huangzhu0423/esp32-waterer/docs/PCB.md

# 打板方案：主控载板与远端无源分线板

> **2026-11-12 更新：本文件现在讲两块板，别混。**
> - **先做 · 第十一节**：花盆区的**远端无源分线板**（RJ45 进 + 6× 3P 直插座出），已设计完、随时可下单。
> - **以后做 · 第十二节**：主控箱的**主控载板**，用户 2026-11-12 表示以后想打，规划中；5V 排针焊位与防倒灌在 **12.3**。
> - **零 ~ 十节**：配件到货前写的**分立 MOS 载板**设计，保留作资料（元件取值 / 66 条网表 / DRC 清单仍有参考价值），**不建议照着直接打**，差异见 **12.1**。
>
> 供电结论见 `docs/WIRING.md` 第三节：5V 默认走 **USB-C 取电线**，排针只在主控载板上留 NC 焊位。

## 零、结论与边界（分立 MOS 版资料）

**可以打，但别照这版打** —— 配件到货后已改用两块成品 YYNMOS-4 模块，见 **12.1**。第十节的「分配板」本质就是一块手工版本的 PCB，把 3 条汇流排、6 路 MOS、24 个阻容、全部端子固化到板上，飞线只剩探头线和泵线。

三条边界必须先划清楚，否则打回来的板装不上或不能用：

| 不进 PCB | 原因 | 正确做法 |
|---|---|---|
| ESP32 芯片 / WiFi 射频 | 射频布局、天线净空、阻抗不是 DIY 能一次做对的 | 用 **2×15 排母**把现成的 DevKit 模块插上去，坏了也能换 |
| 6 个水泵本体 | 大电流、要防水、要能单路更换 | 板上只留 **2P 可插拔螺丝端子** |
| 6 个探头本体 | 线要拉到花盆，长度不定 | 板上只留 **3P 可插拔端子** |

> **最容易被忽略的坑**：ESP32 DevKit 是板载 PCB 天线。载板在天线投影区域**绝不能铺铜、不能放元件、不能走线**，最好让模块天线那一端**伸出板边 5mm 以上**。不做净空，WiFi 会明显变差甚至连不上路由器，而远程页全靠 WiFi。

**排针中心距要实测**：30 针 DevKit 常见两排中心距 **25.4mm**，但也有 **22.86mm** 的窄版。下单前用游标卡尺量手上这块，再定两个排母的间距；排母用 2.54mm 间距、2×15。

## 一、板子规格

| 项目 | 取值 |
|---|---|
| 层数 | **2 层**（6 路低速直流，没必要 4 层） |
| 板材 / 板厚 | FR-4 / **1.6mm** |
| 铜厚 | 1oz 够用，**2oz 更稳**（泵 1.5A 峰值压降更小，加价不多） |
| 建议尺寸 | 约 **100 × 75mm**，压在 10×10cm 内打样最便宜 |
| 最小线宽 / 线距 | 0.25mm / 0.25mm（常规 6/6mil 工艺） |
| 过孔 | 0.6mm 孔 / 0.3mm 钻，盖油 |
| 表面处理 | 无铅喷锡或沉金；绿油白字 |
| 安装孔 | 4 × M3（孔径 3.2mm），四角各留 5mm 禁布区 |
| 打样 | 2 层 10×10cm 内通常是几十元 / 5 片、2~4 天出货，**以官网实时报价为准** |

## 二、板上集成什么

| 区域 | 内容 |
|---|---|
| ESP32 插座区 | 2×15 排母 ×2（或一条 2×15 双排座）、3V3 去耦、天线净空区 |
| 汇流排 | 3V3（VCC_S）、GND 地平面、5V_P 粗铜皮，横贯板中部 |
| 低边驱动区 | 6 × N-MOS + 每路 100Ω / 10k / 1N4007 / 100nF |
| 探头信号区 | 每路 100k 下拉，可选 1k + 100nF 的 RC 滤波 |
| 探头供电 | V1 留 6P 端子外接继电器模块；V2 焊 P-MOS 高边（见第六节） |
| 端子区 | 5V 输入 2P、泵 6×2P、探头 6×3P，全部可插拔 |
| 测试点 | 每路 Gate / AOUT 各 1 个，3V3 / 5V / GND 各 1 个 |

**丝印必须标**：`CH1`~`CH6`、每个 ESP32 引脚的丝印名（`VP/VN/D34/D35/D32/D33`、`D13/D18/D19/D23/D25/D26`、`D27`）、电解电容 `+`、1N4007 阴极方向、所有端子极性。装错一根线要拆半天，丝印是最便宜的保险。

## 三、网络表

完整逐行版见 [`pcb/netlist.csv`](pcb/netlist.csv)，画原理图时按它逐个核对，避免漏网。主干网络：

| 网络 | 从 | 到 | 线宽 / 做法 |
|---|---|---|---|
| `5V_P` | 5V 输入 + | 6 个泵端子 1 脚 | **≥2mm 铜皮或铺铜区**，1.5A 峰值 |
| `PGND` | 5V 输入 − | 6 个 MOS Source | 底层**整片地平面** |
| `PUMP1_N`~`PUMP6_N` | 泵端子 2 脚 | 对应 MOS Drain | ≥1.0mm，每路 0.8A |
| `GATE1`~`GATE6` | ESP32 泵脚 | 串 100Ω → MOS Gate | 0.3mm |
| `GATE_PD1`~`GATE_PD6` | MOS Gate | 10k → GND | 0.25mm，**上电不误开的关键** |
| `FLY1`~`FLY6` | 1N4007 阴极→泵 +、阳极→泵 − | 就近并在泵端子旁 | 0.8mm |
| `3V3` | ESP32 3V3 | 继电器 DC+ / COM（或 P-MOS S） | ≥0.5mm + 470µF |
| `VCC_S` | 继电器 NO（或 P-MOS D） | 6 个探头端子 VCC | ≥0.5mm |
| `AOUT1`~`AOUT6` | 探头端子 AOUT | ESP32 ADC 脚 | 0.25mm，**包地、远离泵线** |
| `AOUT_PD1`~`AOUT_PD6` | AOUT | 100k → GND | 0.25mm，必须有 |
| `SENSOR_PWR_CTRL` | ESP32 D27 | 继电器 IN（或 P-MOS G） | 0.3mm |
| `GND` | 全板 | — | 底层铺铜，多打地过孔 |

## 四、BOM

| 位号 | 元件 | 封装 | 数量 |
|---|---|---|---|
| U1 | ESP32 DevKit 30P 插座 | 2×15 排母 2.54mm | 2 |
| Q1~Q6 | N-MOS **AO3400** 或 IRLZ44N | SOT-23 / TO-220 | 6 |
| D1~D6 | 1N4007 | SOD-123 / DO-41 | 6 |
| RG1~RG6 | 100Ω | 0603 | 6 |
| RPD1~RPD6 | 10kΩ | 0603 | 6 |
| RAD1~RAD6 | 100kΩ | 0603 | 6 |
| RS1~RS6 | 1kΩ（可选 RC） | 0603 | 6 |
| CA1~CA6 | 100nF（可选 RC / 每路去耦） | 0603 | 12 |
| C1 | 470µF 电解（3V3 侧） | D6.3 / SMD | 1 |
| C2 | 470µF 电解（5V 侧） | D8 / SMD | 1 |
| C3 | 10µF（VCC_S 母线） | 0805 | 1 |
| K1 | 探头供电继电器模块（V1 外接） | 板上只留 6P 端子 | 1 |
| Q7 | P-MOS AO3401 / SI2301（V2） | SOT-23 | 1 |
| RPU | 10k 上拉（V2） | 0603 | 1 |
| J0 | 5V 输入 2P | 5.08mm 可插拔端子 | 1 |
| JP1~JP6 | 泵 2P | 5.08mm 可插拔端子 | 6 |
| JS1~JS6 | 探头 3P | 3.81mm 可插拔端子 | 6 |
| — | 测试点 / M3 铜柱 | — | 若干 |

> **MOS 选型别踩坑**：必须是**逻辑电平 N-MOS**，3.3V 栅极能完全导通。AO3400（SOT-23，约 5A）、IRLZ44N（TO-220）都行；**IRF520 不行**，它要 5V 以上才饱和，3.3V 驱动会半导通发热。

## 五、布局分区

```
┌──────────────────────────── 板框 100 × 75mm ────────────────────────────┐
│ 天线净空区（禁铺铜/禁元件，模块伸出板边）                                │
│  ┌──────────────┐        3V3 / GND / 5V_P 三条汇流排横贯                │
│  │  ESP32 插座  │   ┌──────────────────────────┐   ┌─────────────────┐  │
│  │  2×15 排母   │   │  Q1~Q6 + 100Ω/10k/1N4007 │   │ JP1~JP6 泵端子  │  │
│  │  （左侧）    │   │  低边驱动区（中部）        │   │ J0 5V 输入      │  │
│  └──────────────┘   └──────────────────────────┘   │ （右侧功率区）   │  │
│  ┌──────────────────────────────────────────────┐  └─────────────────┘  │
│  │ JS1~JS6 探头端子 · 100k 下拉 · K1/Q7 供电开关 │                       │
│  │ （下方信号区，远离右侧 5V 粗铜皮）             │                       │
│  └──────────────────────────────────────────────┘                       │
└─────────────────────────────────────────────────────────────────────────┘
```

**强弱电分区是硬要求**：右侧 5V 粗铜皮和泵回路，与下方 AOUT 信号线**不要平行长距离走线**，中间用地平面隔开。泵启停的电流突变会耦合进 ADC，表现为「一浇水其他路读数乱跳」。

## 六、两个版本，固件改动不同

| | V1 保守版（建议先做） | V2 全贴片版 |
|---|---|---|
| 探头供电 | 板上留 6P 端子，外接现有 JQC-3FF 继电器模块 | P-MOS 高边开关焊在板上 |
| 电路 | 端子：`DC+ / DC− / IN / COM / NO`（+ 3V3） | 3V3→P-MOS S，D→VCC_S，G→D27 + 10k 上拉到 3V3 |
| 固件 | **一个字都不用改**，不用重烧 | `config.h` 里 `SENSOR_PWR_ACTIVE_LOW` 由 `0` 改成 `1`，重编译烧录一次 |
| 优点 | 复用现有元件、零风险、已实测通 | 无继电器浪涌、无触点氧化、板子更小巧无声 |
| 缺点 | 板上多一块外接模块、有吸合声 | 要改一行固件并重烧 |

V2 的 10k 上拉很关键：复位期间 GPIO27 高阻，上拉把 P-MOS 栅极拉到 3V3（Vgs≈0）保持关断，探头不会意外上电。这和现有的 `config.h` 方案 B 描述一致。

**`PUMP_ACTIVE_LOW = 0` 两版都保持不变** —— 低边 N-MOS 高电平导通，板上和现在飞线完全一致。

## 七、下单前检查清单

1. **量排针中心距**（25.4 还是 22.86mm），核对排母封装
2. **天线净空区**确认无铜、无元件、无丝印覆盖，模块天线端伸出板边
3. DRC 通过；`5V_P` 与 `GND` 间距 ≥0.5mm，泵回路铜皮够宽
4. 所有电解电容、1N4007、MOS 的 **G/D/S 极性丝印**核对一遍
5. 底层 GND 铺铜，功率区多打地过孔；AOUT 线两侧包地
6. 每个网络在 `pcb/netlist.csv` 里都能对上，**尤其是 6 个 10k 栅极下拉和 6 个 100k AOUT 下拉**（最容易漏）
7. 导出 Gerber 后用 Gerber 查看器看一遍板框、孔径、阻焊开窗

## 八、板子回来怎么验

1. **空板**：万用表量 5V ↔ GND 不短路，所有 GND 全通
2. **只焊最小系统**：电源部分 + 两个排母 + 去耦，插 ESP32，USB 供电看能否启动、WiFi 能否连上
3. **焊 1 路**：Q1 / 100Ω / 10k / 1N4007 / 100k + JP1 + JS1，接 CH1 探头，验 `raw≈2600~2900 / flt=0`
4. **点浇水**：量 TP_GATE1 变 3.3V、泵转 15 秒；不接泵也能先量电压
5. **再焊其余 5 路**，每焊一路读一次 `/api/state`；逐路点浇水看其他路读数不跳
6. 最后补 470µF 电解（若第 2 步没装），确认继电器/P-MOS 吸合瞬间不复位

## 九、和第十节的关系

第十节是**不用打板也能落地**的手工版（万能板 + 端子台），本节是同一套网络的 PCB 版。两者引脚定义、元件取值、固件完全相同，可以先按第十节用万能板验证 1~3 路，确认方案没问题再下单打板 —— 板子一旦投出去，改一根线就要等一周。

## 十、成本估算

> 2026-11 查询嘉立创官网与公开报价，**实际以下单页实时报价为准**，免费券规则每月可能调整。

### PCB 本身

| 项目 | 价格 | 说明 |
|---|---|---|
| 2 层 FR-4，10×10cm 内，5 片 | **¥0**（免费券）或 **¥20 起**（付费） | 官网标注 FR-4 免费打样 ¥20.00 / 5 片起 |
| 每月免费券 | **2 次 × 5 片，包邮** | 1~2 层、10×10cm 内、板厚 1.6mm、铜厚 1oz、绿油白字、有铅喷锡 |
| **本板 100×75mm** | **完全落在免费条件内** | 2 层 / 1.6mm / 1oz / 绿油 |
| 2oz 铜 / 沉金 / 其他阻焊色 | 补差价约 **¥20~60** | 免费券只覆盖默认工艺，沉金实测有补 ¥28 的案例 |
| 付费单运费 | 约 ¥8~15 | 免费券通常包邮 |

免费券**有有效期**，正确顺序是：画完板 → DRC 通过 → Gerber 查看器检查无误 → 再领券下单。别先领券再慢慢画板。

### 元件（自购散买估算，以下单时 BOM 配单报价为准）

| 类别 | 数量 | 小计 |
|---|---|---|
| AO3400 SOT-23 ×6、1N4007 ×6、P-MOS ×1（V2） | 13 | ¥4~8 |
| 0603 阻容（100Ω/10k/100k/1k/100nF，约 36 只） | 36 | ¥4~8 |
| 470µF 电解 ×2、10µF ×1 | 3 | ¥3~5 |
| 2×15 排母 ×2 | 2 | ¥3~5 |
| 可插拔端子：J0 2P ×1、JP 2P ×6、JS 3P ×6 | 13 | ¥10~18 |
| M3 铜柱、测试点、杂项 | — | ¥3~5 |
| **合计** | — | **约 ¥27~49** |

ESP32 DevKit 和探头供电继电器模块手上已有，不计入。

### 三档总成本

| 方案 | PCB | 元件 | SMT | 合计 |
|---|---|---|---|---|
| **A. 空板 + 全手焊（推荐）** | ¥0（券）/ ¥20 | ¥27~49 | — | **¥27~49**（付费板约 ¥50~70） |
| B. 空板 + SMT 只贴 SMD | ¥0 / ¥20 | ¥27~49 | 工程费 ¥50 起 + 焊点约 ¥1 | **¥80~120** |
| C. 2oz 铜 / 沉金 + 手焊 | ¥20~60 | ¥27~49 | — | **¥50~110** |

**本板用 SMT 不划算**：贴片件约 110 个焊点，焊点费低至 ¥0.005~0.01/点（合计才 ¥1 左右），但**工程费 ¥50 起**；而且排母、13 个端子、3 只电解都是插件件，SMT 打样不含，仍然要自己焊。元件全是 0603 以上、SOT-23 封装，手焊半小时能搞定，没必要花这 50 元。

### 和手工搭的对比

万能板 + 两组端子台 + 杜邦线约 **¥30~60**，还要花几小时接线，且螺丝压接点长期容易接触不良。**用免费券打板反而更便宜、更可靠**，只是多了画板和等 2~4 天的时间。

### 真实预算按两版准备

第一版大概率要改一处丝印、一排封装或一根漏掉的线，按 **V1 验证 + V2 修正** 两版准备：每月 2 次免费券正好覆盖，现金支出主要是元件和运费，**总共约 ¥60~100** 就能拿到 5 片可用板。

---

## 十一、另一块板：远端无源分线板

> 用户 2026-11-12 表示**以后想打主控载板**，那是主控箱里的**第二块板**，规划见**第十二节**；两块板分阶段做，先做本节这块。本文件前十节是配件到货前的分立 MOS 设计，保留作资料、**不建议照着直接打**（12.1 有对照）。下面这块是**完全不同、更小更简单**的板：装在花盆区中心的分线盒位置，替代端子 + 汇流排 + 盒内跳线。**最终形态是「进线 RJ45 水晶头 + 出线 6 个 3P 直插座」，整盒零接线、探头直插**。业务背景见 `docs/WIRING.md` **5.7 / 5.8 / 5.9** 与第十四节。**这块板不改 ESP32 供电**：打板后 5V 仍经 USB-C 取电线送达，排针方案只在第十二节的主控载板上谈（NC 焊位见 **12.3**），详见 WIRING 第三节「打板之后要不要改走排针」。

### 和主控载板的区别

| 对比 | 第十二节主控载板（规划） | 本板 |
|---|---|---|
| 位置 | 主控箱，ESP32 DevKit 插在板上 | 花盆区分线盒 |
| 元件 | 装**成品模块**（两块 YYNMOS-4 + 继电器 + ESP32），底板本身无芯片；前十节分立 MOS 版仅作资料 | **无有源元件**，只有连接器（RJ45 + 6×3P 座）+ 可选 0805 / 0603 焊位 |
| 电流 | 泵 5V / 单路 100~200mA（固件互斥），**1oz 够** | VCC_S 仅 30~120mA / 3.3V，**1oz 足够** |
| ESP32 供电 | 底板留 `J_USBC` / `J_5V` + `JP_5V` 二选一焊位（12.3） | **完全不参与**：板上没有 5V、没有泵电源、没有 ESP32 排针；ESP32 仍走 USB-C 取电线，见 WIRING 第三节「打板之后要不要改走排针」 |
| 难点 | 天线净空、排母中心距、强弱电分区 | 只有线序丝印与 AOUT 走线间距 |
| 层数 / 尺寸 | 2 层 100×75mm | **2 层 70×50mm**（出线改 3P 直插座并排 6 个时建议 80×50mm） |
| 网表 | 前十节 `docs/pcb/netlist.csv`（66 条，分立 MOS 版资料） | 本节 20 条 |

### 规格与布局

2 层 FR-4 / 1.6mm / 1oz / 绿油白字 / 有铅喷锡 / **70×50mm**（出线改 6 个 3P 直插座并排时建议 **80×50mm**），都落在 10×10cm 免费打样条件内（第十节）；4 个 M3 安装孔 + 铜柱垫高 5mm。

```
左侧 1× RJ45 8P8C 母座（或 KF301-8P 二选一焊位）──→ 中部 VCC_S / GND 各一条 2mm 铜皮汇流 ──→ 右侧 6× 3P 出线位
   丝印印 T568B pin 号 + 线色    6 条 AOUT 短直走线（间距 ≥2W）     3P 直插座 或 KF301-3P 二选一焊位
                                                                  印 CH1~CH6 / VCC / GND / AOUT / 缺口方向
```

`VCC_S` 铺铜**不要覆盖 AOUT 走线下方**（分布电容耦合）；每路留 `100kΩ` 0805 与 `100nF` 0603 焊位：

- **端子版**：默认 NC 不装 —— 按 WIRING 5.6，电阻并在探头插头根部；只有选「盒内侧」备选方案才在板上贴，且此时探头端不再并。
- **3P 直插版**：**推荐把 6 只 100kΩ 0805 直接贴到板上**，探头端彻底干净、插头才插得进（理由见下一节）；此时探头端 / 插头上都不要再并，否则同路两只并联成 50k、干湿点标定值要重做。

`100nF` 仅 10~30m 时装。

### 进线改 RJ45 水晶头（推荐版）

**能加，而且比 `KF301-8P` 更合适。** 网线单芯 24AWG ≈ 0.2mm²，`KF301` / `TB-1508` 这类螺钉端子压不紧，虚接几个月后读数就飘（WIRING 5.2）；水晶头压接是网线的标准工艺，8 根芯一次压完、接触电阻小、不会松，还顺带省掉盒端 8P 端子和一盒 `E0508` 管形端子。

**买哪种座（这里最容易买错）**

| | 搜词 / 特征 |
|---|---|
| **要买** | `8P8C RJ45 母座 直插 180度 无灯 无变压器` / `网线插座 PCB 立式 8P8C`；普通 8 个触点直通、可过直流，最好选镀金触点 |
| **绝对别买** | `HR911105A`、`带网络变压器`、`带 LED 指示灯`、`以太网网口模块`、`RJ45 网络滤波器` —— 这类是给以太网 PHY 用的，内部串了 1:1 隔离变压器和中心抽头，**直流完全隔断**，3.3V 探头供电和 0~3V 的 AOUT 一路都过不去，板子直接不通 |
| 不用买 | `RJ45 母对母直通头 / 网络对接头`（转接件，不是 PCB 焊接座） |

RJ45 座占位约 16×21mm，比 `KF301-8P`（8×5.08 ≈ 41mm 长）**还短**，70×50mm 完全够，不必改板框；开口朝板边、弹片朝盒内侧，插拔方向留出 ≥20mm 空间。**建议把 RJ45 座与 `KF301-8P` 画成同一组 8 个网络的二选一并联焊位**，5 片板回来想用哪种焊哪种（只焊一个、只插一个），几 mm 的 stub 对 ADC 无影响。

**T568B 引脚映射（关键：RJ45 pin 号 ≠ 原端子编号）**

水晶头两端**都按 T568B 压，直通线，不要做交叉线**。弹片朝下、金属触点朝自己，从左到右 pin1~8：

| RJ45 pin | T568B 线色 | 本板网络 | 主控端 | 原 `KF301-8P` 位号 |
|---|---|---|---|---|
| 1 | 橙白 | `AOUT1` | `VP / GPIO36` | `JIN.1` |
| 2 | 橙 | `AOUT2` | `VN / GPIO39` | `JIN.2` |
| 3 | 绿白 | `AOUT3` | `D34` | `JIN.3` |
| 4 | **蓝** | `AOUT6` | `D33` | `JIN.6` |
| 5 | **蓝白** | `AOUT5` | `D32` | `JIN.5` |
| 6 | **绿** | `AOUT4` | `D35` | `JIN.4` |
| 7 | 棕白 | `VCC_S` | 继电器 `NO` | `JIN.7` |
| 8 | 棕 | `GND` | ESP32 `GND` | `JIN.8` |

> **最要命的一个坑**：第十四节原来那张色序表是给 `KF301-8P` 自编的位号（4=绿 / 5=蓝白 / 6=蓝），而 **T568B 的 pin4/5/6 是 蓝 / 蓝白 / 绿，正好反着**。换 RJ45 时**不能把 `JIN.4/5/6` 直接当成 `RJ.4/5/6`**，否则 CH4/CH5/CH6 三路全错位，现象是「三路读数一模一样或全 `flt=1`」。上面的表按**线色**对应，颜色不变、业务通道不变，只是 pin 号重排。
>
> **第二个坑**：RJ45 母座在 PCB 上的焊盘编号**不一定等于水晶头触点编号**（带定位脚、带弹片、不同厂家会反序）。画板前先插一根按 T568B 压好的短网线，用万用表通断档**逐脚实测触点 ↔ 焊盘**，以实测结果定网表，别照抄任何型号图纸。

**主控端怎么收口**：主控箱那头要散到 ESP32 的 8 个针脚，最省事是买一块成品 `RJ45 母座转 8P 螺丝端子板` / `网线转接板 RJ45 to terminal`（约 ¥3~8），8 个端子位印 1~8，按 T568B 色表把橙白→`VP`、橙→`VN`…棕白→继电器 `NO`、棕→`GND` 接上；网线细芯进螺钉端子仍要套 `E0508` 管形端子或对折双股。也可拿 5 片板中的一片只焊 `RJ45 + 8P 端子` 当主控端转接板。

**这几条不能破**

1. **这个口只过探头供电和 6 路高阻 AOUT**：`VCC_S` 最大约 120mA / 3.3V，6 只探头 20mA 一只，RJ45 触点余量很大。**泵 5V / 数 A 绝不能走 RJ45**，电源和两块 YYNMOS-4 全部留在主控箱。
2. **RJ45 不防水**：照样按 WIRING 5.1 装倒扣盒、插口朝下、孔在底面；插好后接头外套一段带胶热缩管或自粘胶带缠住（别把热缩管烘到塑料座变形），潮湿处选镀金触点。户外段用**室外型 PE 护套超五类**（抗 UV），室内线露天一两年外皮就粉化。
3. **距离上限不变**：改成水晶头只是接头形式变了，线径和 4 对双绞没变，仍按 ≤10m 默认；10~30m 照 WIRING 第十四节第 7 步换两根屏蔽网线并装板上 `100nF`，>30m 搬主控。RJ45 化**不会**把 10m 变成 100m。
4. 屏蔽网线（STP）+ 金属壳座时，**屏蔽层只在主控端接 ESP32 GND**，分线盒端剪断包绝缘；两头都接成地环路反而更吵。UTP 非屏蔽最省事。
5. 水晶头插拔寿命有限，装好后别反复拔；要改线在主控端端子板上改。

**成本变化**：RJ45 座 ¥0.5~2、水晶头 ¥0.1~0.3/个（一包 20 个 ¥2~5）、最便宜压线钳 ¥15~25（可借，或直接买成品网线剪一头只压另一端）、主控端转接板 ¥3~8；同时省掉盒端 8P 端子和管形端子。**有免费券打板的总额基本不变（仍约 ¥10~15）**，白拿一个更可靠的接头。

**第一批只有 CH1 也能先压**：干线两端照样 8 芯全压满，主控端只接 橙白 / 棕白 / 棕 3 根，其余 5 根贴好标签留空；板上只装 CH1 的 3P 端子，CH2~CH6 空着显示 `flt=1` 属正常。后面扩路直接把剩下的芯接上，不用重压线。

### 出线改 3P 直插座：探头免接线直插

**对，打板的最终形态就该是这样** —— 板上 6 个 3P 座 + 进线 1 个 RJ45 座，整个分线盒里 **0 根跳线、0 根短线、0 个螺丝孔**，探头线插上就完事，连"压 18 根三芯线"都省了。这是 70×50mm 无源板最干净的用法。

**但先确认插头方向别买反**：手上 HW-390 是**板上一个 PH2.0-3P 白色座 + 一根转接线**，转接线末端是**三个独立的 2.54mm 杜邦母头**（WIRING 第十二节「端子形状不匹配」已记）。母头要插的是**公针**，所以板上焊的严格说是 **3P 公座 / 直排针**；口语说的「3P 母座」如果指"座子"没问题，如果真买成 **3P 母座（孔）就会母对母插不上**。

| 探头线末端实物 | 板上该焊 | 搜词 | 防呆 |
|---|---|---|---|
| 三个散的 2.54 杜邦母头（**当前这套**） | `3×1 2.54 直排针` 或 `XH2.54-3P 直针座` | `XH2.54-3P 直针座 带扣` / `3P 2.54 直排针` | 散杜邦头**没有防呆** |
| 一体 PH2.0 白色 3P 公插头 | `PH2.0-3P 直针座` | `PH2.0-3P 直针座 卧贴/立贴` | 带凸台，最好 |

> **下单前拿卡尺量一下**：插头相邻两针中心距 **2.0mm → PH2.0**，**2.54mm → 杜邦 / XH2.54**，买错完全插不进。XH2.54 与杜邦胶壳的卡扣**互不通用**，要买就买配套的座 + 胶壳；想彻底防呆，把三个散杜邦母头压进一只 `3P 2.54 杜邦母胶壳`（¥0.1），板上焊带扣的 3P 直针座，插反插不进去。

**三个直插特有的坑**

1. **线长最要命**。原设计「分线盒放 6 只探头几何中心、每根 ≤2m 短线」的前提是能自己剪线；探头自带转接线通常只有 **20~30cm**，直插就等于要求 6 只探头都挤在板子 30cm 内。两条出路：把花盆往板子边靠；或买 **3P 2.54 公对母延长线 1~2m**（成品 ¥1~2/根，6 根 ¥6~12，仍是直插、不用压线），PH2.0 版本同理买 `PH2.0-3P 延长线`。**别为了直插把板子挪离几何中心去迁就一根短线**，那样 6 根模拟线又变长了。
2. **100kΩ 别再并在插头上**。5.6 默认的「探头插头根部并电阻 + 双壁含胶热缩管」会让插头鼓包，插不进 3P 座、相邻座还会打架。直插版改走 5.6 的**盒内侧备选**：把 6 只 `100k 0805` 贴到板上现成的 NC 焊位（等价于电阻固定在远端的座位上），或焊到探头 PCB 的 `AOUT/GND` 焊盘（5.6 做法 B）。**两处只选一处**。代价按 5.6「一个诚实的例外」：拔掉探头后主控侧 AOUT 悬空，但 `36/39/34/35` 无内部上拉、实测 `raw=0/65/60 < ADC_OPEN_RAW(400)`，仍稳定判 `FLT_OPEN`，不会误开泵。
3. **插反代价很大**。3P 座必须 6 个方向完全一致，座旁丝印印 `CH1…CH6` + `VCC / GND / AOUT` + **缺口方向三角标记**；插反把 3.3V 顶到 AOUT 会读成满湿度、可能乱开泵。散杜邦头没有防呆，第一次插之前用万用表按座上丝印逐根对一遍。

**布局与机械**

- `XH2.54-3P` 带扣座宽约 9~10mm，6 个并排按 ≥11mm 中心距要 66mm，加板边和 M3 孔 **70mm 宽很紧 → 建议板框放宽到 80×50mm**（仍在免费打样内）；`PH2.0-3P` 窄约 6.5mm，70mm 够。也可排成 **2 排各 3 个**保持 70×50mm。
- 座子选**直针（垂直板面插）**还是**卧式（贴板边水平插）**取决于盒子：板平放、座朝上最好插但最容易积水；建议板**竖装或斜装**、插口朝侧面或略朝下，与 5.1 的"孔朝下 + 倒扣盒"一致。
- 探头线被拉扯时力**直接传到 PCB 焊盘**，比螺丝端子脆弱得多：板边每个座旁留一个 **Ø3 扎带孔 / 线卡位**，插好后用扎带把探头线束固定在板上，或点一点热熔胶在胶壳上（别糊住触点、别用酸性硅胶）。座子选带扣款，别用裸排针长期露天。

**防水**：PH2.0 / 杜邦 / XH 座都**不防水**，而且不能像螺丝端子那样整束灌胶。按 WIRING 5.1 装倒扣盒、插口朝下、板面刷一层三防漆（**避开座内触点与插合面**）；插头外套一小段带胶热缩管只能护线、护不了插合面，真正管用的还是"换位置不淋雨"。凝露会让 `VCC_S` 与相邻 AOUT 漏电，盒内放干燥剂。

**成本**：省掉 `KF301-3P`×6（约 ¥6）、18 根三芯短线、压线工时与管形端子；改买 6 个 3P 座（¥1~3）+ 6 根延长线（按需 ¥6~12）+ 板上 6 只 100k 0805（几分钱）。**有免费券打板总额仍约 ¥10~20**，换来的是"整盒零接线"。

**验收**：断电通断档量 `RJ45 pin7` ↔ 6 个座的 `1(VCC)` 全通、`pin8` ↔ 6 个座的 `2(GND)` 全通、各座 `1/2/3` 两两不短、任意两路 `3(AOUT)` 不导通；板上贴了 100k 的话，每路 `3 ↔ 2` 应量到约 100kΩ。再只插 CH1 一只探头，上电应 `flt=0 / raw 1000~3000`、其余 5 路 `flt=1`；若 CH1 `raw` 顶满或 `flt=1`，**立刻断电查插头有没有插反**。

### 网表（20 条，画原理图时作 checklist）

```csv
net,from,to,width_mm,note
VCC_S,RJ.7 / JIN.7 / 棕白,J1..J6.1 / TP_VCC,2.0 铜皮,探头供电母线 继电器 NO 来 绝不经过板上开关
GND,RJ.8 / JIN.8 / 棕,J1..J6.2 / TP_GND,2.0 铜皮,探头地全程直连 绝不断地
AOUT1,RJ.1 / JIN.1 / 橙白,J1.3,0.25 短直包地,CH1 -> VP/GPIO36
AOUT2,RJ.2 / JIN.2 / 橙,J2.3,0.25 短直包地,CH2 -> VN/GPIO39
AOUT3,RJ.3 / JIN.3 / 绿白,J3.3,0.25 短直包地,CH3 -> D34
AOUT4,RJ.6 / JIN.4 / 绿,J4.3,0.25 短直包地,CH4 -> D35 T568B pin6 别按端子位号搬
AOUT5,RJ.5 / JIN.5 / 蓝白,J5.3,0.25 短直包地,CH5 -> D32 T568B pin5
AOUT6,RJ.4 / JIN.6 / 蓝,J6.3,0.25 短直包地,CH6 -> D33 T568B pin4 别按端子位号搬
AOUT1_PD,J1.3,R1(100k 0805).1 -> GND,0.25,默认 NC 不装 板上装则探头端不装
AOUT2_PD,J2.3,R2(100k 0805).1 -> GND,0.25,默认 NC 不装
AOUT3_PD,J3.3,R3(100k 0805).1 -> GND,0.25,默认 NC 不装
AOUT4_PD,J4.3,R4(100k 0805).1 -> GND,0.25,默认 NC 不装
AOUT5_PD,J5.3,R5(100k 0805).1 -> GND,0.25,默认 NC 不装
AOUT6_PD,J6.3,R6(100k 0805).1 -> GND,0.25,默认 NC 不装
AOUT1_RC,J1.3,C1(100nF 0603).1 -> GND,0.25,仅 10~30m 装 与 R1 并联
AOUT2_RC,J2.3,C2(100nF 0603).1 -> GND,0.25,仅 10~30m 装
AOUT3_RC,J3.3,C3(100nF 0603).1 -> GND,0.25,仅 10~30m 装
AOUT4_RC,J4.3,C4(100nF 0603).1 -> GND,0.25,仅 10~30m 装
AOUT5_RC,J5.3,C5(100nF 0603).1 -> GND,0.25,仅 10~30m 装
AOUT6_RC,J6.3,C6(100nF 0603).1 -> GND,0.25,仅 10~30m 装
```

`RJ.n` = RJ45 母座对应的**水晶头 T568B 触点号**（默认进线方式，pin4=蓝 / pin5=蓝白 / pin6=绿）；`JIN.n` = `KF301-8P` 备用焊位（1~8 按自定义色序：橙白 / 橙 / 绿白 / 绿 / 蓝白 / 蓝 / 棕白 / 棕）。**两者是同一组 8 个网络的二选一并联焊位，只焊一个、只插一个**，业务通道一律按**线色**对应，别按位号搬。`J1…J6` = 6 个 3P 出线位，**直插版焊 3P 直插座、端子版焊 `KF301-3P`，两者二选一并联焊位**（`1=VCC / 2=GND / 3=AOUT`）；封装换了但网络定义、20 条网表、`100k / 100nF` 焊位全都不变。

### 成本（沿用第十节 2026-11 报价）

| 情况 | 板 | 端子 / 座 | 运费 | 合计 |
|---|---|---|---|---|
| 端子版 · 有免费券 | ¥0 / 5 片 | `KF301-3P`×6 + `KF301-8P`×1 ≈ ¥8~15 | 包邮 | **约 ¥10~15** |
| **RJ45 版 · 有免费券** | ¥0 / 5 片 | `KF301-3P`×6 + RJ45 座 ≈ ¥8~16 | 包邮 | **约 ¥10~15** |
| **RJ45 + 3P 直插版 · 有免费券** | ¥0 / 5 片 | 3P 座×6 + RJ45 座 ≈ ¥2~5（+ 延长线按需 ¥6~12） | 包邮 | **约 ¥10~20** |
| 无券 | ¥20 起 | ¥8~16 | ¥8~15 | **约 ¥35~50** |

RJ45 版另有：主控端 `RJ45→8P 端子板` ¥3~8、水晶头一包 ¥2~5、压线钳 ¥15~25（可借 / 买成品网线只压一头）。端子版另有：`E0508` 管形端子一盒 ¥5~10（细线压螺钉必须）。两边总额基本持平，RJ45 版多买的是工具、省掉的是虚接风险。

对比：WIRING 5.3 省钱版 ¥9~25（但焊死不能改线）、5.2 舒适版 ¥60~110。**有券时打板反而最划算**；买的是「可插拔 + 线序丝印 + 盒子做小」，不是省钱。SMT 完全不用考虑 —— 全板只有可选贴片，且默认不装。

### 回板验证

1. 空板目检：铜皮无桥连、6 条 AOUT 之间无短路、丝印的 **T568B pin 号 + 线色** 与第十四节第 3 步线序表逐项对照。
2. 万用表通断档：`pin7 / JIN.7`（棕白）↔ `J1…J6.1` 全通；`pin8 / JIN.8`（棕）↔ `J1…J6.2` 全通；**任意两路 AOUT 之间不导通**；AOUT ↔ VCC_S 不导通。
   - **RJ45 版必做**：插一根两端按 T568B 压好的短网线，从另一端水晶头触点逐脚量到 6 个 3P 端子 —— `pin1→J1.3`、`pin2→J2.3`、`pin3→J3.3`、`pin6(绿)→J4.3`、`pin5(蓝白)→J5.3`、`pin4(蓝)→J6.3`。这一步同时验了「母座焊盘编号是否等于触点编号」，是防 CH4/5/6 错位的唯一保险。
3. 通电前按上面「出线改 3P 直插座」的验收段量一遍：`pin7` ↔ 6 个座 `1(VCC)` 全通、`pin8` ↔ `2(GND)` 全通、各座 `1/2/3` 两两不短、任意两路 `3(AOUT)` 不导通；板上贴了 100k 时每路 `3 ↔ 2` ≈ 100kΩ。
4. 焊上座 / 端子后逐路按 `docs/WIRING.md` 第十四节第 6 步验收（CH1 `flt=0` / raw 1000~3000，其余 `flt=1`）；直插版若 CH1 `raw` 顶满或 `flt=1`，**先断电查插头有没有插反**，再查线序。
5. 板子不防水：仍按 WIRING 5.1 装倒扣盒 / 孔朝下，或刷三防漆（**避开座内触点与插合面**，也别刷到端子接触面）。

**固件全程不用改、不用重烧**：这块板只做无源转接，`CHANNEL_COUNT = 6`、六路 ADC 引脚、采样时序、故障判定都是现成的。

---

## 十二、后续规划：主控载板（2026-11-12 用户表示以后想打）

用户 2026-11-12 明确「以后想打主控载板」。这和第十一节的远端无源分线板**不冲突，是两块板、两个阶段**：

| 阶段 | 板 | 位置 | 状态 |
|---|---|---|---|
| **先做** | 第十一节 远端无源分线板 | 花盆区分线盒 | 已设计完（RJ45 进 + 6×3P 直插座出），随时可下单 |
| **以后做** | 本节 主控载板 | 主控箱 | 规划中，等六路位置定死、CH1 验通再画 |

> **顺序别反**：先用杜邦线把 CH1 验通（`flt=0` / raw 1000~3000、点「浇 15s」肉眼出水）→ 定死六路点位画远端板 → 最后画主控载板。免费券每月 2 次 × 5 片，正好一块一版，别提前领券慢慢画。

### 12.1 先纠偏：前十节是「配件到货前」的设计，别照着直接打

| 前十节写的 | 现在手上实物 | 影响 |
|---|---|---|
| 板载 6× AO3400 N-MOS + 6× 1N4007 + 100Ω/10k | **两块 YYNMOS-4 成品 4 路模块**，MOS / 100Ω / 10k / 续流全在模块上 | 照前十节打 = 重复买料 + 重画 30 多个焊点，成品模块反而闲置 |
| 6× 3P 探头端子直接上主控板 | 探头在花盆区，走 8 芯干线 + **RJ45** 到远端分线板 | 主控板不再需要 6 个 3P 探头端子 |
| 100kΩ 下拉焊在主控板 | 直插版 **100kΩ 贴在远端板 0805 焊位** | 两处都装会并联成 50k，干湿点标定要重做 |
| 5V 输入 → 2oz 粗铜皮（按数 A 泵估算） | 到货 **USB 循环泵 100~200mA**，5V/5A 大幅富余 | **1oz 足够**，免费券默认工艺就行，2oz 补差价没必要 |
| 「5V 接 `VIN` 排针」 | 实物板**找不到清晰 `VIN` 丝印**，`VN`/`VP` 是 ADC 脚 | 见 **12.3**，必须改成二选一焊位 |

前十节留作**分立 MOS 方案资料**（元件取值、66 条网表、DRC 清单仍有参考价值），真正要打的是下面这版。

### 12.2 推荐形态：模块安装底板（仍然无源）

不重画驱动电路，把已到货的成品模块装到一块底板上，板子只负责**布线 + 端子 + 固定 + 丝印**：

| 区域 | 内容 |
|---|---|
| ESP32 区 | 2×15 排母 ×2（中心距**实测** 25.4 / 22.86mm），天线净空区禁铺铜禁放件，天线端伸出板边 ≥5mm |
| 供电区 | DC099 尾线 2P 端子 → 星形分线：粗铜皮去两块模块 `DC±`，细线去 `J_USBC`（USB-C 取电线 2P 端子） |
| 模块区 | 两块 YYNMOS-4 的安装孔 / 排母位；`PWM1~4 / GND1~4`、`PWM5~6` 从泵脚 `D13/D18/D19/D23/D25/D26` 引到模块上排焊盘 |
| 泵端子区 | 6× 2P 可插拔端子，接模块 `OUT±`；丝印 `CH1~6 / + / −` |
| 探头供电 | 继电器模块 6P 端子（`DC+/DC−/IN` + `COM/NO/NC`），跳线保持 **H** |
| 干线出线 | **1× RJ45 8P8C 直插母座（无变压器 / 无 LED）**，与远端分线板配对 |
| 去耦 / 测试点 | `J_USBC` 入口 100µF、`DC±` 入口 47µF、每泵端子 100nF；`3V3 / 5V / GND / AOUT1` 各留测试点 |

**全板仍然无芯片、无 LDO、无 MOS 管**（LDO 在 ESP32 板上、MOS 在成品模块上），难度和成本都接近第十一节那块，避开除天线净空外的所有射频 / 驱动坑。

### 12.3 5V 输入网络：排针焊位 + 防倒灌

**默认 5V 不走上板子的排针**：实物照片里找不到清晰 `VIN` 丝印，右上那个像 `VN` 的孔按标准排列虽是 5V 输入网络，但 `VN`/`VP` 真身是 GPIO39 / GPIO36（CH2 / CH1 的 AOUT 输入），**5V 灌进去打穿 ADC 且正好毁掉前两路探头**。所以底板这样留：

| 焊位 | 默认 | 说明 |
|---|---|---|
| `J_USBC` 2P 端子 | **装** | USB-C 取电线红 → VBUS / 黑 → GND，送 ESP32 的 USB-C 口；允许作为**板外飞线**，不必走 PCB |
| `J_5V` 2P 端子 + `JP_5V` 0Ω 跳线位 | **NC 不装** | 预留给「排针 5V」方案；只有按 **12.6** 实测确认 5V 输入网络真引出、且量到是哪个孔后，才贴 0Ω 接通排母对应脚 |
| `D_OR` 1N5819 焊位 | **NC** | 只有同时保留两个 5V 入口时才装：阳极朝外部 5V、阴极朝板内 5V 网络，做肖特基 ORing；压降约 0.3V（≈4.7V 仍在 AMS1117 允许范围） |

三条规矩：

1. **两个 5V 入口不同时供电**。用取电线时 `JP_5V` 断开；改走排针时拔掉取电线。烧录 / 看串口直接**拔 `J_USBC` 换电脑 USB 数据线**（同一个口，天然不会顶住）；若已启用排针方案，则必须先断 `J_5V` 或串 1N5819，防倒灌电脑 USB 口。
2. **丝印硬警示**：`J_5V` 旁印 `5V ONLY`，排母 `VN / VP / 3V3` 脚旁印 `3.3V MAX / ADC`，装配说明写「未实测前 `JP_5V` 保持 NC」。回板空板先量 `J_5V ↔ GND` 不短路、`J_5V ↔ 3V3` 不导通。
3. **电气等价，不是升级**：USB-C 口与 5V 排针进的是同一个 5V 输入网络、同样过板载肖特基与 AMS1117；排针只省一根取电线、方便 ESP32 插底板，代价是多一个接错 `3V3` / `VN` / `VP` 的致命风险点。

### 12.4 与远端分线板配对：RJ45 出线

主控板那只 RJ45 座必须和第十一节同规格：**8P8C 直插、无变压器、无 LED**（`HR911105A` 之类带网络变压器的，内部 1:1 隔离变压器把直流全断，3.3V 和 AOUT 一路都过不去）。两端都按 **T568B 直通**压，别做交叉线；丝印印 **pin 号 + 线色**，不要只印位号 —— **T568B 的 pin4/5/6 是 蓝 / 蓝白 / 绿，与旧端子位号 4/5/6 正好反序**：

| pin | 线色 | 主控板去向 |
|---|---|---|
| 1 | 橙白 | `VP / GPIO36` CH1 |
| 2 | 橙 | `VN / GPIO39` CH2 |
| 3 | 绿白 | `D34` CH3 |
| 4 | 蓝 | `D33` CH6 |
| 5 | 蓝白 | `D32` CH5 |
| 6 | 绿 | `D35` CH4 |
| 7 | 棕白 | 继电器 `NO` → `VCC_S` |
| 8 | 棕 | ESP32 `GND` |

母座**焊盘编号不一定等于触点编号**：画板前插一根压好的短网线，通断档逐脚量触点 ↔ 焊盘再定封装。原 6 个 3P 探头端子可留作**二选一焊位（NC）**，方便不接远端板时本地直插探头。

### 12.5 电源、共地与抗干扰（按到货实泵校准）

- 星形分线在底板上一次完成：**别从模块 `DC+` 端子再并一根给 ESP32**，泵电流压降与开关噪声会灌进去。
- 单电源下 `DC− ↔ ESP32 GND` **必然导通、属正常**（WIRING 十二节第 3 步的「不导通」只在双电源调试时成立），别当短路拆线。
- 实泵 100~200mA / 5V，固件互斥实际只开 1 路 → **1oz 铜够**；但 `DC±` 到模块那段仍按 ≥2mm 铜皮画，泵区与 RJ45 信号区**分开、不平行长距离走线**。
- 碳刷换向火花是 6 路 100kΩ 高阻 AOUT 的最大干扰源：泵线 / 模块与信号区分区、线距 ≥20cm，每泵端子就近并 100nF、`J_USBC` 100µF、`DC±` 47µF；浇水瞬间 `raw` 乱跳先查这里。
- **1N4007 不用装**（YYNMOS-4 自带续流），桌上那只别焊上板。
- 6 只 100kΩ **只贴远端板 0805 焊位**，主控板对应位置留 NC，两处只装一处。

### 12.6 下单前必须先做的三件实测

1. **排母中心距**：游标卡尺量两排排针，25.4 还是 22.86mm（第七节清单第 1 条）。
2. **5V 输入排针是否存在**：只插 USB 上电，黑笔 `GND`、红笔逐个量右侧顶部孔 —— ≈4.6~5V 才是 5V 输入，≈3.3V 是 `3V3`，`VN` / `VP` 悬空约 0V；断电也可量该孔 ↔ USB-C 母座 VBUS 焊盘是否直通（隔 LDO 的 `3V3` 不直通）。**没量出来就把 `JP_5V` 永久 NC，走 USB-C。**
3. **RJ45 母座焊盘编号**：插短网线逐脚通断档验证，防 CH4/5/6 错位。

### 12.7 成本与固件

底板 100×75mm 内、2 层 1oz 默认工艺，**免费券覆盖**。元件只有 2×15 排母 ×2、若干 2P 端子、1 只 RJ45 座、几只 0603 / 电解、M3 铜柱，约 **¥20~40**；成品模块 / ESP32 / 继电器手上已有，不重复买。比分立 MOS 版（前十节 ¥27~49 + 6× MOS / 二极管）更省，还少焊 30 多个点。

**固件 1.1.3 一个字都不用改、不用重烧**：`CHANNEL_COUNT = 6`、六个 ADC 脚、泵脚、`D27` 探头供电、跳线 **H**（高电平触发）全部沿用。只有把外接继电器换成**板载 P-MOS 高边开关**（前十节 V2）才要把 `SENSOR_PWR_ACTIVE_LOW` 改成 `1` 并重烧一次 —— 这版**不建议**，省一块继电器却多一次烧录。

> 一句话：**远端板打的是探头侧的线，主控载板打的是主控箱的线束整理；两块板都不改固件，5V 默认仍走 USB-C 口。**
