huangzhu0423/esp32-waterer/docs/API.md

# REST 接口

一切都在 `http://<设备IP>/` 下，同一份网页即客户端，不依赖外网。
所有响应都是 `application/json`，`ok:1` 表示成功，`ok:0` 时 `err` 给出原因。

## GET /

返回内嵌的 gzip 压缩单页（约 10KB）。带 `Content-Encoding: gzip`，浏览器自动解压，固件端零解压开销。

## GET /api/state

全量状态快照，前端每 2 秒轮询一次。约 700 字节。

```json
{
  "ok": 1,
  "fw": "1.1.3",
  "up": 84213,           // 运行秒数
  "heap": 236544,        // 可用内存
  "mode": "sta",         // sta | ap
  "ip": "192.168.1.42",
  "rssi": -58,
  "mqtten": 1,           // 配置里是否启用 MQTT
  "mqtt": 1,             // 当前是否真的连着 broker（1.1.3 起回读底层 socket）
  "timeOk": 1,           // 时间是否已同步（每日型定时任务依赖它）
  "q": 0,                // 排队数量
  "lock": 0,             // 掉电锁定剩余秒数
  "active": { "ch": 2, "src": "timer", "remain": 18 },
  "ch": [
    { "i":0, "raw":2410, "pct":41, "flt":0, "auto":1, "thr":30,
      "run":0, "q":0, "bud":0, "dry":3100, "wet":1400 }
  ]
}
```

`active` 为 `null` 表示空闲。`flt` 故障码：0 正常 / 1 断线 / 2 短路 / 3 卡死 / 4 噪声。
`run` 正在浇水，`q` 排队中，`bud` 本小时已用秒数。

> **1.1.3 起 `mqtt` 说真话**：旧版只看设备自己维护的 `s_conn`，TCP 早被 broker/NAT
> 掐断时也一直报 `1`，实际既不发状态帧也收不到指令。现在它是
> `s_conn && PubSubClient::connected()`，掉线会显示 `0` 并在 1.5 秒后自动重连。

## POST /api/pump

手动浇水或停止。

```json
{ "ch": 0, "action": "start", "sec": 20 }
{ "ch": 0, "action": "stop" }
```

失败时返回 `ok:0` 与原因：

| err | 含义 |
|---|---|
| `sensor_fault` | 该通道传感器故障，请先检查接线（手动也会被拒） |
| `budget` | 超出每小时累计上限 |
| `busy` | 队列满，或当前泵刚开始运行不到 3 秒不允许抢占 |
| `cooldown` | 自动浇水的最小间隔未到 |
| `lockout` | 检测到带泵复位，系统处于冷却期 |

`sec` 会被夹到 `1~300`。手动请求优先级最高，会抢占正在跑的自动/定时任务。

## POST /api/channel

```json
{ "ch": 0, "auto": 1, "thr": 35, "maxSec": 20, "minGapSec": 300 }
```

字段都可省略，只改传了的。`thr` 夹到 5~90，`maxSec` 夹到 1~300，`minGapSec` 夹到 0~7200。

## POST /api/calibrate

把当前读数直接记为干点或湿点。返回实测原始值。

```json
{ "ch": 0, "point": "dry" }
{ "ch": 0, "point": "wet" }
```

`dry` = 探头插在干土里时按；`wet` = 泡在水里时按。固件会强制保证干点 > 湿点 + 100，否则忽略。

## POST /api/calib_all

一键把 **6 路**当前读数同时记为干点或湿点。每路连采 3 组 9 次中位数再取中位数（共 27 次 ADC），比单次采样稳。单路标定请用 `/api/calibrate`。

```json
{ "point": "dry" }
{ "point": "wet" }
```

响应：

```json
{
  "ok": 1, "point": "dry", "applied": 5,
  "items": [
    { "i": 0, "raw": 2864, "st": 0 },
    { "i": 5, "raw": 12,   "st": 1 }
  ]
}
```

- `applied`：实际写入的通道数
- `items[].st`：`0` 正常，`1` 探头未接入/断线（raw < 400），`2` 读数饱和（raw > 4000）——这两种通道会被跳过，不影响其它通道
- 写入前还会校验方向：干点必须比现有湿点高 150 以上，湿点必须比现有干点低 150 以上，否则该路跳过
- 有泵在运行时返回 `{"ok":0,"err":"busy"}`；泵刚停的 300ms 地弹窗口内会自动等待
- 成功写入后**立即落盘**（不等 2 秒去抖），并重新计算所有百分比

## GET /api/schedule

```json
{ "ok":1, "tasks":[ { "i":0, "on":1, "ch":2, "type":0,
                      "periodMin":360, "durSec":45, "hour":0, "min":0 } ] }
```

`type`：0 = 周期型（不依赖网络时间），1 = 每日时刻型（需时间已同步）。

## POST /api/schedule

新增或修改。带 `i` 表示改第 i 个槽位，不带则新建。返回分配的槽位号。

```json
{ "ch": 2, "type": "interval", "periodMin": 360, "durSec": 45, "on": 1 }
{ "i": 0, "on": 0 }
{ "ch": 1, "type": "daily", "hour": 8, "min": 0, "durSec": 30 }
```

## POST /api/schedule/del

```json
{ "i": 0 }
```

## GET /api/logs?since=N

增量拉取，`since` 传上次拿到的最大 `s`。固件日志只放 RAM（128 条环形），不写 flash。

```json
{ "ok":1, "wall":1762512345, "boot":1762503924, "seq":42,
  "items":[ { "s":41, "t":8421, "w":1762512345, "d":15,
              "c":"浇水完成", "k":"ok", "ch":2 } ] }
```

- `wall` 当前 UTC epoch 秒，`boot` 开机时刻 UTC epoch 秒；NTP 未同步时为 `0`。
- `t` 是设备 uptime 秒，`w = boot + t` 就是该条日志的绝对时间，前端统一 `+8` 小时显示北京时间。
- `d` 是浇水秒数：开始浇水记设定时长，停止/完成记实际运行秒数，其余日志为 `0`。用来核对「设置 15 秒是否真按 15 秒浇」。
- `k`：`ok` / `warn` / `err` / 空。

## GET /api/scan

扫描附近 WiFi，**阻塞 2~3 秒**，前端要显示 loading。返回最多 12 个。

```json
{ "ok":1, "nets":[ { "ssid":"Home-2.4G", "rssi":-52 } ] }
```

## POST /api/wifi

保存路由器账号，2 秒后自动重启。空密码留空字符串。

```json
{ "ssid": "Home-2.4G", "pass": "12345678" }
```

## GET /api/version

```json
{ "ok":1, "fw":"1.1.3", "build":"Nov  8 2026 00:30:00", "ap":"AutoWater-3F2A" }
```

## POST /api/reboot

800ms 后重启。

## MQTT 上报帧（`state` 主题）

固件 1.1.1 起分三类帧，用 `k` 区分，都发到同一个 `state` 主题（巴法云下为 `<前缀>state`）：

| k | 内容 | 触发 |
|---|---|---|
| `s` | 状态：六路读数 + 通道配置 + `up/wall/boot/tz` + `active` | 每 30 秒、或任何配置/浇水命令后 |
| `t` | `tasks[]` 定时任务 | `get` / `task` 命令 |
| `l` | `items[]` 最近 12 条日志 | `get` / 浇水开始与停止 / 标定 |
| `e` | `{err, ch, act}` 指令被拒绝的原因 | 令牌错误 / 通道号非法 / 调度拒绝 |

- `wall` 当前 UTC epoch 秒、`boot` 开机时刻 UTC epoch 秒、`tz=28800`，含义与 `/api/logs` 相同。
- 日志项额外带 `w`（绝对 UTC epoch）与 `d`（浇水秒数）。
- NTP 未同步时 `wall=boot=w=0`，远程页回落到「收到状态帧的时刻 − up」反推，不会显示错时间。
- 设备端 `start` 命令读 `s` 字段作为本次时长，缺省才回落该通道 `maxSec`，上限 `HARD_MAX_SEC=300`。
- **`k=e` 是 1.1.2 新增的失败应答**：此前令牌不对或探头断线时设备直接丢弃指令、不回任何帧，页面表现为「点了没反应」。现在 `err` 取 `token` / `bad_ch` / `sensor_fault` / `budget` / `busy` / `cooldown` / `lockout` / `invalid`，远程页会弹中文提示。故障通道的浇水按钮同时置灰。

### 连接保活与自动重连（1.1.3）

远程页显示「等待设备上报中」的唯一条件是 **60 秒内没收到真实 `k=s` 帧**。1.1.3 之前最典型的故障是：

1. 设备开机连上 broker，`s_conn=true`；
2. 几小时后 WiFi 抖动 / broker 主动断链 / NAT 老化，`PubSubClient` 内部已判定连接丢失；
3. 固件从不回读 `s_mqtt.connected()`，于是永远不重连 → `publish` 静默失败、命令收不到；
4. `/api/state` 仍报 `mqtt=1`，手机端只能一直等首帧。

修复点：

- `mqttTick()` 每拍 `loop()` 后检查 `loop()` 返回值和 `s_mqtt.connected()`，一旦掉线立即清状态、停掉半开 socket、写一条 `LOG_MQTT`，1.5 秒后重连。
- `publishJson()` 检查 `publish()` 返回值，连续 2 次失败也判定掉线（可覆盖缓冲不足以外的底层断链）。
- `setKeepAlive(15)`：半开连接最多约 30 秒由 PINGREQ 超时判死。
- 重连成功会立刻 `publishState()`，不用等下一个 30 秒周期。
- 远程页连上 broker 后不再干等周期帧，按 `0 / 2 / 5 / 10 / 20 秒` 主动重发 `get`，收到首帧 `k=s` 即停；等待提示会显示已重试次数，第 4 次仍未响应改提示「设备未响应 · 检查设备网络」。

排查顺序：`GET /api/state` 看 `mqtt` → `GET /api/logs?since=N` 看有没有连续的 `MQTT 连接状态变化` → 用 WSS 订阅 `<前缀>state` 发一次 `get w:state`，在线设备会在 1 秒内回 `k=s`。

## 设计取舍

- **用轮询不用 SSE**：ESP32 的 lwIP 只允许 10 个 socket，常驻连接会耗尽；且 Arduino `WebServer` 是单客户端同步处理，SSE 会长期占住处理器导致其他请求全部超时。2 秒轮询每次约 700 字节，压力可以忽略。
- **JSON 全部 `snprintf` 到栈缓冲**，不用 `String` 拼接：堆碎片是 ESP32 长时间运行崩溃的头号原因。
- **不引任何 CDN**：热点模式下没有外网，页面里一旦有外部资源引用就会白屏。
