huangzhu0423/esp32-waterer/docs/WIRING.md

# 接线表

确认的板型：**ESP32-WROOM-32 DevKit，30 针，USB-C，丝印为 `D` 前缀写法**（`D13`/`D2`/`VN`/`VP` 这种）。

> **2026-11-12 实物照片核对**：板上找不到清晰的 `VIN` 丝印属正常，30 针板有的印 `VIN` / `5V`、有的不引出排针。**`VN` / `VP` 不是电源脚**，是 GPIO39 / GPIO36，即 CH2 / CH1 的探头 AOUT 输入（见第一节），5V 灌进去会打穿 ADC。5V 输入优先走 **USB-C 口**，别照丝印猜排针，详见第三节。
确认的传感器：**Capacitive Soil Moisture V2.0.0（丝印另有 HW-390）**，自带 3 针 JST 白插头 + 杜邦线。
6 路传感器 + 6 个 5V USB 小泵 + 6 个逻辑电平 MOSFET，每路接线完全一样，只是引脚号不同。

## 零、先说传感器

- **供电必须是 3V3，不能接 5V。** 这个模块的输出电压跟着供电走，接 5V 时输出会超过 ESP32 ADC 的 3.3V 上限，轻则读数永远顶到 4095，重则损伤引脚。
- 它标称 3.3~5.5V 可用，但配 ESP32 就只能用 3.3V 那一档。单路 5~20mA（不同批次差别很大，建议上电实测），6 路合计 30~120mA，板载 AMS1117 仍带得动。
- **不要相信线的颜色。** 白插头出来的三根线红/黑/黄是常见排法，但不同批次会变。看板上丝印：靠近插座那三个焊盘分别标着 `VCC` / `GND` / `AOUT`，按丝印接，别按颜色接。
- 出厂默认干湿点是 2800 / 1150（这个型号的典型区间），实际每片探头差别不小，装好一定要做一次校准。

## 一、引脚对照

| 通道 | 传感器 AOUT | 板上丝印 | 泵 MOS 栅极 | 板上丝印 | 说明 |
|---|---|---|---|---|---|
| CH1 | GPIO36 | **VP** | GPIO13 | **D13** | 传感器脚 input-only |
| CH2 | GPIO39 | **VN** | GPIO18 | **D18** | 同上 |
| CH3 | GPIO34 | **D34** | GPIO19 | **D19** | 同上 |
| CH4 | GPIO35 | **D35** | GPIO23 | **D23** | 同上 |
| CH5 | GPIO32 | **D32** | GPIO25 | **D25** | |
| CH6 | GPIO33 | **D33** | GPIO26 | **D26** | |

传感器全在**右侧排针下段**（D33 往上到 VP），泵全在**两侧中上段**，走线正好分开不打架。

避开的引脚及原因：

| 引脚 | 为什么不能用 |
|---|---|
| D2 / D12 / D15 / EN | strapping 引脚，上电电平决定启动模式 |
| D4 / D5 / D14 | 上电瞬间有 PWM 输出，泵会抖一下 |
| RX0 / TX0（GPIO1/3） | 串口，占了就看不了调试输出 |
| 3V3 / GND /（VIN 若有） | 电源脚；**`VN` / `VP` 不是电源脚**，是 CH2 / CH1 的 ADC 输入，5V 灌入即损坏 |
| GPIO6~11 | SPI Flash，根本不引出 |

## 二、每路接线（6 路重复 6 次）

| 从 | 到 | 元件 | 备注 |
|---|---|---|---|
| 传感器 VCC（红） | **3V3** | 导线 | **绝对不要接 5V**，电容式探头 3.3V 供电即可 |
| 传感器 GND（黑） | **GND** | 导线 | |
| 传感器 AOUT（黄） | 对应的 ADC 脚 | 导线 | 见上表 |
| AOUT | GND | **100kΩ 电阻** | 泄放电阻，**必须有**。input-only 脚没有内部下拉，探头一拔读数会乱飘；加了它才能让"断线"稳定表现为读数≈0 |
| 泵 +（红） | 5V 电源正 | 导线 | **不要从板子的 VIN 取电**，见第三节 |
| 泵 −（黑） | MOSFET Drain（漏极） | 导线 | |
| MOSFET Source（源极） | GND | 导线 | **必须与 ESP32 共地** |
| MOSFET Gate（栅极） | 对应的泵脚 | **串 100Ω** | 限流，防止栅极振荡 |
| Gate | GND | **10kΩ 电阻** | 下拉，**这是"上电不浇水"的真正保障**（见下） |
| 泵 + ↔ 泵 − | 反向并联 | **1N4007**（阴极接 +5V） | 续流二极管，吸收泵关断时的反向尖峰，否则迟早打穿 MOS |

## 三、供电总图

> **当前实机分工**：水泵走低边 N-MOS（第二节），**唯一的继电器是探头间歇供电**（第八节）。「6 路泵也改用继电器」是第七节的备选方案，本节电流账按 MOS 方案算。

这台机器有四类负载、两档电压，必须分开供。

| 负载 | 电压 | 单个电流 | 同时最多 | 由谁供 |
|---|---|---|---|---|
| 6 个水泵 | 5V | 0.5~0.8A（启动峰值 1.5A） | 1 路（固件互斥） | 5V 适配器直供，经 MOS 低边开关 |
| 6 个 MOS 栅极 | 3.3V | <1mA（静态） | 6 路 | ESP32 GPIO |
| 探头供电继电器线圈 | 3.3V | 73mA | 间歇 | ESP32 3V3 |
| 6 路探头 | 3.3V | 合计 30~120mA | 间歇 | 经探头继电器 NO |
| ESP32 | 5V→3V3 | 150~250mA | 常开 | 5V 适配器经 **USB-C 口**（部署；或实测确认的 VIN 排针）/ 电脑 USB（调试） |

### 直接接 ESP32 的 3V3 行不行

**可以。** 把账算清楚就明白余量在哪：

| 项目 | 3.3V 侧电流 |
|---|---|
| ESP32 自身（WiFi 发射峰值） | 150~250mA |
| 探头供电继电器线圈（采样窗口才吸合） | 73mA |
| 6 路探头（采样窗口才耗电） | 30~120mA |
| 6 个 MOS 栅极 | 可忽略 |
| **稳态合计** | **约 353~443mA** |

USB 口限的是 **5V 侧 500mA**，经 AMS1117 转成 3.3V 后约 **640mA**（效率 85%）。稳态 353~443mA 还剩 200~290mA 余量，MOS 方案比继电器方案宽松得多。

**唯一的危险点是探头继电器吸合瞬间**：线圈浪涌会在几百毫秒内把 3V3 拉出一个坑，电压一跌就是「复位→再复位」。靠两件事排除：

1. **3V3 与 GND 之间加 470~1000µF 电解电容**：吸收吸合浪涌，把瞬态坑填平
2. **确认模块 IN 端有下拉**：断电状态量 **IN 对 DC−**，约 10k 说明有；无穷大就补一个 10k 到 DC−，避免上电高阻窗口乱吸合

做好这两条，直连完全能用。真出症状了（上电时继电器连续「咔哒」、串口刷 `rst:0x1`）再补一个降压模块——那时它是解决方案，不是必需品。

> 如果你更想一步到位、彻底不操心，也可以上 5V→3.3V 降压模块（MP1584 / LM2596，3A 版）把继电器和探头都挪过去。十块左右，代价是多一个模块和几根线。

### 接线

```
5V / 5A 适配器
  ├─ USB-C 口（或 VIN）──── ESP32（部署时；调试可改用电脑 USB 供电）
  ├─ 5V 主干 AWG18 ─────── 汇流排 → 6 个泵 +（各并 1N4007）
  └─ GND ─┬─ ESP32 GND
          ├─ 6 个 MOS Source
          ├─ 探头继电器 DC−
          └─ 6 路探头 GND

ESP32 3V3
  ├─ 探头继电器 DC+（线圈）
  ├─ 探头继电器 COM ── NO ── 6 路探头 VCC（并联）
  └─ 470~1000µF 电解 → GND（关键，见下）

ESP32 GPIO（16 根，见第十节的分配板做法）
  ├─ D27 ─────────────── 探头继电器 IN
  ├─ VP / VN / D34 / D35 / D32 / D33 ── 6 路探头 AOUT（各并 100k 到 GND）
  └─ D13 / D18 / D19 / D23 / D25 / D26 ── 100Ω ── 6 个 MOS Gate（各并 10k 到 GND）

6 个泵 − ── 各自 MOS Drain
```

> **所有 GND 必须连在一起。** 少接一处，继电器 IN 就没有参考电平，表现为乱吸合、时好时坏——这类故障最难查。

**适配器用 5V/5A**：水泵启动电流是额定的 2~3 倍，单泵峰值可达 1.5A；ESP32 约 0.25A。正常工况合计不到 2A，5A 余量充足，即使某路泵卡转也不会把电压拖下来。

> **2026-11-12 到货实泵校准**：商品页标 **DC3~5V / 100~200mA**，比本节按常规 5V 泵估的 0.5~0.8A 小得多。**5V/5A 适配器与 AWG18 主干都大幅富余，不用换**；本节电流账是保守上限，照它选型只会更安全。详见第十二节第 6 步「到货实泵」。

### 5A 怎么分配，比买多大更要紧

| 事项 | 要求 | 原因 |
|---|---|---|
| 输出线径 | **AWG18（0.82mm²）以上** | 杜邦线每根只能过 0.5~1A，5A 会发烫甚至熔皮 |
| 分配方式 | **端子台 / 直接焊接** | 面包板单孔约 1A，绝对不能用来分配 5V 主电 |
| 走线 | 泵的正极线单独从适配器拉，不要和探头线捆一起 | 泵启停的电流突变会耦合成干扰，影响 ADC |

> 电源给到 5A，**不代表可以放开多路同时浇水**。固件保持互斥是有意的：6 个泵同时启动峰值接近 9A，这个余量是留给"某一路卡转"的，不是留给并发浇水的。

### 一个 5V/5A 怎么同时带 ESP32 和泵（部署接法）

> **2026-11-12 实物照片核对：板上找不到清晰的 `VIN` 丝印，别硬找，也别照丝印猜。**
> 30 针板靠近 USB-C 的那一端第一个孔按标准排列是 5V 输入网络，竖排 `VIN` 常被印成 / 拍成看起来像 **`VN`** 的样子；而真正的 `VN` / `VP` 是 **GPIO39 / GPIO36 = CH2 / CH1 的探头 AOUT 输入脚**（见第一节引脚表），在这块板上位于排针下段、被金属屏蔽罩挡住。**这两个脚只能吃 0~3.3V，灌 5V 直接打穿 ADC，还会正好毁掉前两路探头。** 国产 30 针板有的把 5V 输入印 `VIN` / `5V`，有的干脆不引出排针、只能走 USB-C 口。
>
> **首选：不碰排针，直接给 USB-C 口供电。** 从分线点引一路细线（红 → VBUS/5V、黑 → GND）接一根 **「USB-C 公头 → 2P 螺丝端子 / 裸线」取电线**（搜 "USB-C 公头 电源线 2P 端子"，几块钱；或剪一根废弃 USB-C 数据线只留红黑，白绿数据线包好不接）。板载肖特基防倒灌 + AMS1117 走正确路径，不会接错 `3V3` / `VN` / `VP`。
>
> **坚持用排针就先量，别按丝印猜**：只插 USB 供电上电，万用表直流档黑笔接 `GND`、红笔逐个量右侧顶部几个孔 —— **≈4.6~5V 的才是 5V 输入**；≈3.3V 的是 `3V3`；`VN` / `VP` 悬空时约 0V。或断电用通断档量该孔 ↔ USB-C 母座 VBUS 焊盘是否直通（隔了 LDO 的 `3V3` 不会直通）。**只有量到 5V 的孔才能接 5V 正极。**
>
> 下文所有 `VIN` 一律指 **ESP32 的 5V 输入网络**：经 USB-C 口与经 `VIN` 排针电气等价；「别同时插 USB 和 VIN」只在使用排针方案时需要遵守。

调试期是「ESP32 插电脑 USB + 适配器只带泵」两个独立电源；**部署时合并成一个适配器**，在**电源输出端星形分两路**，不要串着供：

```
5V/5A 适配器 → DC099 母座尾线 / 2P 端子（分线点）
  ├─ 路 1：AWG18 粗线 ──→ 两块 YYNMOS-4 `DC+ / DC-`（泵电源）
  └─ 路 2：AWG22~26 细线 ─→ USB-C 取电线 → ESP32 USB-C 口
                              （或实测确认的 VIN 排针 + GND）
```

**怎么分（按手头料选一档）**：

| 做法 | 物料 | 说明 |
|---|---|---|
| 推荐 | 「2P 进 / 2 组 2P 出」螺丝分线板，或 SPL/PCT 杠杆分线器（一进二出） | 免焊、可插拔；红黑各分两路 |
| 零成本 | DC099 尾线中段剥开一小截，**T 型焊出第二对细线**，热缩管包严 | 最省，但不可插拔，焊点别碰金属螺纹外壳 |
| 最省事（推荐） | **USB-C 公头 → 2P 端子 / 裸线取电线** | 细线红接 VBUS、黑接 GND，插 ESP32 的 USB-C 口；**不用找 `VIN`、不会碰到 `VN`/`VP`**，见上方实物核对 |

- **分线点必须在适配器这一端**。从 MOS 板的 `DC+` 端子再并一根给 ESP32 是错的：泵电流会在那段共用线上产生压降和开关噪声，直接灌进 ESP32。
- **两路 GND 各自独立回到分线点**（星形），别让泵回流走 ESP32 的细地线。
- 细线压进端子时**对折或套 E0508 管形端子**，别让 AWG18 粗线把它挤松。
- 第二节逐针表里「泵 + 不要从板子的 VIN 取电」说的就是这件事：板子的 5V 输入（VIN 排针 / USB-C 口 VBUS）走的是板载细走线 / 防倒灌二极管，**扛不住泵电流**，泵必须直接从分线点取电。

**ESP32 这头只认三件事**：

1. **首选把 5V 送到 USB-C 口**（用上面的取电线），不碰任何排针。若已用万用表量到 `VIN` / `5V` 排针，也可 5V → `VIN`、GND → 任意 `GND`。**绝对不要把 5V 接到 `3V3`、`VN`、`VP`**：`3V3` 一接烧 ESP32 和 6 只 HW-390，`VN`/`VP` 是 CH2/CH1 的 ADC 脚、灌 5V 直接打穿。压线前用万用表确认脚位，别照丝印猜。
2. 板载 AMS1117 从 5V 降到 3.3V：ESP32 自身 150~250mA + 间歇的探头/继电器，稳态约 0.3~0.5W，**摸着温热正常**；烫手就贴小散热片或换 5V→3.3V DC-DC（本节「直接接 ESP32 的 3V3 行不行」末尾那个备选）。探头每 30 分钟只通电约 1 秒，平均负担很小，这是能单电源的前提。
3. **烧录 / 看串口时别同时接两个 5V 源**：用 USB-C 取电线供电时，烧录就把取电线拔掉、换电脑 USB 数据线（同一个口，天然不会顶在一起）；若用 `VIN` 排针方案，则要防两个 5V 顶在一起倒灌电脑 USB 口 —— 要么先拔 VIN 只用 USB，要么在 VIN 输入串一只 1N5819（压降约 0.3V，仍在 VIN 允许范围）。

**共地的判据要跟着改（最容易误判）**：第三节总图里 ESP32 GND 与适配器负极本就是同一个点，所以

> 第十二节第 3 步第 3 量「`电源− ↔ ESP32 GND` 应不导通」**只在双电源调试（电脑 USB + 独立适配器）时成立**。改成单电源后这两点**必然导通、属正常**，别当成短路或接错去拆线。

代价是失去模块光耦的地隔离：泵碳刷火花和电流突变更容易沿共用的 5V/GND 串进 6 路高阻 ADC。所以单电源时，除下表 3V3 侧那两个电容外，**5V 侧还要**落实：5V 入口（USB-C 取电线或 VIN 排针）并 100µF、`DC±` 入口并 47µF + 每只泵端子就近并 100nF（第十二节第 6 步），泵线与探头干线分开 ≥20cm。好处是 PWM 信号回流路径一定存在，**非光耦隔离的便宜 MOS 板也不会出现「点了浇水泵不转」**。

**上电验收**：断电量 5V 输入 `↔ GND` 不短路、5V 输入 `↔ 3V3` 不导通；上电量 USB-C 口 VBUS ≈ 5V（或 `VIN` 孔 ≈5V）、`3V3 ≈ 3.3V`；再按第十二节第 4 步读 `/api/state`（`fw=1.1.3` / `mqtt=1`）、第 6 步点「浇 15s」看出水，并留意浇水瞬间 CH1 `raw` 有没有被碳刷火花带跳。

### 打板之后要不要改走排针（2026-11-12 决策）

**结论：先走 USB-C 口，而且这不是临时方案，可以一直用下去。「等打板再走排针」这个前提不成立。**

要打的那块板是 `docs/PCB.md` 第十一节的 **远端无源分线板**，装在花盆区中心：进线 RJ45 水晶头、出线 6 个 3P 直插座，纯无源、无有源元件。它上面只有 `VCC_S`（3.3V / 30~120mA）、`GND` 和 6 路高阻 `AOUT` 三类网络，**没有 5V、没有泵电源、没有 ESP32 排针**，位置也离主控箱几米远。它替代的只是「盒内 8P 端子 + 2 条汇流排 + 18 根跳线」，跟 ESP32 怎么取电毫无关系。

| 打板会不会变 | 项目 |
|---|---|
| **变**（都在探头侧） | 干线改 RJ45 水晶头对接（5.8）；探头 3P 插头直插免接线（5.9）；**100kΩ 从探头插头根部挪到板上 6 个 0805 焊位**，两处只装一处 |
| **不变**（供电侧） | 5V/5A 星形分两路、`DC±` 去两块 MOS 板、USB-C 取电线去 ESP32、共地判据、5V 侧去耦、泵线离探头干线 ≥20cm |

所以现在按上面的接法一次做完即可，**手工接线阶段别为「以后改排针」预留线、改分线点或加 5V 端子**；第十一节远端板 BOM 里也不加任何供电件。真要做预留，也只体现在**以后画主控底板时留 NC 焊位**（`docs/PCB.md` 12.3），不影响现在这根线。

**唯一会改走排针的情形：另做一块主控载板** —— 用户 2026-11-12 已表示**以后想打**，规划见 `docs/PCB.md` **第十二节**（前十节是配件到货前的分立 MOS 设计，别照着直接打）。真到那天仍要按三条办：

1. **先实测**：只插 USB 上电，万用表量出 5V 输入网络究竟有没有引出排针、是哪个孔（第三节实物核对）；丝印 `VN` 是 ADC 脚，**灌 5V 会打穿 CH1/CH2**。本板若根本没引出，底板也变不出这个孔，只能继续走 USB-C。
2. **底板上留二选一焊位**：`J_USBC` 默认装、`J_5V` + `JP_5V` 0Ω 默认 NC，只有实测后才贴跳线；两入口不同时供电，必要时排针支路串 1N5819 防倒灌；烧录时先拔底板 5V 或换 USB 数据线。逐脚定义见 `docs/PCB.md` **12.3**。
3. **电气等价，不是升级**：USB-C 口与 5V 排针进的是同一个网络、同样过板载肖特基与 AMS1117；排针唯一好处是省一根线、方便插底板，代价是失去「同一口天然不会双电源顶住」的便利，还多一个接错 `3V3`/`VN`/`VP` 的风险点。

> 一句话：**先打的远端板改的是探头侧的线；以后打主控载板也只是整理主控箱线束，5V 默认仍走 USB-C 口。** 固件 1.1.3 与供电接法都不因此改动、不用重烧。

### 必装的两个电容

| 位置 | 元件 | 作用 |
|---|---|---|
| **ESP32 3V3 ↔ GND** | **470~1000µF 电解 + 0.1µF 瓷片** | 直连方案里这是最关键的一个元件：吸收探头继电器线圈吸合的浪涌，同时兼顾 WiFi 发射的 200mA 级突变。没有它，上电窗口和吸合瞬间都容易把 3V3 拉出坑 |
| 探头继电器模块 DC+ ↔ DC− | 100µF（可选） | 就近缓冲。模块离 ESP32 超过 20cm 时建议补上，短线本身电感就会放大瞬态压降 |

## 四、关于"上电时泵会不会误开"

从 ESP32 复位到 `setup()` 跑起来之间有 **200~300ms** 的 bootloader 窗口，这段时间软件完全管不到。唯一能兜住它的是 **栅极上的 10kΩ 下拉电阻**——它保证 MOS 在没有任何驱动时保持关断。

所以：
- 10k 下拉不是"可选优化"，漏了就会出现"一插电泵就抽一下"。
- 固件里 `pumpBegin()` 在 `setup()` 第一行执行，但那已经是 300ms 之后的事了。

## 五、第一次上电前自检

1. 万用表量每路 Gate 对 GND，应为 0V（不接 ESP32 时）。
2. 量 5V 与 GND 之间不能短路。
3. 先只接 ESP32 + 传感器，不接泵，上电看网页能不能读到 6 路湿度。
4. 确认读数正常后，再接一路泵测试开合。**不要一上来就接满 6 路。**

## 六、常见故障对照

| 现象 | 大概原因 |
|---|---|
| 上电后反复重启、串口刷 `rst:0x1 (POWERON_RESET)` | 继电器线圈浪涌把 3V3 拉塌了。先按第三节补足 470~1000µF 电容；仍复发说明模块 IN 没有下拉，给每个 IN 补 10k 到 DC−，或者改用降压模块 |
| 六路同时显示「探头无供电」 | 探头供电继电器没吸合 / 线圈断 / 3V3 没供上。**不是六个探头一起坏了**，先量继电器 NO 端有没有 3.3V |
| 网页显示某路 raw < 400 且标记故障 | 探头没插好 / AOUT 线断 / 忘了接 VCC / 悬空引脚漂到百位级 |
| 某路湿度一直 0%，但探头插在湿土里 | 干湿点没校准，去网页点"以当前值为湿点" |
| 浇水时其他通道读数乱跳 | 没共地，或 3V3 缺 100µF 电容 |
| 一插电泵就转一下 | 栅极缺 10kΩ 下拉 |
| 网页连不上 | 先连热点 `AutoWater-XXXX`（密码为空），再看设置页 |
| 反复重启 | 5V 带不动，或 3.3V 被继电器线圈浪涌拉塌。电源见第三节，别用电脑 USB 口 |

## 七、改用继电器模块（TONGLING JQC-3FF-S-Z）

如果没有 MOS 管、手上是这种红色继电器模块，也能用，接线如下。**每路一个模块。**

### 线圈电压先确认

继电器本体侧面印着线圈电压（`03VDC` / `05VDC` / `12VDC`），**模块的 VCC 必须等于这个值**：

- 5V 线圈接 3.3V → 吸不动，触点半接触，会打火发热
- 3V 线圈接 5V → 线圈过流发热，几小时就烫手

### 输入端（3 针排针，丝印 VCC / GND / IN）

| 端子 | 接到 | 说明 |
|---|---|---|
| **DC+** | **ESP32 3V3**（本机这 6 个都是 3.3VDC 线圈） | 接 5V 会烧线圈。6 路并联前先看第三节的电流账与电容要求 |
| **DC−** | GND | **必须与 ESP32 共地**，否则 IN 没有参考电平 |
| **IN** | 对应泵脚（D13/D18/D19/D23/D25/D26） | 3.3V 逻辑直接驱动光耦 |

### 输出端（3 位蓝色端子 NO / COM / NC）

| 端子 | 接到 | 说明 |
|---|---|---|
| COM | 5V 电源正 | 触点公共端 |
| **NO** | 水泵 +（红线） | 常开，**只能用这个**：不吸合时断电，泵不转 |
| NC | 空着 | 常闭，断电时反而导通，用它会一直浇水 |

水泵 −（黑线）直接回 5V 电源负极，不经过继电器。

> 继电器只切**一根线**（水泵正极），不要同时切正负极。

### 黄色跳线：必须选高电平触发

板上标 `High/Low Level Trigger` 的黄色跳线决定 IN 的极性。**固件默认高电平开泵**，所以：

- 跳线设成 **H（高电平触发）**
- 如果你的模块只有低电平触发、或跳线帽掉了：把 `config.h` 里 `PUMP_ACTIVE_LOW` 改成 `1` 重新烧录。**不改一定会出事**——固件把引脚拉低当作"关"，模块却认为"开"，上电后泵一直转。

### 3.3V 能不能驱动 5V 模块

绝大多数带光耦的 JQC-3FF 模块，3.3V 高电平就能可靠触发（光耦只吃 3~5mA）。但个别批次的限流电阻偏大，3.3V 电流不够。**通电前先空载测**：

1. 只接 VCC/GND，IN 悬空 → 继电器应不吸合
2. IN 接 3V3 → 应听到"咔哒"一声吸合
3. IN 接 GND → 应释放

只要第 2 步不吸合或吸合发抖，就是电平/电流不够，换 MOS 管方案。

### 和 MOS 管方案的差别

| | 继电器 | 低边 MOS |
|---|---|---|
| 静音 | 有"咔哒"声 | 完全无声 |
| 寿命 | 机械触点，约 10 万次 | 无限次 |
| 上电误动作 | 靠模块自身上拉 + 跳线 | 靠 10k 栅极下拉 |
| 触点打火 | 泵停机瞬间有轻微火花 | 无 |
| 体积 | 大 | 小 |

每天开合几次的话，10 万次够用好几年，继电器完全能胜任。水泵两端仍建议并一只 1N4007（阴极接 +5V），能明显减少触点火花。

## 八、探头供电继电器（间歇采样）

固件默认**每 30 分钟给探头供电一次，采完立刻断电**，其余时间传感器完全断电。

这一路是可选的：不接的话固件照样工作（探头一直带电，只是不省电、不延寿），所以可以先烧固件验证逻辑，硬件后补。

### 为什么值得加

电容式探头长期通电会让极板电化学极化，一两年就漂。六路合计 30~120mA，断电后平均不到 0.1mA。省电是次要的，**主要是延寿**。

### 接线（占用模块的一个空闲通道）

输出端：

| 端子 | 接到 | 说明 |
|---|---|---|
| COM | **3V3** | 触点公共端。线圈仍是 5V，但触点和线圈完全隔离，互不影响 |
| **NO** | 传感器 VCC 母线 | 六路探头的 VCC（红线）并在一起接这里 |
| NC | 空着 | 常闭，不吸合时反而供电，接错等于白做 |

输入端：**VCC 接 3V3**、GND 共地，**IN 接 GPIO27（D27）**。

> 这块 JQC-3FF-S-Z 外壳印着 `3.3VDC`，是 **3.3V 线圈版**，VCC 必须接 3V3，接 5V 会把线圈烧了。买模块前先看这个数字：`05VDC` 的才接 5V。
>
> 3.3V 线圈单只吸合约 73mA。吸合瞬间的浪涌容易把 3V3 拉低、导致 ESP32 复位，建议在模块 VCC 与 GND 之间并一只 **100~470μF** 电解电容缓冲。

黄色跳线同样设 **H（高电平触发）**，对应 `config.h` 里 `SENSOR_PWR_ACTIVE_LOW = 0`。

> 若模块只有低电平触发，把 `SENSOR_PWR_ACTIVE_LOW` 改成 `1` 重新烧录。**不改会正好反过来**——固件以为拉高是通电，实际拉高是断电，于是"采样时断电、待机时通电"，六路读数全是 0，全部判断线，水泵全锁。

### 只断 VCC，不动 GND

探头的 GND 和 AOUT 始终接着，只切 VCC。**绝对不要改成断 GND**——那样探头 AOUT 会经内部电路继续带电压，电流从 ESP32 的 ADC 保护二极管倒灌进芯片。

### 触点会氧化

几十毫安属于"干电流"，银触点不产生电弧自清洁，长期可能氧化、接触电阻变大，表现是六路读数同时偏高。怀疑时量触点两端压降，超过 0.5V 就该换模块。想彻底免除这项维护就换 P-MOS 高边开关（见 `config.h` 里方案 B）。

### 扩到 20 路以上要分组

一个继电器带 8~10 路没问题，带满 32 路就有隐患：每路探头内部有 10~47μF 滤波电容，32 路并起来是 300~1500μF。继电器吸合瞬间从 0 充到 3.3V，冲击电流可达几十安（微秒级），反复几次触点就会粘连——而粘连是渐进的，起初只是读数间歇性乱跳，极难归因。

**按 8 路一组分开供**：

| 组 | 探头通道 | 继电器 IN | VCC 母线 |
|---|---|---|---|
| 1 | 1~8 | GPIO27 | 母线 A |
| 2 | 9~16 | GPIO16 | 母线 B |
| 3 | 17~24 | GPIO17 | 母线 C |
| 4 | 25~32 | GPIO21 | 母线 D |

每组一个继电器 + 一条独立的 VCC 母线。三个好处：冲击电流降到 1/4；某组继电器坏了只影响 8 路；供电线跟着探头分布走，走线短、压降小。

> 当前固件只有一路供电控制（`PIN_SENSOR_PWR` = GPIO27），对应第 1 组。扩到多组时要把这个宏改成数组，并在 `sensors.cpp` 的 `sensorPowerOn()` / `sensorPowerOff()` 里按组分别操作。这一步最好和 MUX、`CHANNEL_COUNT` 一起改，只折腾一次。

如果实在想用一组带满 32 路，至少在 NO 与 VCC 母线之间串一只 **NTC 热敏电阻**（MF72-5D11，冷态 5Ω / 热态 0.2Ω）限制充电电流。代价是正常工作时约有 0.03V 压降，对探头可以接受。

### 怎么验证

1. 万用表接传感器 VCC 母线，平时应为 **0V**
2. 网页「设备」里看「下次采集」倒计时，到点时 VCC 跳到 **3.3V**，约 1 秒后回到 0V
3. 断电期间量任意一路 AOUT：应接近 0V（100k 下拉保证）。若还有 1V 以上虚电压，说明断的是 GND 不是 VCC，或者继电器接错端子

## 九、最小验证：1 个探头 + 1 个探头供电继电器 + 1 路 MOS 泵

**当前实机的分工**：唯一的继电器是**探头间歇供电**（GPIO27），**不是**泵继电器；水泵走低边 N-MOS（D13）。第一次上电不要一次接满 6 路，只验证通道 1（CH1），其余 5 路空着显示「故障 / 断线」是正常的。

### 探头侧：继电器只切 VCC

| 元件 | 端子 | 接到 | 备注 |
|---|---|---|---|
| 供电继电器（3.3V 线圈） | DC+ | ESP32 **3V3** | 先看外壳印字：`03VDC` 接 3V3，`05VDC` 接 5V |
| | DC− | ESP32 **GND** | 必须共地 |
| | IN | **D27 / GPIO27** | `PIN_SENSOR_PWR` |
| | 跳线 | **H（高电平触发）** | `SENSOR_PWR_ACTIVE_LOW = 0`，拉高才通电 |
| | **COM** | ESP32 **3V3** | 触点公共端 |
| | **NO** | 探头 **VCC** | NC 空着 |
| 探头 HW-390 | VCC | 继电器 **NO** | 不直接接 3V3 |
| | GND | ESP32 **GND** | **始终直连，不经过继电器** |
| | AOUT | **VP / GPIO36** | 通道 1 的 ADC 脚 |
| | AOUT ↔ GND | **100kΩ 电阻** | 必须有；断电时把 AOUT 拉到 0，断线才能稳定判成 raw≈0 |

> **只断 VCC，绝对不要改成断 GND**：探头断电后 AOUT 会经内部电路继续带电，电流从 ADC 引脚的 ESD 保护二极管倒灌进芯片。
>
> 跳线拨错成低电平触发会正好反过来：采样时断电、待机时通电，六路读数全 0 判断线，水泵全锁。

### 水泵侧：低边 N-MOS

| 从 | 到 | 元件 | 备注 |
|---|---|---|---|
| 泵 +（红） | 5V 电源正 | 导线 | **不要从板子 VIN 取电** |
| 泵 −（黑） | MOS **Drain** | 导线 | |
| MOS **Source** | GND | 导线 | 与 ESP32 共地 |
| MOS **Gate** | **D13 / GPIO13** | **串 100Ω** | 通道 1 泵脚 |
| Gate | GND | **10kΩ 下拉** | 上电不误开的关键 |
| 泵 + ↔ 泵 − | 反向并联 | **1N4007** | 阴极接 +5V，吸收关断尖峰 |

`PUMP_ACTIVE_LOW = 0`（高电平开泵）与 N-MOS 栅极高电平导通一致，**不用改固件**。

### 上电自检

1. 万用表量探头 VCC：待机 0V，采样窗口（约 1 秒）跳到 3.3V 再回落；一直 0V 说明跳线极性或 IN 脚接错。
2. 网页预期：只有 CH1 显示湿度（干土约 2600~2900，湿土约 1000~1300），CH2~CH6 全为故障。
3. 点「浇 15s」：D13 变高、MOS 导通、泵转 15 秒。可先空载，用万用表量 Gate 是否为 3.3V。
4. CH1 若仍是故障：量采样窗口内 VCC 有没有 3.3V、AOUT 接牢没、100k 并上没。
5. 所有 GND 共地；3V3 ↔ GND 并 470µF 电容吸收继电器吸合浪涌。

### 端子形状不匹配：需要过渡线

探头三根线末端是**杜邦头**，ESP32 是**公排针**，继电器两侧却是**螺丝压接端子**（`DC+ / DC- / IN` 与 `NO / COM / NC`）。螺丝孔只能压裸铜线，杜邦头插不进去，所以凡是要接继电器的一端都得做一根「一头是插头、一头是裸线」的过渡线：

| 继电器端子 | 对面 | 过渡线做法 |
|---|---|---|
| `NO` | 探头红线（杜邦母头） | **公对公杜邦线**：公针插母头，另一头剪掉剥皮 5mm |
| `COM` / `DC+` / `DC−` / `IN` | ESP32 `3V3` / `GND` / `D27` 公排针 | **母对母杜邦线**：一头母头插排针，另一头剪掉剥皮 5mm |

多股软线先拧紧再镀锡，露铜别超过 6mm（隔壁端子很近，容易搭短路），拧紧后轻拉确认不脱；**断电接线**。想长期可靠就剥皮后压一只管形冷压端子（E0508）再进螺丝孔。探头的 GND 与 AOUT 是杜邦母头，直接插 ESP32 的 `GND` / `VP` 排针即可，不用转接。100kΩ 电阻两端是硬引脚，用面包板或焊两根杜邦线跨接在 AOUT 与 GND 之间。

> **两个常见误区**
> 1. 杜邦公针（0.64mm 方针）**不能**直接塞进螺丝孔拧紧当裸线用：压片夹不紧、接触只有一条线，继电器每 30 分钟间歇吸合的振动会让它松动；针体偏长还容易搭到隔壁端子短路。临时应急有时能导通，但探头供电这路一旦接触不良，采样窗口会读到六路全 0、被判成「探头无供电」，故障极难归因。
> 2. 模块左侧黄色跳线帽旁那组排针是 `High/Low Level Trigger` 的 **H/L 选择跳线**，不是输入端，别把 IN 线插到那里。这块板的输入只有蓝色螺丝端子 `DC+ / DC- / IN`。

### 一个 3V3 针要带两根线

`COM`（触点 → 探头 VCC）和 `DC+`（线圈电源）是**两条互不相连的回路**，继电器触点与线圈本来就隔离，所以两处都得取 3.3V，不能只接一处。三种做法：

1. **最省事**：在 `COM` 螺丝孔里同时压两根线 —— 一根来自 ESP32 `3V3`，另一根短接到 `DC+`。两根多股线先互相拧紧/镀锡再一起插进去拧紧，轻拉两根都不脱。这样 ESP32 的 `3V3` 只出一根线。
2. **最清爽（推荐）**：用面包板或端子台做电源分配，`3V3` 引到同一行，`COM` 与 `DC+` 各接这一行。
3. 焊一根一分二短线：两根裸端拧在一起焊到带母头的第三根线上，母头插 `3V3`。

线圈约 73mA + 单路探头 5~20mA，加 ESP32 自身约 250mA，板载 3V3 稳压器带得动；吸合瞬间有浪涌，`3V3` ↔ `GND` 并 470µF 电解更稳。

`GND` 一侧同样要接多路（`DC−`、探头 GND、100k 一端，接泵后还有 MOS Source）。**优先用板上两个 GND 针分开走**：右侧 `GND`（`VIN` 下面那个）接继电器 `DC−`，左侧 `GND`（`3V3` 下面那个）接探头 GND 与 100k。两个 GND 内部是连通的，但分开走线能避免线圈吸合浪涌耦合进 ADC 读数。还不够分再用面包板做公共地，或把 `DC−` 螺丝孔当汇流点（就是 `COM` 孔压两根线的对称做法：孔内同时压去 ESP32 GND、去探头 GND、100k 一端的线，多股线先互拧镀锡）。

`DC−` 到 GND 的连接本身：取一根杜邦线，**留母头插 ESP32 `GND` 排针，另一头剪掉剥 5mm 皮**，裸铜线压进 `DC−` 螺丝孔拧紧；接完轻拉不脱，万用表通断档量 ESP32 GND ↔ 探头 GND ↔ `DC−` 应全通。**断电接线**。

## 十、6 路全量落地：别把线都拉回板子

照第二节逐路接，6 路 × 9 根 ≈ 54 根，加共享线快 60 根，看着吓人。**实际真正回到 ESP32 的只有 16 根**，其余都能在元件附近并掉。关键是先把「共享母线」和「每路独有信号」分开，而不是 6 套线各拉各的。

### 1. 共享的只有 4 条母线

| 母线 | 电压 | 从哪来 | 分给谁 | 线径 |
|---|---|---|---|---|
| `VCC_S` | 3.3V（经探头继电器 NO） | ESP32 3V3 → 继电器 COM→NO | 6 路探头 VCC | 细线，合计 30~120mA |
| `GND` | 0 | 5V 适配器 GND | 探头 GND / 100k / 继电器 DC− / 6 个 MOS Source | 细线 + 1 根粗回流 |
| `5V_P` | 5V | 5V 适配器正极 | 6 个泵 + | **AWG18 主干**，泵电流走这里 |
| `GND_P` | 0 | 汇流排 | 6 个 MOS Source → 泵 − 回路 | 每路 AWG22 以上 |

6 个探头 VCC 并成一条、6 个泵 + 并成一条、所有 GND 并成一条，这三条做出来，线立刻少一半。

### 2. ESP32 上一共只插 16 根针

| 用途 | 针数 | 板上丝印 |
|---|---|---|
| 6 路 AOUT | 6 | VP / VN / D34 / D35 / D32 / D33 |
| 6 路 Gate | 6 | D13 / D18 / D19 / D23 / D25 / D26 |
| 探头继电器 IN | 1 | D27 |
| 3V3 / GND | 3 | 3V3 ×1、GND ×2（分开走，见第九节） |

### 3. 四种散件就地焊，一根都不回板子

| 元件 | 焊在哪两点之间 | 位置 |
|---|---|---|
| 100kΩ | 探头 AOUT ↔ GND | 探头插头根部，套热缩管 |
| 100Ω | ESP32 Gate 线 ↔ MOS Gate | MOS 这头串进去 |
| 10kΩ | MOS Gate ↔ GND | MOS 这头 |
| 1N4007 | 泵 + ↔ 泵 −（阴极朝 +5V） | 泵接线端子处 |

这些东西如果在面包板上全拉回 ESP32 旁边，才是「线爆炸」的真正原因。焊在元件那头，每路只剩一根 AOUT 和一根 Gate 是长线。

### 4. 推荐结构：一块分配板

用一块万能板或两组 6 位螺丝端子台，做 3 条汇流排，ESP32 用一束 16 芯排线接过来：

```
ESP32 ── 16 芯排线 ──> [ 分配板 ]
                          │ 汇流排：VCC_S(3V3) / GND / 5V_P(AWG18)
                          ├─ 探头侧 6 位端子 ── 8 芯干线 ──> 6 个探头
                          │    每路只出 AOUT；VCC/GND 在端子上并
                          └─ 泵侧   6 位端子 ── 6 根 Gate + 5V 粗线
                               每路只出 Gate；5V 与 Drain 回路在板上闭环
```

这样 ESP32 上是一束整齐的排线，不是几十根散杜邦线；机箱里探头线束走左下、泵 5V 粗线走右上，**强弱电不平行长距离并行**，泵启停的电流突变才不会耦合进 ADC。

**探头侧 8 芯干线**：`VCC_S + GND + 6×AOUT = 8 芯`，用一截超五类网线就够（合计 30~120mA，线径完全够），拉到花盆区再分叉，末端每路并 100k。**泵侧 5V 千万别走网线**，单独拉 AWG18 到汇流排。

### 5. 颜色和编号

| 线色 | 用途 |
|---|---|
| 红 | 5V 泵正极（粗） |
| 橙 / 白 | 3V3 探头 VCC（经继电器 NO） |
| 黑 | GND |
| 黄 | 探头 AOUT |
| 蓝 | MOS Gate |

**每根线两端都贴 `CH1`~`CH6` 标签**。6 路一模一样的线，不贴标签的话，查一次接错的 AOUT 要花半小时。线长留 10cm 余量，方便以后换探头。

### 6. 分三批上，别一次接满

| 批次 | 做什么 | 验收 |
|---|---|---|
| 1（现在） | 补齐 100kΩ，接 1 路 MOS 泵（D13） | CH1 `raw≈2600~2900 / flt=0`，点浇水 Gate 变 3.3V |
| 2 | 扩到 CH1~CH3 | 每扩一路读一次 `/api/state`：新路 `flt=0`，其余仍 `flt=1`；逐路点浇水，其他路读数不跳 |
| 3 | 补齐 6 路 | 六路 `flt=0`，做一次干湿点标定，再启用自动 |

每批之间**断电接线**，接完先验共地（万用表通断档量 ESP32 GND ↔ 探头 GND ↔ `DC−` ↔ MOS Source 全通）。

### 7. 省事替代：成品多路 MOS 板

买一块 8 路逻辑电平 MOS 驱动板，可以一次省掉 6×(100Ω + 10k + 1N4007) 的散件和焊接。下单前必须确认四条：

1. **低边 N-MOS**（切泵负极），不是高边、也不是 P 沟道
2. **3.3V 栅极能完全导通**（AO3400 / IRLB8721 一类），IRF520 那种 5V 才够的会半导通发热
3. **每路自带 10k 栅极下拉**，否则上电窗口泵会误转
4. **共地**，板子 GND 与 ESP32 GND 必须连

> 不建议改用常见的「8 路继电器板」：那些板大多是 **5V 供电 + 低电平触发**，而固件是 `PUMP_ACTIVE_LOW = 0`（高电平开泵），接上去会**一上电 6 个泵全开**。真要用就得把 `PUMP_ACTIVE_LOW` 改成 `1` 重新烧录，并按第七节重算 3V3 电流账。

### 8. 六路版上电总自检

1. 万用表通断：所有 GND 全通；5V ↔ GND 不短路
2. 未接 ESP32 时，量 6 个 Gate 对 GND 全为 0V（10k 下拉生效）
3. 先只接探头不接泵：六路 `raw` 都在 1000~3000 且 `flt=0`，否则查 VCC 窗口、AOUT、100k
4. 逐路点「浇 15s」，一次只开一路：对应泵转、**其他路读数不乱跳**（跳了就是共地或 3V3 电容没做好）
5. `3V3 ↔ GND` 的 470µF 电解别漏；探头继电器吸合瞬间最容易把 3V3 拉塌

> 想把这套分配板直接固化成 PCB（含板型规格、BOM、完整网表、布局分区与下单检查清单），见 [docs/PCB.md](PCB.md)。**只装一套的话不用打板**，按下一节接即可。

## 十一、一套 = 1 主控 + 6 探头 + 6 泵

「一套」指**一台 ESP32 主控带满 6 路**，不是只装 CH1 一路。固件 `CHANNEL_COUNT = 6`、6 个 ADC 脚 + 6 个泵脚本来就是按这个写的，**不用改、不用重烧**。

当前进度（2026-11-09）：**配件已全部到齐** —— 6 只 HW-390、6 只 100kΩ、两块 YYNMOS-4、470µF、5V/5A 电源、3P/2P 端子与超五类网线。探头供电继电器 + 第 1 只探头此前已接好并验证（`raw≈2900 / flt=0`），现进入全量接线。下面「逐针接线总表」可直接照着施工。

### 先说一个坑：YYNMOS-4 只有 4 路，带不动 6 路

这块是 **4 路**光耦隔离 MOS 驱动板，而主控有 **6 路泵**。三个选择：

| 方案 | 做法 | 建议 |
|---|---|---|
| **再买一块同款** | 2 块共 8 路用 6 路，两块 `电源±` 并到同一个 5V 电源、所有 `GND` 并到 ESP32 GND | **最省事**，别的都不用改 |
| 退换 8 路板 | 一块搞定，省地方 | 还没发货就换 |
| 4 路模块 + 2 路分立 MOS | 混搭 | 不推荐，两套接法容易接错 |

> 泵实际少于 4 个的话一块就够，不用买第二块；空着的通道仍会被故障闸门挡住，**不会误开泵**。

### 探头侧：6 只共用 1 个供电继电器

| 从 | 到 | 数量 |
|---|---|---|
| 继电器 DC+ / COM | ESP32 **3V3** | 已接（两处一分二） |
| 继电器 DC− | ESP32 **GND** | 已接 |
| 继电器 IN / 跳线 | **D27** / **H** | 已接，已验证有效 |
| 继电器 **NO** | **VCC_S 母线** → 6 只探头 VCC 并联 | 1 条母线 |
| 6 只探头 GND | ESP32 **GND** 母线（不过继电器） | 1 条母线 |
| 6 根 AOUT | **VP / VN / D34 / D35 / D32 / D33** = CH1~CH6 | 各走各的 |
| **每路 AOUT ↔ GND 并 100kΩ** | **并在各自探头端** | **6 只，不是 1 只** |

**6 只探头分散时**：用一截超五类网线做干线 —— `VCC_S + GND + 6×AOUT = 8 芯`，拉到花盆区的分线盒再分叉，每只探头根部并自己的 100kΩ。AOUT 与 GND 尽量走同一对双绞，探头线离泵线 ≥20cm，距离分档见下一节。

6 只探头合计 **30~120mA**，一块继电器触点完全带得动（第八节：8~10 路以内没问题）；6 路滤波电容并联有吸合冲击，`3V3 ↔ GND` 并 470µF。3V3 稳态约 **353~443mA**，仍在 640mA 限额内。

### 泵侧：2 块 YYNMOS-4 的引脚分配

模块参数：输入 3~20V 电平/PWM、输出 DC 3.7~27V 每路 10A、带输入/输出指示灯、输入输出隔离。**10kΩ / 100Ω / N-MOS 管全在板上，不用自己焊**。

#### 实物丝印对照（2026-11-12 到货实物，照板上印的接）

到货这块板印的字和本文称呼**不完全一样**，找丝印时别找错：

| 实物丝印 | 本文里的叫法 | 位置 / 形状 |
|---|---|---|
| `PWM1 GND1 PWM2 GND2 PWM3 GND3 PWM4 GND4` | `PWM1~4` / `GND1~4` | 上排 **8 个交错圆孔**，每路一对「信号 + 信号地」 |
| `DC+ DC-` | **`电源+ / 电源−`** | 下排最左 2 个孔，就是 5V 输入，**实物上没有「电源+」三个字** |
| `OUT1+ OUT1- … OUT4+ OUT4-` | `OUT1±~OUT4±` | 下排右侧 8 个孔，接泵 |

四条实物注意：

1. **上排 / 下排是通孔焊盘，不是蓝色螺丝端子**：要么焊一排 2.54 排针插杜邦头，要么直接把线焊进孔里，别把裸线拧在孔上凑合（浇水时振动会松，PWM 一丢泵就不转）。
2. **右侧若另有一个蓝色 2P 螺丝端子已焊在板上**（常见版本），一般就是 5V 电源输入、与 `DC+ / DC-` 同一网络：**先断电用通断档量蓝端子两孔 ↔ `DC+` / `DC-` 是否分别全通**，确认同网络后**只接一处**即可，`DC+ DC-` 空着正常；不通就别猜，按丝印只接 `DC+ DC-`。
3. **隔离接法别破坏**：信号侧 `GND1~4` 只接 ESP32 GND，电源侧 `DC-` 只接 5V 电源负极，别再从蓝端子拉一根 GND 去接 ESP32 制造额外回路。双电源调试时第十二节第 3 步第 3 量会验 `电源− ↔ ESP32 GND` **不导通**；**改成单电源部署后这两点必然导通、属正常**（见第三节与 `docs/PCB.md` 12.5），别按旧判据当短路拆线。若蓝端子与 `DC±` 同网络，只接一处即可。
4. `OUT+` 直通 5V 正极、`OUT−` 才是被 MOS 拉低的负端，泵**红线 → `OUT1+`、黑线 → `OUT1−`**，见第十二节第 6 步先量后接。

| 通道 | ESP32 泵脚 | 模块 |
|---|---|---|
| CH1~CH4 | **D13 / D18 / D19 / D23** | A 块 `PWM1~4` |
| CH5~CH6 | **D25 / D26** | B 块 `PWM1~2`（另 2 路空着） |

两块板的公共接法：

| 从 | 到 | 备注 |
|---|---|---|
| 两块 `GND1~4` | ESP32 **GND** | 所有信号地并一起 |
| 两块 `电源+ / 电源−` | 同一个 **5V/5A 电源** | **AWG18 主干**并联 |
| 6 个泵 ± | 对应路 `OUT±` | 每路 2 根 |
| 每路 `OUT+ ↔ OUT−` | 并 1N4007，阴极朝 OUT+ | 模块自带续流就省 |

> **隔离接法**：`GND` 只接 ESP32 GND，`电源−` 只接 5V 电源负极，两者不必再连。模块**不用另外接 3V3**（输入光耦靠 PWM 信号驱动、输出侧靠 `电源±`）。泵的大电流不流经 ESP32 的地，6 路读数更稳。

**到货先空载验两件事，别急着接泵**（只接 D13 + GND1 + 5V 电源，OUT1 空着）：

1. **3.3V 能不能可靠触发**：点「浇 15s」看**输入指示灯**稳定亮。规格 3~20V，3.3V 踩在下限；不亮或闪就得加电平转换。
2. **极性**（商品页没写，必须量）：万用表测 `OUT1+` 对 `OUT1−`
   - 浇水时 ≈5V、平时 0V → 高电平触发，`PUMP_ACTIVE_LOW = 0`，**固件不用改**
   - 反过来 → 低电平触发，`config.h` 里 `PUMP_ACTIVE_LOW` 改 `1` 重烧一次

   > 极性搞反会「上电后泵一直转」，这一步不能跳。

不用成品模块、改回分立低边 N-MOS 的接法见第二节，每路重复 6 次。

### 一套要补的料（6 路）

| 元件 | 数量 | 备注 |
|---|---|---|
| **100kΩ** | **6** | 每路 AOUT 泄放，并在探头端 |
| HW-390 探头 | 5 | 已有 1 只 |
| **YYNMOS-4 模块** | **再 1 块** | 或退换成 8 路板 |
| 1N4007 | 6 | 模块自带续流就省 |
| 470µF 电解 | 1 | 3V3 缓冲，6 路吸合浪涌用 |
| 5V/5A 电源 | 1 | 固件互斥，同时只开 1 路泵，够用；实测泵仅 100~200mA，余量很大 |
| 一进二出分线端子 / SPL 杠杆分线器 | 1 | 部署时把 5V 分成「泵粗线 + ESP32 5V 细线」两路，见第三节；不买可 T 型焊接 |
| **USB-C 公头 → 2P 端子 / 裸线取电线** | 1 | 单电源部署时给 ESP32 的 USB-C 口送 5V，**不用找 `VIN` 排针**，见第三节实物核对；可剪废弃 USB-C 数据线只留红黑 |
| 超五类网线 | 1 截 | 8 芯干线，探头分散时 |
| 3P / 2P 可插拔端子 | 6 / 6 | 探头 / 泵各 6 个 |
| ~~10kΩ / 100Ω / N-MOS~~ | — | 模块自带 |

### 逐针接线总表（照着接，6 路全量）

> 断电施工。上面各节讲原理，这张表是施工顺序；每接完一组用万用表量一遍再进下一组。
> 若到货的是 **1 块 8 路板**：把下表 A/B 块的 `PWM1~4 + PWM1~2` 换成同一块板的 `PWM1~6`，其余完全不变。

**A 组 · ESP32 上最终只有 16 根针**

| # | ESP32 丝印 | 接到 | 线色 |
|---|---|---|---|
| 1~6 | VP / VN / D34 / D35 / D32 / D33 | 探头 CH1~CH6 的 AOUT | 黄 |
| 7~10 | D13 / D18 / D19 / D23 | A 块 `PWM1~4` | 蓝 |
| 11~12 | D25 / D26 | B 块 `PWM1~2` | 蓝 |
| 13 | D27 | 探头继电器 `IN`（跳线保持 **H**） | — |
| 14 | 3V3 | **一分二** → 继电器 `DC+` 与 `COM` | 橙 |
| 15 | GND① | 继电器 `DC−` + 6 只探头 GND + 两块板 `GND1~4` | 黑 |
| 16 | GND② | 470µF 负极 + 汇流排 | 黑 |

**B 组 · 探头侧 8 芯干线**（超五类网线：`VCC_S + GND + 6×AOUT`）

| 芯 | 用途 | 起点 → 终点 |
|---|---|---|
| 1 | `VCC_S` | 继电器 `NO` → 6 只探头 VCC 并联 |
| 2 | `GND` | ESP32 GND → 6 只探头 GND 并联 |
| 3~8 | `AOUT1~6` | VP / VN / D34 / D35 / D32 / D33 → 各自探头 AOUT |

每只探头根部 `AOUT ↔ GND` 并 **1 只 100kΩ**（共 6 只），套热缩管；`3V3 ↔ GND` 并 1 只 **470µF**（注意极性）。AOUT 与 GND 走同一对双绞，探头线离泵线 ≥20cm。

**C 组 · 泵侧 2 块 YYNMOS-4**

| 通道 | ESP32 | 模块输入 | 模块输出 |
|---|---|---|---|
| CH1~CH4 | D13 / D18 / D19 / D23 | A 块 `PWM1~4` | `OUT1±~OUT4±` → 泵 1~4 |
| CH5~CH6 | D25 / D26 | B 块 `PWM1~2` | `OUT1±~OUT2±` → 泵 5~6 |

两块板的公共线：

| 从 | 到 | 备注 |
|---|---|---|
| 两块 `GND1~4` | ESP32 GND | 信号地全并一起 |
| 两块 `电源+` | 5V/5A 正极 | **AWG18 主干** |
| 两块 `电源−` | 5V/5A 负极 | 与 GND 隔离，不必再连 |
| 每个 `OUT+ ↔ OUT−` | 1N4007（阴极朝 `OUT+`） | 模块自带续流就省 |

模块**不用另接 3V3**；ESP32 继续用 USB 供电，泵电流不经过板子。

**D 组 · 通电前最后三量**

1. 所有 GND 互相导通（ESP32 GND ↔ 探头 GND ↔ `DC−` ↔ 两块 `GND1~4`）。
2. `电源+ ↔ 电源−` 不短路、`5V ↔ GND` 不短路。
3. OUT± 全部空载时先验极性（见上文「到货先空载验两件事」），确认是高电平触发再接泵。

### 上电自检（6 路版）

1. **断电接线**，量 `电源+ ↔ 电源−` 不短路、所有 `GND` ↔ ESP32 GND 导通。
2. 先只插 USB、不接泵，读 `/api/state`：已接的通道 `flt=0` 且 raw 在 1000~3000，没接的仍 `flt=1` 正常；**每接一只探头复查一次**。
3. 6 只接齐后应六路 `flt=0`；逐路做一次干/湿点标定（6 只探头个体差异不小）。
4. 逐路点「浇 15s」，一次只开一路，看对应泵转、**其他 5 路读数不跳**。
5. `3V3 ↔ GND` 的 470µF 别漏；确认模块极性和 3.3V 触发 OK 后再接泵。

**固件不用改、不用重烧**（前提是模块高电平触发）。6 路全接齐后，远程页 6 张卡片都会有真实读数。

### 常见想法：单探头用 CR2032 纽扣电池？

**不行**，三个硬限制（CR2032  datasheet 典型值）：

| 限制 | 数字 |
|---|---|
| 电流 | CR2032 **最大连续放电 3mA**、脉冲 15~20mA；HW-390 单路要 **5~20mA**，连续供电差 2~7 倍 |
| 电压 | CR2032 标称 **3.0V**，带载还会掉到 2.7~2.9V；探头规格 **3.3~5.5V** 且内置 LDO。欠压时 AOUT 满量程随电量持续下移，**干湿点标定全废**，读数会一天天漂 |
| 容量 | 210~235mAh，按 20mA 常供约 10 小时就见底；内阻 10~40Ω，大电流下压降更严重 |

**「间歇供电 + 大电容缓冲」也不划算**：本系统每 30 分钟只通电约 1 秒，平均电流确实只有几 µA，但每次要给探头板上 10~47µF 电容充电，脉冲会撞上纽扣电池的压降墙；而并联的 470µF 电解自身漏电流就有几 µA，和平均功耗同一量级，等于白省。

**给「探头 + WiFi 节点」供电更不可能**：ESP32 WiFi 发射峰值 150~300mA，是 CR2032 连续能力的 50~100 倍。

真正能用纽扣电池的只有**现成 BLE 土壤计**（小米花花草草一类）：深度休眠几 µA、只发几毫秒 BLE 广播、专门做了升压与缓冲，一年换一颗电池 —— 但那是另一套硬件，不能沿用现有探头和校准。自己搭电池节点请改用 **2 节 AA/AAA 或 1 节 18650 + 升压到 3.3V**。

> 现在这套直接用 ESP32 的 3V3 经探头供电继电器间歇取电，**零成本、不用换电池**，比纽扣电池方案更省。

### 探头线能拉多远

**6 只探头都在主控附近（几米内）的话随便接**，不用考虑限制。真要拉远参考下表 —— 注意 AOUT 是**模拟电压信号**，不能按网线传数字信号的 100m 来想：

| 距离 | 做法 | 结论 |
|---|---|---|
| ≤2m | 普通 3 芯杜邦线 | 直接接，现在这样 |
| 2~10m | 超五类网线：AOUT/GND 走同一对双绞，VCC/GND 走另一对 | **推荐，零问题** |
| 10~30m | 屏蔽双绞线，屏蔽层单端接地；末端 AOUT 对 GND 并 100nF | 可行，装好要重标定 |
| 30~50m | 再加粗 VCC（两芯并联）或末端就近取 3V3 | 勉强，误差明显 |
| >50m | **别拉模拟线**，见下 | 不可靠 |

**瓶颈不是线阻，是干扰**：24AWG 网线单程约 0.084Ω/m，探头按 20mA 算，10m 来回只掉约 0.03V，压降可忽略；100m 才掉约 0.34V，那时探头会欠压。真正麻烦的是 AOUT 是 0~3V 的**高阻抗模拟信号**，线一长就像天线，拾取 50Hz 工频和泵开关尖峰；**100kΩ 下拉把源阻抗拉低到 100k 量级，反而更不容易被干扰**（这也是它必须并在探头端、不能并回主控端的原因）。

三条规矩：

1. **AOUT 与 GND 走同一对双绞线**，别用两根散线；VCC 另走一对
2. 屏蔽层**只在 ESP32 这一端**接 GND，两端都接会形成地环路，反而更糟
3. **100kΩ 并在探头那端**（不是 ESP32 端）；探头线与泵线分开走，至少隔 20cm

装好后**在实际位置重做一次干点 / 湿点标定** —— 线一长，VCC 压降和分布参数会让 raw 整体偏移，出厂的 2800 / 1150 不一定准。`ADC_SETTLE_MS = 300ms` 对几十米线的 RC 稳定时间仍然够用。

**超过 30m 的正确做法**：别把模拟线拉那么远，**把 ESP32 主控放到 6 只探头的中心位置**，就近取 5V，让最远那只的线也控制在 10m 内，数据照旧走 WiFi 回巴法云 —— 比做无线探头节点还省事，也不用电池。再远就上 RS485 或 4~20mA 变送模块。

## 十二、第一批：只接 CH1（施工卡）

> 2026-11-09 起按本节施工，**断电接线**，一次只接一路。CH2~CH6 空着显示「故障 / 断线 `flt=1`」是正常状态。**固件不用改、不用重烧**，除非第 5 步量出模块是低电平触发。

**起点**：探头供电继电器 + 第 1 只 HW-390 已接好并验证（`raw≈2900 / flt=0`），但当时 100kΩ 尚未到货。本批要补 2 个元件、接 1 路泵。第九节是分立 MOS 版，本节按到货的 **YYNMOS-4 成品模块**接线。

### 1. 补两个元件（断电）

| 元件 | 并在哪两点 | 位置 | 注意 |
|---|---|---|---|
| 100kΩ ×1 | 探头 `AOUT ↔ GND` | **探头插头根部**，套热缩管 | 不在 ESP32 端；少了会读数飘、断线判不稳 |
| 470µF ×1 | ESP32 `3V3 ↔ GND` | 板子附近 | 电解有极性：**正极接 3V3、负极接 GND** |

### 2. 只接 4 根线，OUT1 先空载

| 从 | 到 | 备注 |
|---|---|---|
| **D13** | A 块 `PWM1` | CH1 泵脚 |
| **GND** | A 块 `GND1` | 信号地 |
| 5V/5A **+** | A 块 `电源+` | AWG18 主干 |
| 5V/5A **−** | A 块 `电源−` | **不要**再连 ESP32 GND，模块是光耦隔离 |

- `OUT1±` **空着，先别接泵**；`PWM2~4` 空着；**B 块整块先不上电**。
- ESP32 继续用 USB 供电，模块不另接 3V3。**部署要合并成一个 5V/5A 时见第三节「一个 5V/5A 怎么同时带 ESP32 和泵」** —— 那时 5V 优先经 USB-C 口送达（或实测确认的 `VIN` 排针），第 3 步第 3 量的判据也要跟着改。

**5V 适配器不是裸线、是 DC 圆头插头时**（最常见）：别剪原插头，加一根 **DC 5.5×2.1 母头转裸线**，或直接买一块「DC 母座转 2P 螺丝端子」小转接板 —— 母头插适配器，另一端两根线压进 A 块 `电源+ / 电源−`。

- **极性必须量**：标签上的极性图标只作参考，万用表直流档黑笔碰圆头外壳、红笔碰内芯 —— 读 `+5V` 说明**内芯正极 → `电源+`、外壳负极 → `电源−`**；读 `-5V` 就反过来。中心负极的适配器确实存在，接反会烧模块。
- 转接线和 DC 座要扛得住 **5A**：普通细尾线只有 1~2A，泵启动会发热压降，选 AWG18~20 或带螺丝端子的 DC 母座板。
- 若适配器输出是 **USB-C / USB-A 口**，改用对应 USB 取电线（`VBUS → 电源+`、`GND → 电源−`），并确认它能输出 5V/5A。
- 第 6 步说的「剥 5mm 裸铜压螺丝端子」指的是**泵线接 `OUT1±`**，跟适配器这头无关。

**圆头转接件买哪个**（方向别买反）：

| 选择 | 规格 | 说明 |
|---|---|---|
| **首选：DC 5.5×2.1 母座 → 2P 螺丝端子转接板** | 额定 **≥5A**、端子吃 18AWG、板上印 `+ / −` | 母头插适配器，端子出两根线进模块 `电源±`；免焊、可插拔 |
| 备选：DC 5.5×2.1 母头带线 | 18AWG、10~30cm、尾端裸线 | 直接压进模块端子 |

- **别买成「DC 公头 → 螺丝端子」**：那是插进设备母座用的，方向反了，插不上适配器的公头。搜索词用「DC 母座转接线端子」「DC 母头转 2P 端子」。
- **先量插头内径**：`5.5×2.1` 最常见，但大功率适配器也有 `5.5×2.5`。2.1 公头插 2.5 母座会松、接触不良；2.5 公头插不进 2.1 母座。拿不准就买「2.1 / 2.5 通用母座」或两种各一。
- 这类转接件常见标称只有 **3A**，5A 正好卡上限，下单看清额定值；端子一般吃 20~16AWG，配 AWG18 短线正合适。
- 以后两块 YYNMOS-4 共用电源时，在转接板端子处**并出第二对 AWG18** 即可，不用再买一个母座。
- **便宜的 2P 转接头常只标耐压不标电流**（商品页写「耐压 500V / 纯铜导体 / 插拔力 3~20N」，没有额定电流），实际多为 3A 级别，5A 卡在上限。首次接泵点「浇 15s」后**摸一下母座和端子**：温热没事，烫手就换更大规格或改成直接压线。固件互斥、同时只开 1 路泵，单路通常 1~2A，正常够用。
- 买的是 **5.5×2.5 母头**时只认一条：**插上去紧、不晃**。适配器公头若是 2.1 会明显松旷，必须换 2.1 母头，别凑合 —— 5A 下接触不良会发热甚至打火。

**实物更推荐「DC099 带线母座」**（面板式，`5.5×2.1` / `5.5×2.5` 规格可选，自带 20cm `1.0mm²×2` 芯纯铜线，标称 ≤16A@12V / 200W）：

- 规格可选，不怕买错 2.1 / 2.5；`1mm² ≈ AWG17`，5A 完全不发热，比不标电流的绿色 2P 转接头稳。
- 尾端剥 5mm 直接压进模块 `电源±`，不用另买 AWG18 短线；母座与线是**焊接成品，不用自己焊**。若尾端上锡，剪掉锡头重新剥裸铜再压（锡头压螺丝会冷流松动）。
- 面板件带金属螺纹外壳（开孔 11.5~12.5mm），不装箱体时**必须套热缩管/绝缘胶带包好**，别让它碰到端子短路。
- 尺寸拿不准就 5521 / 5525 **各买一个**，适配器公头分别试插，**紧、不晃的留下、另一个退**。商品页「用机顶盒充电器试插」判的是设备母座，判不了适配器公头。
- 极性按万用表量尾线两根：读 `+5V` 时红表笔那根 → `电源+`；商品页没写哪根对应中心针，别按线色猜。
  - **默认惯例（照着接，但仍要量一次）**：**红线 → `DC+`、黑线 → `DC-`**。红正黑负是这类带线母座的通用做法（中心针 = 正极、外筒/螺纹外壳 = 负极），"黑线接 DC+ 还是 DC-" 的答案就是 **`DC-`**。
  - **30 秒量法（不能跳）**：适配器插电、母座插到适配器公头上，万用表直流 20V 档，**黑表笔接黑线、红表笔接红线** —— 显示 `+5V` → 上面默认成立；显示 `−5V` → 极性反了，改成 **黑线 → `DC+`、红线 → `DC-`**。量之前把破皮露铜那段包好，表笔别同时搭到金属螺纹外壳。
  - 接反 `DC+ / DC-` 会直接烧 MOS 板输出侧与泵；压线前**断电**，剥 5mm 裸铜压紧、别上锡。压完上电前再量 `DC+ ↔ DC-` 不短路、`DC- ↔ ESP32 GND` 不导通（隔离接法）。
- **尾线外皮有破口 / 剥口露铜时先处理再接**（2026-11-12 实物：黑线靠母座根部有一小段外皮缺口）：把破皮那截**剪掉重新剥 5mm 裸铜**，或套一段热缩管包严。露铜一旦碰到金属螺纹外壳或红线，就是 5V/5A 直接短路，轻则烧适配器、重则烧 MOS 板。量极性时也先把破口包好，表笔别同时搭到外壳。
- 金属外壳是**带电侧之外的导体**，面板件不装箱体时必须整圈绝缘包好（685 行）；剥线、压端子前把适配器拔掉。

### 3. 通电前三量

1. 通断档：ESP32 GND ↔ 探头 GND ↔ 继电器 `DC−` ↔ A 块 `GND1` **全通**。
2. `电源+ ↔ 电源−` 不短路（先单独量适配器，再量接上模块后）。
3. `电源− ↔ ESP32 GND`：**调试期双电源（电脑 USB + 独立 5V 适配器）应不导通** —— 这是隔离接法的正常结果，不是断线；若此时导通说明两侧被误连了。
   > **改成单电源部署后这一条反过来**：ESP32 由同一个 5V/5A（USB-C 口或 `VIN` 排针）供电时，两点**必然导通、属正常**，别误判成短路。原理与分线做法见第三节「一个 5V/5A 怎么同时带 ESP32 和泵」。

### 4. 上电，先验探头侧

插 USB + 5V 适配器（**单电源部署时只插 5V/5A 即可，5V 已供电就别再插电脑 USB**，见第三节），等 1~2 分钟让 WiFi/NTP 起来，读 `http://192.168.31.177/api/state`：

| 项 | 期望 |
|---|---|
| `fw` | `1.1.3` |
| CH1 | `flt=0`、`raw` 1000~3000（干土约 2600~2900）、`pct` 有值 |
| CH2~CH6 | `flt=1`、`pct=0` —— 正常，别去修 |
| `mqtt` | `1`（1.1.3 起这个字段说真话） |

> IP 被 DHCP 换了就从路由器后台，或远程页 WSS 状态帧的 `ip` 字段取新地址。

### 5. 验模块极性（关键，别跳）

先在**通道 1 的设置**里确认「最长浇水」是 **15s** —— 浇水按钮用的是通道 `maxSec`，设成 300s 会让泵一次白转 5 分钟（空转说明见第 6 步末）。然后本地页点「浇 15s」：

1. A 块 **PWM1 输入指示灯**稳定亮 → 3.3V 能触发（规格 3~20V，踩在下限）；不亮或闪烁 → 要加电平转换，先别接泵。
2. 万用表直流档量 `OUT1+` 对 `OUT1−`：
   - 浇水 ≈5V、平时 ≈0V → **高电平触发**，`PUMP_ACTIVE_LOW = 0`，固件不用改
   - 反过来 → 低电平触发，把 `config.h` 的 `PUMP_ACTIVE_LOW` 改 `1` 重烧一次
   - 空载读数飘 → 跨 `OUT1±` 接 1kΩ 假负载再量（MOS 漏极开路，没负载时电压不确定）

> 极性搞反会「一上电泵一直转」，必须在接泵前确认。

### 6. 断电接泵，再验一次

#### 先单独试泵：泵沉水里、5V 直接点 1~2 秒（可以，推荐）

**可以，而且建议第一步就这么做** —— 但要分清你试的是哪一种：

| 想做的事 | 能不能现在做 | 前提 |
|---|---|---|
| **只试泵**：泵沉进水桶，5V 适配器 / DC099 尾线直接点两根线 1~2 秒，看哪次出水 | **可以，推荐** | 不用 ESP32、不用 MOS 板、不用点「浇水」、不用固件；点完记住**出水那次**接正极的是哪根线 |
| **整机通电**：泵已压在 `OUT1±` 上，给整套上电 | **先别**，除非第 5 步空载验极性已通过 | 极性没验就整机通电，最典型后果是「一上电泵一直转」；碳刷泵寿命只有 5~200h，几小时就能磨完 |

单独试泵怎么做：

1. 泵**完全浸没**在水桶 / 水盆里（非自吸，浸没即免灌水、免干转），出水口接内 6 外 8 软管或至少朝盆内，别对着板子和插座喷水。
2. **只有泵和线在水里**：YYNMOS-4、DC099 母座、ESP32、所有螺丝端子和适配器插头放高处 / 干燥桌面，离水面 ≥30cm；泵线留一段松弛下垂的**滴水弯**，别让水顺着线爬到端子（毛细 / 虹吸）。
3. 通电前确认：**黑线根部破皮露铜已包严**（本节第 2 步）、`DC+ / DC−` 极性已用万用表量过、右侧蓝 2P 端子与 `DC±` 是否同网络已量清（同网络只接一处）。
4. 5V 只**点 1~2 秒**就断，肉眼看出水即可；不出水就断电对调两根线再点一次，记住出水那次的正极线色。别长按试几分钟。
5. 试完断电、把线捞出来擦干，再按本节接 `OUT1+ / OUT1−`。

> 这一步的价值：先把「泵是好的、极性对、能出水」三件事定死，后面整机点「浇 15s」不出水时就只剩模块 / 接线 / 固件三个方向可查，不用再怀疑泵。

**整机首次通电仍按第 5 步 → 第 6 步顺序**：空载验 `OUT1±` 极性（浇水 ≈5V、平时 ≈0V）→ 断电接泵 → 点「浇 15s」→ 肉眼看出水。首次整机通电**手放在电源开关上**，`maxSec` 保持 15s，泵不停立刻断电（见「常见不对劲」表）。

#### 到货实泵：USB 循环泵（2026-11-12 商品页）

商品页参数照抄：**DC 3~5V / 100~200mA / 扬程 0.3~0.8m / 流量 1.2~1.6L/min / 28g / 工程塑料**，配 **内 6 外 8** 软管，有卧式 / 立式 / 水陆两用几种。商品页自己写的三句最关键：

> 「这是循环泵，**不是自吸泵**，在陆地要先灌满水才能抽」「电机是**碳刷电机**，寿命正常使用 5 小时至 200 小时左右」「吸到杂物卡到齿轮会转不动」

据此，前面几节的通用结论收敛成**本套的确定答案**：

| 之前的问题 | 本套实泵的确定答案 |
|---|---|
| 空转会不会坏 | **不能干转，而且不灌水根本抽不上水**。它不是隔膜自吸泵，归入本节「泵空转」表格第二行（离心/叶轮、靠水润滑）。**唯一推荐装法：把泵沉进水箱 / 水桶里，用水陆两用的潜水用法** —— 叶轮常浸没，免灌水、永不空转，出水口接内 6 外 8 软管引到花盆。若必须放陆地，泵要**低于水面**，通电前把泵腔和进水管**灌满水排净空气** |
| 扬程 / 管路 | **只有 0.3~0.8m**，按 ≤0.5m 留余量：花盆出水口别高过水面太多，管子别拉太长、别打死弯，否则流量掉到几乎不出水。水箱尽量与花盆齐平或略高，**别把泵架在高处从桶里吸水**（非自吸，吸不上来） |
| 一次浇多少 | 1.2~1.6L/min ≈ **20~27mL/s**，`maxSec=15s` 约 **300~400mL**，够一盆花；要更多加时长，别指望加扬程 |
| 接反了会怎样 | 两线有刷、内部无驱动板 → 按本节「泵线接反」，**不会烧、只反转**；但循环泵反转基本抽不上水，仍以肉眼看出水为准 |
| 桌上那只 1N4007 | **别装**。0.1~0.2A 小泵，YYNMOS-4 自带续流足够；1kΩ 也只在第 5 步空载量极性时用、量完拆 |
| 碳刷干扰 | 碳刷换向火花是这套里最强的干扰源，6 路 AOUT 是 100kΩ 高阻：**泵线单独走、与 8 芯探头干线分开不捆扎、交叉时垂直、间距 ≥20cm**；每只泵端子就近并一只 **100nF 瓷片**抑火花（没有就先靠拉开线距，不够再补，几分钱一只）。浇水时若 `/api/state` 的 CH1 `raw` 明显跳，先查这里，不是探头坏了 |
| 卡杂物 | 进水口套一小块海绵 / 旧丝袜当滤网。商品页明说「扭力有限，吸到杂物卡到齿轮会转不动」→ 卡住就是堵转，泵不转但日志照样记 `d=15`（假浇水），电流升高；不出水先断电清叶轮（商品页说用牙签拨进水口转盘） |
| 寿命 5~200h | 是**累计通电运行时间**，不是日历寿命。按 15s/次、每天 6 路各 2 次 ≈ 3 分钟/天，200h 是十年量级，**间歇浇水完全够**；怕的是连续空转、或模块极性反了「一上电泵一直转」—— 那几小时就能把碳刷磨完，第 5 步「极性反了立即断电」对这只泵尤其保命。以后补货顺手多带 2~3 只备用，坏了直接换 |

> 第二节电流账按常规 5V 泵保守取 **0.5~0.8A / 启动 1.5A**，实物只有 **0.1~0.2A**：**5V/5A 适配器与 AWG18 主干都大幅富余，不用换、不用改**，6 路全开理论也才 1.2A。别因为电流小就以为接错了。

**泵就两根线**：**红线 → `OUT1+`**、**黑线 → `OUT1−`**（模块自带续流就不装 1N4007）。YYNMOS-4 是低边开关，`OUT1+` 直通 5V 正极，`OUT1−` 才是被 MOS 拉低的负端，别当普通正负随便接。

拿不准先量：万用表黑笔接 `电源−`，红笔分别量两个端子 —— 恒为 **+5V** 的是红线端；点「浇 15s」时从 ≈5V 掉到 ≈0V 的是黑线端。**接上泵再量最准**（空载时 `OUT1−` 悬空会飘）。接反了有刷泵只是反转不出水、断电对调即可，但**无刷泵带驱动板反接可能直接烧板**，所以先量后接。泵线不是红黑时以泵体 `+ / −` 标注为准。

> 外加续流二极管时 1N4007 **阴极朝 `OUT1+`（红线侧）**、阳极朝 `OUT1−`（黑线侧）；螺丝端子剥 5mm 裸铜压紧、轻拉不脱，红线露铜别搭到相邻端子。

**桌上散件别接错**（2026-11-12 实物旁边摆着 1 只黑色二极管 + 1 只色环电阻）：

| 散件 | 去处 |
|---|---|
| 黑色 1N4007，**银色环那端 = 阴极** | 阴极朝 `OUT1+`（红线侧）、阳极朝 `OUT1−`；**模块自带续流就别装** |
| 色环电阻若是 **1kΩ** | 只是第 5 步「空载量极性」时跨 `OUT1±` 的**假负载**，量完拆掉，不留在最终线路 |
| 色环电阻若是 **100kΩ**（棕黑黄金） | 是探头 `AOUT ↔ GND` 用的（5.6 默认并在探头插头根部），**跟 MOS 板 / 泵线无关，别接过去** |

两者都**不能串进泵线**；泵就红黑两根，`OUT1+` / `OUT1−` 各一根。

#### 泵线接反会怎样（2026-11-12 追问）

**结论先给：这套两线有刷泵反接不会烧，只是反转 → 不出水或倒吸；断电把两根线对调即可，不用改程序、不用重烧、不用动 `PUMP_ACTIVE_LOW`。**

YYNMOS-4 是低边开关：`OUT1+` 恒挂 +5V，`OUT1−` 才被 MOS 拉到 GND。泵是纯阻感负载、本身无极性，反接只是把电机两端对调，电流路径仍是 `+5V → 泵 → MOS → GND`，不会短路、也不会倒灌 ESP32（`GND1~4` 与 `DC−` 本就隔离）。

**真正要防的是这三种「会烧」的例外**：

| 情况 | 后果 | 处理 |
|---|---|---|
| 泵里带无刷驱动板 / 小 PCB（不是两根裸线） | 等于电源反接，**直接烧泵内驱动** | 认泵体 `+ / −` 丝印，别靠线色 |
| 1N4007 是**并在泵两根线上**（跟着泵走）而不是并在 `OUT1±` 端子上 | 对调泵线时二极管方向也跟着反 → 相对端口变成正偏，MOS 一导通就把 +5V 经二极管直短到 GND，**烧二极管 / MOS / 适配器** | 二极管**永远按端子丝印定方向**：阴极朝 `OUT1+`、阳极朝 `OUT1−`，并在螺丝端子侧；对调泵线时它留在原位不动。模块自带续流就干脆不装 |
| 反接后反复长时间空转 / 堵转试探 | 泵体发热、寿命缩短 | 单轮 15s 内看结果，别连着试几分钟 |

**不会烧，但更坑的是「假浇水」**：隔膜泵内部单向阀方向固定，反转后吸/排口互换 → 泵在转、指示灯亮、`/api/logs` 照样记 `d=15`，**实际一滴水没出**；湿度不涨，自动逻辑可能按阈值反复触发浇水。离心 / 叶轮泵反转仍能出水，但流量扬程常掉一半以上、电流偏大；**本套实泵是离心循环泵、本就不自吸，反转基本一滴水都抽不上来**。所以本步验收**必须肉眼看出水**，不能只听泵响、只看日志。

**判断与改法**：

1. 断电，把 `OUT1+` / `OUT1−` 上两根泵线对调 → 上电再点「浇 15s」，看出水口出水即正确。
2. 万用表直流档量 `OUT1+` 对 `OUT1−`：浇水时红笔在 `OUT1+` 应读 **+5V 正值**（第 5 步）。这量的是端口，跟泵线怎么接无关。
3. 最省事：泵先不上板，拿 5V 适配器直接点一下两根线，记住**出水那次**接正极的是哪根，再按这个极性压到 `OUT1+`。
4. 泵线不是红黑、泵体有 `+ / −` 标注时，以泵体标注为准。

> **别和 `DC+ / DC−` 接反混了**：泵线反接只是反转，电源侧 `DC+ / DC−` 反接会**直接烧 MOS 板输出侧与泵**（本节第 2 步）。两个「接反」后果完全不同。

#### 泵空转会不会坏（2026-11-12 追问）

**短答：调试时空转几轮 15s 完全没问题；长期干转要看泵型 —— 隔膜泵能忍、潜水泵不行。空转不会烧 MOS 板，最怕的是「没水但系统以为浇过了」。**

> **本套实泵已确认（见本节开头「到货实泵」商品页参数）：离心式循环泵、不是自吸泵 → 归入下表第二行「不能干转」，而且不灌水连水都抽不上来。装法按「把泵沉进水箱」处理，别按隔膜泵的自吸能力规划管路。**

先分清两个容易混的「空载」：第 5 步是**模块没接泵**（`OUT1±` 悬空，量电压时跨 1kΩ 假负载），跟泵干转无关、绝对安全；本节说的是**泵已接上、但进水口没水 / 水管脱落 / 水箱抽干**，泵在干抽。

| 泵型 | 空转耐受 | 原因 |
|---|---|---|
| **隔膜自吸泵**（扁圆泵体、一进一出两个管口、能自吸；5V 浇水套件最常见） | **短时可以，长期连续不宜** | 隔膜靠偏心轮往复、不靠水润滑，规格书常写「可干转」；干抽负载更轻、电流反而更小。但单向阀片 / 隔膜 / 齿轮持续干磨，几小时级连续干转会明显折寿 |
| **离心 / 叶轮潜水泵**（圆筒全密封、进水口是格栅、必须泡水里） | **不能干转** | 陶瓷轴套靠水润滑兼散热，离水几十秒到几分钟就发热、磨轴、烧线圈，必须完全浸没 |
| 蠕动泵（挤压软管） | 可以 | 液体只碰软管，泵头无依赖水润滑的密封件 |

商品页写了「可空转 / 可干转 / dry running」的以规格书为准；拿不准按「短时调试可以、长期免谈」处理。

**电气上不会连累板子**：空转电流比带水更小，YYNMOS-4 和 5V 适配器不会过载，关断尖峰照旧由续流二极管吸收。要区分**空转 ≠ 堵转**：叶轮卡异物、泵轴卡死时电流会冲到堵转电流，那才可能烧 MOS 或触发适配器保护。

**系统层面才是真风险**：当前固件没有水位 / 流量检测，只要泵通了电就记「浇水完成 `d=15`」。水箱空了、水管脱落、上一小节接反不出水，都会变成**泵在转、日志有记录、湿度却没涨**，自动逻辑按阈值可能反复触发，把一次次短空转累积成连续干转。

**落地做法**：

1. 调试期随便点「浇 15s」，但**把 `maxSec` 留在 15s**；第 5 步强调别设 300s，就是怕一次白转 5 分钟。别为看日志连点十几轮。
2. 首次通水：隔膜泵先把进水管浸到水面下、水面别比泵低太多（自吸高度标称多在 0.5~2m，越近越可靠，超了会一直吸不上）；潜水泵必须先灌水排气、完全浸没再通电。
3. 长期运行：定期补水别让桶抽干；要自动防干转，最省事是加一个浮球 / 水位开关接空闲 GPIO 做「缺水禁浇」——**这要改固件，当前 1.1.3 没有该功能**。
4. 声音突然变尖、泵体发烫（尤其潜水泵）、电流异常升高 → 立刻断电查水位和进水口。

重新上电点「浇 15s」：

- 泵正好转约 15 秒后停，`OUT1` 输出指示灯同步亮灭
- 浇水期间 `/api/state` 的 `active` = `{"ch":0,"src":"manual","remain":...}`，结束回 `null`
- `/api/logs` 出现「开始浇水」与「浇水完成」，`d=15`（1.1.1 起日志带实际秒数）
- 远程页 CH1 卡片有读数、CH2~CH6 置灰；点故障通道会回 `sensor_fault`

### 常见不对劲

| 现象 | 查 |
|---|---|
| CH1 变 `flt=1` / raw≈0 | 100kΩ 没并上或并错端；采样窗口 VCC 有没有 3.3V（跳线 **H**）；AOUT 是否脱焊 |
| PWM1 输入灯不亮 | 3.3V 踩规格下限；`D13` 是否接在 `PWM1`、`GND1` 是否共地 |
| 上电泵立刻转 | 极性反了，**立即断电**，按第 5 步重判 |
| raw 乱跳 | 470µF 漏装；探头线与泵 5V 线并行走太近；**只在浇水瞬间跳 = 碳刷火花**，泵线离干线 ≥20cm、泵端并 100nF（第 6 步） |
| 泵转但不出水 | **非自吸泵**：先灌满水或把泵沉进水箱；扬程 >0.8m；泵线接反；进水口卡杂物（第 6 步商品页参数） |
| 点浇水无反应 | 只在 CH1 点；远程页令牌 `62517729`、设备 `mqtt=1` |

**验收完再进第二批**：扩到 CH1~CH3，每接一路读一次 `/api/state`，新路 `flt=0`、其余仍 `flt=1`，逐路点浇水看其他路读数不跳。

## 十三、探头想远离主控

**能，优先有线，别先想无线。** 先分清「远」的是谁：

| 情况 | 做法 |
|---|---|
| **只有探头远**，泵和电源留在主控旁 | 一截**超五类网线做 8 芯干线**（`VCC_S + GND + 6×AOUT`）拉到花盆区中心的分线盒再分叉，见第十节第 4 / 5 小节与**第十四节施工卡** |
| 探头和泵都在远处 | **把 ESP32 一起搬到花盆区中心**，就近取 5V（DC099 母座那套跟着走），只剩 WiFi 回巴法云，线反而最少 |

按距离分档（细节见第十一节「探头线能拉多远」）：

| 距离 | 结论 |
|---|---|
| ≤10m | **1 根**超五类 8 芯网线，`6×AOUT + VCC_S + GND`，零改动、零重烧；4 对双绞里 3 对走 6 路 AOUT、1 对走电源与地，**AOUT 没有专用回流线**，靠短距离和探头端 100kΩ 压住串扰 |
| 10~30m | **2 根屏蔽网线**（16 芯 / 8 对），每路 AOUT 配一根专属 GND 回线走同一对双绞；屏蔽层**只在主控端**接 GND，末端每路 `AOUT↔GND` 并 100nF，装好必须重标定 |
| >30m | 别拉模拟线，把主控搬到 6 只探头中心，让最远一只也 ≤10m |

四条硬规矩：

1. `100kΩ` 并在**探头端**，不是主控端（拉远后尤其关键）
2. 只有 4 对双绞，**一根 8 芯线做不到 6 路 AOUT 各配专用 GND**；≤10m 按第十四节线序表折中接，10~30m 必须改成两根网线
3. 探头线离泵 5V 粗线 **≥20cm**，不平行长距离并行
4. 装好**在实际位置重做干 / 湿点标定** —— 线一长 raw 整体偏移，出厂的 2800 / 1150 不一定准

6 只探头共用 1 个供电继电器、`VCC_S` 合计 30~120mA，网线线径完全够；末端并 100nF 时 `100kΩ × 100nF = 10ms`，上电稳定窗口 `SENSOR_SETTLE_MS = 500ms` 有 50 倍余量，不影响采样。**固件 `CHANNEL_COUNT = 6` 与采样逻辑都不用改、不用重烧，纯粹是布线问题。**

> **不推荐无线化**：泵本来就要拉电源线，探头无线只省信号线，难点全在供电 —— CR2032 带不动 HW-390（5~20mA、标称 3.0V 低于 3.3V 下限），ESP32 WiFi 节点峰值 150~300mA；ESP-NOW 自建节点还得重做继电器、100kΩ 与干湿点标定。现成 BLE 土壤计是另一套硬件，不能沿用现有探头和校准。

## 十四、只有探头远：8 芯干线施工卡

> 适用：**ESP32 + 探头供电继电器 + 两块 YYNMOS-4 + 5V 电源全部留在主控箱**，只有 6 只 HW-390 在花盆区。泵线短、不走干线。默认按 **≤10m** 给；10~30m 的升级见第 7 步，**干线改 RJ45 水晶头对接见 5.8**、**出线改 3P 直插座见 5.9**（两者一起做就是「整盒 0 接线、探头直插」，打板时的推荐形态）。

### 1. 拓扑

```
主控箱 ── 1 根超五类 8 芯 ── 花盆区中心分线盒 ── 6 根 ≤2m 三芯短线 ── 6 只探头
```

分线盒放在 **6 只探头的几何中心**，让每根短线都 ≤2m。别把分线盒放主控箱、再从那里各拉 6 根长线 —— 那样等于 6 条独立长模拟线，干扰和成本都翻倍。

### 2. 物料（6 路）

| 件 | 数量 | 说明 |
|---|---|---|
| 超五类非屏蔽网线 | 实际距离 + 2m 余量，1 截 | **端子版**整根用、不压头；**RJ45 版**两端压 `8P8C` 水晶头（见 **5.8**）；户外段选 PE 护套室外型；别拿 4 芯电话线凑 |
| 带盖塑料盒 | 1 | **不用 IP65 / 不打格兰头**，普通密封收纳盒即可，见 5.1 |
| 8P 进线端子 | 端子版 2 / RJ45 版 1 | 主控端 1；分线盒端改用板上 RJ45 座（5.8） |
| RJ45 母座 + 水晶头 + 压线钳 | 各 1 / 一包 / 1 把 | **可选，仅 RJ45 版**；座必须「无变压器、无灯」，选品与致命坑见 **5.8** |
| 主控端 `RJ45→8P 端子板` | 1 | 仅 RJ45 版，约 ¥3~8，把 8 芯散到 ESP32 针脚 |
| 6 位汇流排 | 2 | `VCC_S` 与 `GND` 各一条，1 进 6 出 |
| 3P 探头端子 | 端子版 6 / **直插版 0** | 每只探头 `VCC / GND / AOUT`；**打板直插版改在板上焊 6 个 3P 直插座，探头线直接插、不用压线**，见 **5.9** |
| 3P 延长线 | 直插版 6（按需） | 探头自带转接线通常只有 20~30cm，够不着就买成品 `3P 2.54 公对母延长线 1~2m`；仍是直插、免压线 |
| 100kΩ | 6 | **端子版**默认并在探头 3P 插头根部（`AOUT ↔ GND`），套双壁含胶热缩管，见 **5.6**；**直插版改贴到板上现成的 NC 焊位或焊到探头 PCB**，别在插头上并（会插不进座子），见 **5.9** |
| 100nF | 6 | 仅 10~30m 时用，与 100kΩ 并联 |
| 号码管 / 标签 | 1 套 | 两头都标 CH1~CH6，线序接错最难查 |
| 双壁含胶热缩管 | 1 卷 | 3:1 带胶，包接线点与 6 只 100kΩ 的电阻腿 |
| 自粘防水胶带 | 1 卷 | 整束接头外再缠一层 |
| 中性硅酮胶 / 热熔胶 | 1 支 | 盒底出线孔外圈封一圈，替代格兰头 |
| 带硅脂网线接线子 | 12 只 | 可选：完全不做盒子时用，见 5.1 方案 C |

> 上面 8P 端子 / 汇流排 / 3P 端子都是**可反复改线的舒适版**；一次性装好不用买，省钱替代见 **5.3**。**打板时若按 5.8 + 5.9 做「RJ45 进线 + 6 个 3P 直插座」，这套端子 / 汇流排 / 18 根短线全都不用买，盒内 0 接线**。

### 3. 8 芯线序（两端完全一致，按线色对应）

下表 `RJ45 pin` 列是**水晶头按 T568B 压好后的触点号**（弹片朝下、金属触点朝自己，从左到右 1~8）；用 `KF301-8P` 端子时**忽略这一列**，只按线色压，端子位号 1~8 = 表中从上到下顺序。

| 双绞对 | 线色 | RJ45 pin (T568B) | 干线用途 | 主控端接 | 分线盒端接 |
|---|---|---|---|---|---|
| 1 | 橙白 | **1** | CH1 `AOUT` | `VP / GPIO36` | 3P-1 `AOUT` |
| 1 | 橙 | **2** | CH2 `AOUT` | `VN / GPIO39` | 3P-2 `AOUT` |
| 2 | 绿白 | **3** | CH3 `AOUT` | `D34` | 3P-3 `AOUT` |
| 2 | 绿 | **6** | CH4 `AOUT` | `D35` | 3P-4 `AOUT` |
| 3 | 蓝白 | **5** | CH5 `AOUT` | `D32` | 3P-5 `AOUT` |
| 3 | 蓝 | **4** | CH6 `AOUT` | `D33` | 3P-6 `AOUT` |
| 4 | 棕白 | **7** | `VCC_S` | 继电器 **NO**（探头 VCC 母线） | `VCC_S` 汇流排 |
| 4 | 棕 | **8** | `GND` | ESP32 **GND** | `GND` 汇流排 |

> **换 RJ45 时最容易错的一件事**：标准 T568B 的 `pin4/5/6 = 蓝 / 蓝白 / 绿`，而早先端子版的自定义位号是 `4/5/6 = 绿 / 蓝白 / 蓝`，**正好反着**。业务通道按**线色**走、颜色不变；画板和接线时**不能把端子位号直接当 RJ45 pin 号**，否则 CH4/CH5/CH6 全错位。完整对照与 PCB 网表见 `docs/PCB.md` 第十一节。两端水晶头**都按 T568B，做直通线，不要交叉线**。

- **AOUT 只走干线、不过继电器**；继电器仍然只切 `VCC_S`，`GND` 全程直连，**绝不断地**。
- 6 路 AOUT 挤在 3 对双绞里、共用 1 根 GND，这是 ≤10m 的折中、不是严格差分。双绞本身能压住大部分串扰，**探头端 100kΩ 把源阻抗拉低才是关键**。
- 用屏蔽线时，**屏蔽层只在主控端接 ESP32 GND**，分线盒端剪断包绝缘；两头都接会形成地环路，反而更吵。

### 4. 分线盒内怎么接

**RJ45 版（5.8）/ 打板版**：水晶头直接插进板上的 RJ45 座，铜皮完成汇流，**盒内没有 8P 端子、没有汇流排、0 根跳线**，只在 6 个 3P 端子上压探头短线。**若再按 5.9 把 6 个 3P 端子换成 3P 直插座，连这 18 根短线都不用压 —— 探头线直接插，整盒 0 接线**。下面这段是「手工端子版」的做法。

`8P 进线端子` → 棕白 / 棕 分别上 `VCC_S` / `GND` 汇流排 → 6 个 `3P 端子` 的 VCC、GND 位各自从汇流排取电；橙白~蓝 6 根分别进 3P-1~6 的 AOUT 位。**100kΩ 默认不在这里并**（已在探头插头根部并好，见 5.6），盒内每个孔只压一根线；若选了「盒内侧」备选方案，才在每个 3P 端子的 `AOUT` 与 `GND` 之间并 1 只，电阻腿别碰到 VCC 位。

再从 3P 端子出 6 根 ≤2m 三芯短线到探头：VCC → 红线、GND → 黑线、AOUT → 黄/白线，**以 HW-390 板上丝印为准**。**100kΩ 默认并在探头插头根部**（5.6 给了免焊 / 焊接三种做法）；只有要求短线可插拔、拔线检测万无一失时，才把电阻留在盒内侧 3P 端子位。

> 第十二节、5.3、5.5 说的「并在探头插头根部」是**默认做法**，具体免焊 / 焊接步骤见 **5.6**；这里保留「盒内侧」只作可插拔场景的备选。两者都在**远端侧**，真正不能做的是把 100kΩ 并回主控箱 —— 长线分布电容会让 AOUT 上升沿变慢，电阻放主控端等于没装。

### 5. 走线规矩

1. 干线与泵 5V 粗线 **≥20cm**；必须靠近时 **90° 交叉**，不平行长距离并行，更不与 AC 220V 同管。
2. 户外段走 PVC 管或线槽，进盒处留**滴水弯**（线先下垂再上翘），网线外皮别长期泡水；**防水怎么做见 5.1，不用买 IP65 盒**。
3. 分线盒内留 10cm 余量，端子剥 5mm 裸铜压紧、轻拉不脱；铜丝别搭到相邻端子。
4. 两端线序表打印一份贴盒盖，逐路通电前用通断档对一遍。

### 5.1 防水不好做？三档降级，别硬上 IP65

**先想清楚要防的是什么**：HW-390 只有下端插土部分做了防潮，上半截**元件面（芯片 + 3P 插针）完全不防水**，浇水直接淋上去就短路。真正要保护的只有两处 —— **接线点**和**探头元件面**，不是「盒子要达到 IP65」。所以最有效的防水是**换个位置**，不是加等级。

| 做法 | 怎么做 | 适用 |
|---|---|---|
| **A. 挪到不淋雨处（首选）** | 分线盒放屋檐下 / 阳台内 / 花盆架背面 / 倒扣花盆底下，普通塑料盒甚至裸接线子都行，只做防溅 | 绝大多数阳台、窗台、棚下场景 |
| **B. 普通盒倒扣 + 孔朝下** | 带盖密封盒**盖朝下**、或把所有开孔开在底面；线从底孔穿出，孔外圈打中性硅酮胶 / 热熔胶封一圈，**不装格兰头**；盒内放一小包干燥剂 | 会淋到雨但能固定安装 |
| **C. 完全不做盒子** | 8 芯与 6 根短线用**带硅脂的网线接线子**逐个压接，100kΩ 焊 / 并在探头插头根部，每个接头套**双壁含胶热缩管**，整束再缠自粘防水胶带并做滴水弯 | 探头很分散、找不到地方装盒 |

三条比密封等级更要紧：

1. **别四面打胶全密封**：户外昼夜温差会让盒内凝露，封得严实反而积水排不出去。**孔朝下 + 底部留一点缝**，比全封死更耐用。
2. **100kΩ 电阻腿必须包双壁含胶热缩管**（3:1、内壁带胶），普通热缩管不防水；电阻别裸露在土面上，沾湿土会直接把 AOUT 拉偏。
3. **探头只插到板上的刻度线**：元件面朝上、别埋土、别正对浇水管；讲究点套一段热缩管或自封袋只露插针，但**别把插土端也包住** —— 电容测量靠的就是那段覆铜。

> 真要长期露天淋雨，才回头买 IP65 盒 + 格兰头；即便那时格兰头也必须**朝下**、备用孔用堵头堵死，否则一样进水。

**探头短线别用普通杜邦线露天走**：外皮一两年就脆化，改用 AWG24~26 三芯护套线，或直接再截一段网线用其中 3 芯。

> 探头本体到底能不能长期放户外、寿命多久，见 **5.4**。

### 5.2 直接可下单的清单（盒子 / 汇流排 / 3P）

电商上**搜「汇流排」基本搜不到东西**，它叫「分线端子 / 快速接线端子 / 一进多出分线器」；「3P 端子」也要搜型号，不然出来的全是 2.54mm 的 XH 胶壳。

| 件 | 搜这个词 | 具体规格 / 型号 | 数量 | 参考价 |
|---|---|---|---|---|
| 盒子（A 档） | `带盖塑料收纳盒 密封 小号` / `密封元件盒 带卡扣` | ≥150×100×60mm、不透明、螺丝或卡扣盖 | 1 | ¥5~15 |
| 盒子（B 档） | `无孔防水接线盒 ABS 150x100x60` | **买「无孔 / 不带孔」款**，带密封圈、螺丝锁盖；有日晒选 PC 抗 UV、别买透明盖 | 1 | ¥15~40 |
| 汇流排 | `一进六出 快速接线端子` / `SPL-62 二进六出` / `杠杆式分线器 一进多出` | **SPL / PCT 杠杆式**，标 `0.08~4mm² / AWG28~12`、250V/32A；二进六出空一个进孔即可 | 2 | ¥5~15/个 |
| 3P 探头端子 | `TB-1503 栅栏式接线端子排 15A 3位` | 螺丝压紧、0.5~1.5mm² | **8 个**（6 用 2 备） | ¥5~8/个 |
| 8P 进线端子 | `TB-1508 栅栏式接线端子排 8位` | 与 3P 同系列，主控端 / 盒端各一 | 2 | ¥8~12/个 |
| 管形端子 | `E0508 管形预绝缘端子 0.5mm²` | 配压线钳；一盒够用 | 1 盒 | ¥5~10 |

**为什么汇流排用杠杆式、3P 用螺钉式**：

- 网线单芯是 **24AWG / 约 0.2mm²**。`KF301`（22~14AWG）和 `TB-1503`（0.5~1.5mm²）都**压不紧这个细线**，直接拧上去会虚接，过几个月就读数飘。杠杆式分线器标 `AWG28~12`，细线直插最稳，还免螺丝刀、能反复改线。
- **若把 100kΩ 并在分线盒 3P 端子**（5.6 的备选方案），那个孔要同时塞「电阻腿 + 线芯」两根，只有螺钉端子做得到，杠杆端子容易夹不实 —— 这时 3P 选螺钉式并配 **E0508 管形端子**把网线芯套成 0.5mm² 再压；懒得买就把网线芯**对折成双股**再压，别上锡（锡头压螺丝会冷流松动）。
- **但按 5.6 默认把电阻并在探头插头根部时，这条理由就不成立了**：3P 端子一个孔只压一根线，`KF301`、杠杆分线器、接线子都能用，整套还能再省一截。

**到货必验（分线器最容易买错）**：标「二进六出」的有些是**两组独立电位**（给火 / 零线分色用的），6 个出孔并不全通。万用表通断档量：进孔 ↔ 6 个出孔**全部导通**，且 6 个出孔之间也两两导通，才算同一个 VCC_S / GND 母线。不导通的别用，会变成 VCC 与 GND 混接。

**另外两个坑**：

1. **`KF301-3P / 8P 可拼接`** 是更便宜的替代（5.08mm、能拼成一整排 18 位、约 ¥1/个），拼好热熔胶粘在盒底比 6 个 TB 各自固定还整齐；但它螺丝更小、线径下限 22AWG，**细线必须套 E0508 管形端子**。买 3P ×10（6 用 4 备）+ 8P ×2。
2. **盒子别买预开孔的**：预开孔都在侧面 / 顶面，装上去等于朝上接水。买无孔款，自己只在**底面**开孔；ABS 用阶梯钻低速钻，**别拿热烙铁烫孔**（局部碳化变脆、失去密封），孔周再打一圈胶补精度。尺寸宁可大一号，8 芯 + 18 根短线要留 10cm 余量。

> 这套算 **约 ¥60~110**（KF301 便宜、TB 系列贵但好压），好处是**每路都能单独插拔、改线不用剪**，比 IP65 盒 + 6 个格兰头便宜且好装。
>
> **若走 RJ45 水晶头对接（5.8）**：盒端 `TB-1508` 与盒内 2 条汇流排都不用买，改买 1 只 RJ45 座 + 水晶头 + 主控端转接板；`E0508` 管形端子仍留给主控端转接板压细线用。**再按 5.9 改 3P 直插座的话，这 6~8 个 3P 端子也不用买** —— 打板版整盒本来就没有螺丝端子。
>
> **如果只装一次、以后不动线，这整套都可以不买** —— 见 **5.3 极限省钱版**。

### 5.3 太贵了？极限省钱版：第一批 ¥0，六路全量 ¥10~25

**那 ¥60~110 买的主要是「可反复插拔、改线不剪线」**，不是电气性能。分线器、栅栏端子、无孔防水盒全是便利性溢价；一次性装好、以后不挪，用焊锡 / 压线帽做永久接头，电气上反而更可靠（少了螺丝虚接这个最常见故障点）。

#### A. 现在这一批（只接 CH1）：不新增采购，¥0

第十四节那套干线、盒子、汇流排、3P 端子**都是给 6 路齐了用的**。第一批只有 1 只探头：

1. 直接用**探头自带的 3P 杜邦母头线**接回主控（此前 CH1 已验通 `raw≈2900 / flt=0`），短线够长就先这么放着。
2. **100kΩ 并在探头插头根部** `AOUT ↔ GND`，电阻腿套热缩管 —— 这是唯一必须有的元件，用户已有；免焊 / 焊接三种做法见 **5.6**。
3. 接头用**绝缘胶带 / 自封袋**防溅即可，放屋檐下连盒子都不用。

先按第十二节做空载验极性、验泵；**等 CH1 全通了、确认探头位置不再挪，再买干线那套**。别为还没验证的 5 路先花钱。

#### B. 六路全量：约 ¥10~25

| 5.2 里的件 | 省钱替代 | 数量 | 参考价 |
|---|---|---|---|
| 无孔 ABS 盒 ¥15~40 | **家里现成的带盖保鲜盒 / 密封元件盒 / 大号自封袋**，倒扣、孔朝下（见 5.1 方案 B） | 1 | **¥0** |
| 杠杆分线器 ¥5~15/个 ×2 | **CE-1 / CE-2 闭端压线帽（奶嘴端子）**：VCC_S 7 根、GND 7 根各绞成一股塞进一只帽子压紧 | 2~4 只 | ¥0.1/只，一包 ¥3~6 |
| 8P 进线端子 ¥8~12/个 ×2 | **带硅脂网线接线子（UY / K1 / UR）**逐芯对接，或直接剥线绞接上锡 | 16~20 只 | ¥0.1/只，一包 ¥5~10 |
| 3P 探头端子 ¥5~8/个 ×8 | 探头自带 3P 排针 → **3P 杜邦母头线**直插；要更牢就把三根线**直接焊到探头 3P 插针根部** | 6 根 | 一包 10 根 ¥2~4 |
| E0508 管形端子 ¥5~10 | **省掉**：焊锡连接不压螺丝，不需要管形端子 | — | ¥0 |
| 双壁含胶热缩管 | **别省**，6 只 100kΩ 电阻腿与所有接头都靠它防水 | 1 卷 | ¥5~8 |

> 家里有烙铁 + 锡丝 + 普通热缩管的话，实际只需买 **3P 杜邦线 ¥3 + 双壁含胶热缩管 ¥6 ≈ ¥9**；没有烙铁就加一包接线子和压线帽（免焊，用钳子压），合计 **¥15~25**，仍只有 5.2 的 1/5。

**替代关系怎么落地**（第十四节线序表照旧，只换接头形式）：

- 8 芯干线进盒后，橙白~蓝 6 根 `AOUT` 各用**接线子 / 焊锡**接到对应探头短线的 AOUT；棕白 `VCC_S`、棕 `GND` 分别把 1 进 + 6 出共 7 根芯**剥皮绞成一股**，塞进 `CE-1` 压线帽压扁、外套热缩管 —— 这就是 1 进 6 出汇流排，成本 ¥0.1。
- 网线单芯 24AWG 太细，压线帽里**先对折成双股或几根一起绞**再塞，别单根直插，否则夹不实。
- 100kΩ 仍并在**远端侧**（盒内或探头根部），与 `AOUT / GND` 一起焊 / 压，套双壁含胶热缩管。

**要诚实说的三个代价**

1. **不能反复改线**：焊死或压线帽改一路就得剪掉重做；5.2 的杠杆端子是插拔式，适合还要调布局的阶段。所以顺序是「先用 A 档 ¥0 验 CH1 → 位置定了再一次性装死」。
2. **压线帽和接线子要买对**：接线子选**带硅脂**的（防潮，普通裸的接头几个月就氧化）；压线帽选 `CE-1`（0.5~1.5mm² 合计），别买成只吃 2 根线的小号。
3. **上一轮「别上锡」不矛盾**：那条说的是**锡头压进螺钉端子会冷流松动**；这里是**焊锡本身就是连接体**，不是压接，两者不是一回事。选了焊锡就别再套螺钉端子。

**唯一不能省的两样**：**按实际接了探头的路数**配 `100kΩ`（第一批 1 只，六路齐了 6 只；少了读数就飘 / `flt=1`）和**双壁含胶热缩管**（普通热缩管不防水，电阻沾湿土直接把 AOUT 拉偏）。盒子、端子、汇流排全都能省，这两样不能 —— 数量规则见 **5.5**。

### 5.4 探头能不能放户外

**可以，但要分三层看** —— HW-390 (V2.0.0) 不是「整体防水探头」，它是「插土部分耐腐蚀 + 上半截怕水」。

| 部位 | 户外能力 | 原因 |
|---|---|---|
| **插土感应区**（板下端到刻度线） | **可长期埋湿土，数年** | 电容式、感应面被阻焊层完整覆盖、无裸露金属电极，不靠电流穿过土壤 → 不会发生阻式探头那种电解腐蚀。这正是选它而不是 YL-69 的原因 |
| **上半截元件面 + 3P 插针** | **完全不防水，是唯一弱点** | 芯片、LDO、插针全裸露；淋雨 / 浇水直接淋上去会漏电、读数飘甚至短路 |
| **接头与 100kΩ** | 靠自己做防护 | 见 5.1：双壁含胶热缩管 + 滴水弯，普通热缩管不防水 |

公开规格：`DC 3.3~5.5V`、`AOUT 0~3.0V`、工作电流约 `20mA`、板长 `99×16mm`、`PH2.0-3P`；厂商标「耐腐蚀 / 防潮」指的**只是插土感应面**，不是整板。

#### 按场景怎么做（都不用买东西）

| 场景 | 做法 | 花钱 |
|---|---|---|
| **花盆 / 阳台 / 屋檐下（推荐）** | 只插到**板上刻度线**，元件面朝上、别埋土、别正对浇水管出水口；接头套热缩管 | ¥0 |
| **会淋到雨** | 给上半截加个**遮雨檐**：倒扣一次性杯 / 剪开的矿泉水瓶 / 瓦片 / 花盆沿，只挡直淋；**下面留通风口别封死** | ¥0 |
| **长期露天、无遮挡** | 加遮雨檐 + 3P 插针与电阻整段双壁含胶热缩管 + 整束滴水弯；仍建议每半年检查 | 一卷热缩管 |

**别整根埋进土、别泡在水盘/积水里**；插土感应区**绝对不能包热缩管或胶带**（电容测量就靠那段覆铜），要遮只能遮露出地面那截。

#### 这套固件自带一个很大的寿命优势

继电器 `D27` 只在采样时给 `VCC_S` 通电，六路采完立刻断电。`sensors.cpp` 里写得很直白：

> 一轮实际带电约 `500 + 6×3×20 = 860ms`，占 30 分钟周期的 **0.05%**；「带电时间越短，极板电化学腐蚀越慢」。

也就是说探头 **99.95% 的时间是没电的**，即便元件面偶尔返潮、接头轻微受潮，也没有电位差去驱动电解腐蚀 —— 比常供电方案耐用户外得多。

**但防潮仍不能省**：断电状态下湿气不会烧板，却会在下次上电那 860ms 里把 AOUT 拉偏，表现就是读数乱跳或直接 `flt=1`。所以 5.1 的热缩管、孔朝下、留缝排凝露照做。

#### 半年一次的维护（决定能撑几年）

1. **取出擦掉盐碱结晶 / 肥垢**：施过肥、浇过自来水的地方半年会在感应面结一层盐膜，湿布擦净即可，**别用刀刮、别用砂纸**（刮掉阻焊层就变回会腐蚀的裸铜）。
2. **重做干 / 湿点标定**：换土、施肥、雨季、入冬后土壤介电常数都变了，raw 会整体漂几十到几百；在实际安装位置按第十四节第 6 步重新记录并**点保存**。
3. **看 UV 老化**：露出地面那截长期暴晒会发黄变脆，用土、覆盖物或一段胶带遮住露土段即可，别遮到插土感应区。

#### 两个环境边界

- **温度**：多数卖家不标工作温度，按板上芯片商业级估约 `-10~+70℃`。盛夏深色表面暴晒可超 60℃，北方冻土则土壤水结冰、电容读数本身也失去意义 —— 极端天气别拿它的绝对值当真，主要看趋势。
- **雷雨感应**：户外 8 芯干线直连 ESP32 的 ADC 引脚，附近落雷的感应浪涌可能顺着 AOUT 打坏主控。省钱做法：雷雨天**拔掉 USB / 断开 5V**，或干线进屋处套一个磁环；要长期无人值守再考虑在每路 AOUT 对 GND 加钳位二极管（这才会花钱）。

> 一句话：**探头本体放户外没问题，怕水的是上半截元件面和接头**；遮雨檐 + 热缩管 + 半年擦一次，比换「工业级防水探头」划算得多。

### 5.5 100kΩ 到底要几个

**结论：不能共用 1 只，但也不用一次装 6 只 —— 接了几路探头就装几只。第一批只接 CH1 → 1 只就够，剩下 5 只留到扩路时再装。**

#### 为什么不能共用

固件 `USE_MUX = 0`，六路 `AOUT` 各进独立 ADC 脚（`VP / VN / D34 / D35 / D32 / D33`），中间**没有共用节点**。若把 6 路 AOUT 一起接到**同一只** 100kΩ 再下地，等于把六路模拟信号直接短接 —— 六路读数变成同一个值、互相串扰，干湿点标定全废。

**可以共用的是 GND 那一端**（6 只电阻的另一头全上 GND 汇流排），**不能共用的是电阻本身**。

#### 每路为什么都得有

`sensors.cpp` 的故障判定注释写得很直白：

> 100k 泄放电阻保证探头拔掉时读数落到 0 附近，因此 `raw ≈ 0` 能和「干土」区分开（干土 2800~3300）。

`36 / 39 / 34 / 35` 是 input-only 脚，**没有内部下拉**；间歇供电下探头一断电 AOUT 就悬空，会漂到几十~几百，容易被当成正常湿度 → 自动浇水盲目开泵。100k 把它拉到 0，`raw < ADC_OPEN_RAW (400)` → 稳定判 `FLT_OPEN`，调度闸门挡住浇水。附带三个好处：**把源阻抗拉低**抑制长线拾取的工频 / 泵尖峰、给探头内部滤波电容放电（下一轮上电读数不残留）、让拔线能被立刻识别。

#### 数量按进度走

| 阶段 | 装几只 | 说明 |
|---|---|---|
| **第一批：只接 CH1** | **1** | 并在 CH1 探头根部 `AOUT ↔ GND` |
| 扩到 CH1~CH3 | 3 | 每补一路探头，同时补 1 只 |
| 六路全量 | 6 | 每路 1 只，全部并在**远端侧**（探头根部或分线盒 3P 端子） |

**没接探头的那几路不用装**：`sensorsFault()` 对 `!s_ready[ch]` 一律返回 `FLT_OPEN`，`sensorsRecomputePct()` 也把未就绪 / 故障通道的 `pct` 强制 0，空通道本来就稳定报 `flt=1`，不会误开泵。所以第十一节表格里「6 只，不是 1 只」说的是**全量状态**，不是第一批。

#### 能不能先不装

短距离（≤2m）、只做 CH1 验证时**临时不装也能跑通** —— 此前 CH1 就是在 100k 未到货时验出 `raw≈2900 / flt=0` 的。但**别长期不装**：探头拔掉、插头氧化、断电间隙都会让读数飘，长线时更明显。

用户配件已全齐（6 只 100kΩ 已到货），**不用再买**；上一轮说「太贵」的是端子 / 盒子，电阻单价只有几分钱，是整套里最不该省的东西。

**建议顺序**：先装 1 只验第一批 → 位置定死、确认不再挪 → 扩路时逐只补上，别一次性 6 只全焊死（万一布局要改，拆起来麻烦）。

> 装在哪一端、怎么免焊，见 **5.6**。

### 5.6 电阻直接并在探头上（默认推荐，最省事）

**对，而且应该默认这么做** —— 比在分线盒 3P 端子上并更省事，电气上也更好。第十二节、5.3、5.5 说的「探头插头根部」就是这个位置；第十四节第 4 步的「并在分线盒端子位」降级为**备选**。

#### 两种位置对比

| | 并在探头插头根部（**默认**） | 并在分线盒 3P 端子（备选） |
|---|---|---|
| 离信号源 | 最近，探头内部滤波电容有最短放电回路 | 隔了 ≤2m 短线，仍属远端侧，够用 |
| 施工 | 每只探头自己并好，拿到现场直接插线 | 要在 6 个端子孔里各塞「线芯 + 电阻腿」两根，最费工 |
| 端子成本 | 一个孔只压一根线，便宜端子 / 接线子都行（见 5.2、5.3） | 必须一个孔夹两根，得买螺钉式 + E0508 |
| 编号 | 电阻跟着探头走，贴 CH 号不会插错通道 | 电阻固定在端子位，换通道要跟着改线序 |
| 拔线检测 | 见下方「一个诚实的例外」 | 电阻留在盒内侧，拔掉短线仍被拉到 0，最稳 |

**共同前提**：两处都在**远端侧**，都满足「不能并回主控箱」这条硬规矩（第十三节、第十四节第 4 步）。差别只是远端这 2m 短线里的哪一端。

#### 三种做法，按省事程度排

**A. 线上开小口并接头（推荐，不用碰板子、可免焊）**

不剪断 AOUT 与 GND 两根线，在**离探头插头 2~3cm** 处各剥一个 5mm 小口；100kΩ 电阻两条腿分别缠紧 / 焊到两个裸铜口，**两个接点错开约 1cm** 防止相碰；套双壁含胶热缩管整段包住、两端各盖过 1cm。完全没烙铁就用**带硅脂 UY 接线子**把电阻腿与线芯一起压进去（腿先对折成双股，单根太细夹不实），外面再套热缩管。

**B. 焊到探头 3P 插针根部（最紧凑）**

直接焊在 HW-390 板上 `AOUT` / `GND` 两个焊盘 / 插针根部，**以板上丝印为准**。烙铁 300~350℃、快进快出，别连到 VCC、别烫到相邻元件。焊完热缩管只包上半截，**插土感应区绝对不能包**。要焊 6 只时这只比 A 快，但风险稍高。

**C. 塞进 3P 杜邦母头（最省零件）**

电阻腿对折成双股，与 AOUT / GND 线芯一起插进 3P 杜邦母头对应孔压紧，轻拉不脱。不花一分钱，但夹不实会虚接，长期户外不如 A 可靠。

#### 四条不能错

1. **并联，不是串联** —— 千万别把 AOUT 线剪断、把电阻串进去；串 100k 等于给 ADC 加了个分压，六路读数全废。电阻是**跨接**在 `AOUT ↔ GND` 之间。
2. **腿别碰 VCC** —— 3.3V 会把 AOUT 顶到满量程，读成 100% 湿、自动浇水可能乱开。两条腿各先套一小段热缩管，再整体包。
3. **电阻本体贴着插头**（≤3cm），别留两根长腿晃着当天线；长腿那截要用热缩管 / 胶带固定，防反复弯折断脚。
4. **防水照 5.1**：双壁含胶热缩管（3:1、内壁带胶），普通热缩管不防水；接点别落在土面上，沾湿土会直接把 AOUT 拉偏。

#### 一个诚实的例外：拔线检测

电阻并在探头上，意味着它**跟着探头一起被拔走**，主控侧 AOUT 悬空时就没下拉了。但这不会误开泵：`36 / 39 / 34 / 35` 是 input-only 脚、无内部上拉，**实测未接线时 `raw=0 / 65 / 60`、`flt=1`**，远低于 `ADC_OPEN_RAW = 400`，仍稳定判 `FLT_OPEN`。真正会被误判的是「探头还连着、但继电器把 VCC 断了」时 AOUT 经探头内部电路悬在中间电压（几十~几百）—— 而这恰好是电阻并在探头根部最擅长处理的场景。

> **两种情况选备选方案**：① 以后做成**探头短线可插拔**、且要求「拔掉后立刻稳定报 `flt=1`」万无一失；② **按 5.9 做 3P 直插版**（插头必须能干净地插进座子）。这两种都把电阻留在**分线盒内侧** —— 手工版是 3P 端子位，打板版直接贴到板上现成的 `100k 0805` NC 焊位，它不会随探头被拔走。

#### 直插版的例外（配合 5.9）

板上装 6 个 3P 直插座、探头线直接插时，**5.6 的默认做法（做法 A/C：在插头根部 / 3P 杜邦母头里并电阻 + 双壁含胶热缩管）要改掉** —— 电阻本体和热缩管会在插头上鼓一个包，插不进座子、相邻两个座还会互相顶住，散杜邦头更没法固定。两种替代，二选一：

| 做法 | 怎么做 | 代价 |
|---|---|---|
| **贴到板上（打板版推荐）** | 6 只 `100k 0805` 焊到板上每路现成的 NC 焊位，属 5.6 的「盒内侧」备选 | 探头拔掉后主控侧 AOUT 悬空，但上面「诚实的例外」已实测仍稳定判 `FLT_OPEN`；标定值按新位置重做 |
| **焊到探头 PCB（做法 B）** | 焊在 HW-390 板的 `AOUT / GND` 焊盘 / 插针根部，插头保持干净 | 要动烙铁、6 只都焊；电气位置仍是「探头端」，最贴近信号源 |

**两处只能选一处**：板上贴了就别再往探头插头并，同路两只 100k 并联成 50k，虽然 `FLT_OPEN` 判定不受影响，但干湿点标定值要重做。共同前提不变 —— **都属于远端侧，不能并回主控箱**。

#### 断电验收（万用表，30 秒）

| 量什么 | 正常值 | 不正常 |
|---|---|---|
| 探头端 `AOUT ↔ GND` 电阻 | 约 `100kΩ`（并上探头内部电路可能略低，90~100k 都算正常） | 无穷大 = 没接上；接近 0 = 短路或并到 VCC 了 |
| 继电器断开时 `AOUT` 对 `GND` 电压 | 接近 `0V` | 还有 1V 以上 → 断成 GND 了，或电阻接错端 |
| 上电 `/api/state` | 该路 `flt=0`、raw 1000~3000 | `flt=1` 先查上面两项，再查线序、跳线 **H**、`NO` 有无 3V3 |
| 拔掉该路探头 | 立刻 `flt=1`、raw < 400 | 仍显示湿度 → 电阻接错位或读到别的通道 |

> **直插版（电阻贴板上）第一行改量位置**：量的是**板上 3P 座 `3(AOUT) ↔ 2(GND)`** ≈ 100kΩ，此时**探头插头端 `AOUT ↔ GND` 应为开路**（电阻不在探头上了），别误判成"没接上"。

#### 连带省钱

电阻移到探头后，分线盒 3P 端子**每个孔只压一根线**，5.2 里「必须买 TB-1503 螺钉式 + E0508 管形端子」的理由就不成立了 —— `KF301`（约 ¥1/个）、杠杆分线器、甚至 5.3 的接线子 / 压线帽都能用。配合 5.3 省钱版，六路全量还能再省一截。**第一批只做 1 只，做法 A 用现成电阻 + 一小段热缩管即可，¥0 新增采购。**

### 5.7 分线盒这个位置能不能打 PCB

**能，而且比之前问的「主控载板」更合适** —— 这里只是一块**纯无源分线板**（breakout / distribution board）：板上没有芯片、没有电源转换、没有射频，`VCC_S` 仅 `30~120mA / 3.3V`，2 层 1oz 绰绰有余，也没有 ESP32 天线净空、排母中心距那堆约束。`docs/PCB.md` 前十节那份**主控载板**用户 2026-11-12 表示**以后想打**（规划见第十二节），但那是主控箱里的第二块板；这里是**另一块完全不同、先做的小板**，别混为一谈。

#### 它替代的是什么

第十四节物料表里的「8P 进线端子（盒端） + 2 条汇流排 + 6 个 3P 探头端子 + 盒内跳线 + 号码管」。手工版要在盒里接约 **18 根跳线**（VCC_S 6 根、GND 6 根、AOUT 6 根），最容易错的就是线序；打板后这些全走铜皮，**盒内跳线为 0**。端子版把 8 根干线 + 18 根探头短线压进 26 个螺丝孔；**RJ45 版（5.8）只需压 18 根探头短线，干线插上就好**；**再加 5.9 的 3P 直插座，这 18 根也省掉，整盒 0 接线、探头直插**。线色和 CH 号直接印在丝印上。

#### 值不值（按 2026-11 已查报价算）

| 方案 | 一次性成本 | 得到什么 |
|---|---|---|
| 5.3 极限省钱版 | **¥9~25** | 焊死 / 压线帽，最便宜，但不能改线 |
| **打板（有免费券）** | **约 ¥10~15** | 板 ¥0 且包邮，只需买 `KF301-3P ×6` + 进线座 ×1（`KF301-8P` 或 RJ45 座，见 **5.8**）；**每路可插拔、丝印防接错、盒子能做小** |
| **打板 + RJ45 + 3P 直插（有券）** | **约 ¥10~20** | 板 ¥0 包邮 + 2 种座子 ¥2~5（+ 延长线按需 ¥6~12）；**整盒 0 接线、探头直插**，见 5.8 / 5.9 |
| 打板（无券） | 约 ¥35~50 | 板 ¥20 + 端子 ¥8~15 + 运费 ¥8~15，买的是省工 |
| 5.2 舒适版 | ¥60~110 | 同样可插拔，但要手工接 18 根盒内跳线 |

> **关键结论：手里有免费打样券时，打板反而比 5.3 省钱版还划算** —— 只多几块钱，就从「焊死不能改」升级成「可插拔 + 线序丝印」。之前说「打板不划算」指的是主控载板（元件 ¥27~49、要贴 MOS 和电解、还有天线净空），这块无源板除了端子几乎没有元件。没券就纯属买省工，不是省钱。板子规格与免费券条件见 `docs/PCB.md` 第十节、第十一节。

#### 板上画什么

| 项 | 建议 |
|---|---|
| 板 | 2 层 FR-4 / 1.6mm / 1oz / 绿油白字 / 有铅喷锡，**70×50mm**（10×10cm 内，免费券覆盖），4 个 M3 安装孔 |
| 进线 | **推荐 1× RJ45 `8P8C` 母座（无变压器、无灯）**，旁边印 T568B **`pin 号 + 线色`**（注意 `pin4/5/6 = 蓝 / 蓝白 / 绿`）；也可与 `KF301-8P` 画成二选一并联焊位。**丝印防接错是打板最大的价值**，详见 **5.8** 与 `docs/PCB.md` 第十一节 |
| 出线 | **推荐 6× 3P 直插座（探头免接线直插，见 5.9）**，或 `KF301-3P`，两者画成二选一并联焊位；每个印 `CH1…CH6` / `VCC / GND / AOUT` / **缺口方向三角标记**，6 个方向必须一致 |
| 汇流 | `VCC_S`、`GND` 各一条 **2mm 宽铜皮 / 铺铜**，1 进 6 出；**别把 VCC 铺满整板**，会在 AOUT 走线下方形成分布电容耦合 |
| AOUT 走线 | 6 条模拟线间距 **≥2×线宽**、短直、不平行长距离紧贴；两侧可走 GND 保护线。板上只有几 cm，干扰影响很小 |
| 100kΩ 焊位 | 每路留 1 个 `0805` 焊位：**端子版默认不装（NC）**（按 5.6 并在探头插头根部）；**直插版推荐贴 6 只 100k 0805**（5.6 的盒内侧备选），探头端保持干净才插得进座子 |
| 100nF 焊位 | 每路与 100k 并联留 1 个 0603 焊位，**仅 10~30m 装** |
| 测试点 | `VCC_S` / `GND` 各 1 个，方便断电用通断档验母线 |

网表（20 条网络，比主控载板的 66 条简单得多）见 `docs/PCB.md` 第十一节。

#### 三个坑

1. **别做成「有源」板**：不加 LDO、不加电平转换、不加 MCU，AOUT 直连。多一个元件就多一个故障点，也失去免费打样的意义。
2. **默认不贴 100kΩ**：焊位留着但不装，否则和 5.6 冲突 —— 同一路两处各一只 100k 并联会变成 50k，虽不影响 `FLT_OPEN` 判定，但干湿点标定值要重做。板上若装了，就明确选 5.6 的「盒内侧」备选方案，**探头端不要再并**。
3. **PCB 本身不防水**：凝露会让 `VCC_S` 与相邻 AOUT 之间漏电。照样按 5.1 装进倒扣盒 / 孔朝下；讲究点刷一层三防漆（丙烯酸或聚氨酯，**别刷到端子接触面**）。打板的好处是体积从 150×100×60 缩到约 90×60×30，防水反而更好做。

#### 什么时候打

**现在别打。** 第一批只有 CH1，一根杜邦线 + 1 只 100k 就够（5.3 A 档，¥0）。按老顺序：先 ¥0 验 CH1 → 六路位置定死、确认不再挪、且确认探头距离 ≤10m → 再画这块板一次性装死。打板要画板 + 等 2~4 天，提前画了八成要改丝印或线序。

> 真要打，立创 EDA / KiCad 都能画，纯连线、几乎不依赖元件库。先出板框尺寸与网表 → DRC 通过 → Gerber 查看器检查 → **最后再领免费券**（券有有效期，别领了慢慢画）。

### 5.8 进线改 RJ45 水晶头对接（打板时一起做）

**能，而且建议就这么做。** 把 `KF301-8P` 换成板上一只普通 `8P8C` RJ45 母座，干线两端压水晶头，一头插主控箱的转接板、一头插分线板，整条干线变成「一根成品网线，插上就好」。

**为什么比端子好**：网线单芯 24AWG ≈ 0.2mm²，`KF301` / `TB-1508` 螺钉端子压不紧（5.2 记过这个坑），虚接几个月后读数就飘；水晶头压接本来就是给这号线设计的，8 芯一次压完、接触电阻小、不松，还省掉盒端 8P 端子和一盒 `E0508` 管形端子。**代价几乎为零**：RJ45 座比 8P 端子还便宜，有免费券打板总额仍约 ¥10~15。

#### 可下单清单

| 件 | 搜词 | 数量 | 参考价 |
|---|---|---|---|
| RJ45 母座 | `8P8C RJ45 母座 直插 180度 无灯 无变压器` / `网线插座 PCB 立式 8P8C` | 1（多买 2 备） | ¥0.5~2 / 个 |
| 水晶头 | `超五类 8P8C 水晶头 镀金 非屏蔽` | 1 包（20 个够用） | ¥2~5 |
| 压线钳 | `网线压线钳 8P8C 最简单款` | 1 | ¥15~25（可借） |
| 主控端转接板 | `RJ45 母座转 8P 螺丝端子板` / `网线转接板 RJ45 to terminal` | 1 | ¥3~8 |
| 室外网线（可选） | `室外超五类 非屏蔽 PE 护套 抗UV` | 实际距离 + 2m | ¥1~2 / m |

> **致命坑**：绝对别买 `HR911105A` / `带网络变压器` / `带 LED 指示灯` / `以太网网口模块` 这类集成隔离变压器的网口 —— 内部 1:1 变压器把直流全隔断，3.3V 探头供电和 0~3V `AOUT` 一路都过不去，板子直接不通。要的是**最普通的 8 触点直通母座**，只认「无变压器 / 无灯」，型号各家不同别照抄。也别把 `RJ45 母对母直通头`（转接件）当 PCB 焊接座。

#### 压线施工卡

1. **两端都按 T568B，做直通线，不做交叉线**。弹片朝下、金属触点朝自己，从左到右：`1 橙白 / 2 橙 / 3 绿白 / 4 蓝 / 5 蓝白 / 6 绿 / 7 棕白 / 8 棕`。两端线序**逐根对照第 3 步表**，别凭记忆。
2. 外皮剥约 20mm、只解绞到能排线为止（解绞越长串扰越大），芯线捋直剪齐留 12~14mm，插到底从水晶头正面能看到 8 个铜芯顶到头，外皮要被卡扣压住，再压实。
3. **主控端**：水晶头插 `RJ45→8P 端子板`，按第 3 步表把 橙白→`VP`、橙→`VN`、绿白→`D34`、绿→`D35`、蓝白→`D32`、蓝→`D33`、棕白→继电器 `NO`、棕→ESP32 `GND`。端子板是螺钉式的，细芯**套 `E0508` 管形端子或对折双股**再压，别上锡。
4. **分线盒端**：直接插板上的 RJ45 座，盒内 0 根跳线、0 条汇流排；6 根 ≤2m 三芯短线只压进 6 个 3P 端子，`100kΩ` 仍按 **5.6** 并在探头插头根部（板上焊位保持 NC）。
5. **第一批只有 CH1**：干线 8 芯照样全压满，主控端只接 橙白 / 棕白 / 棕 3 根，其余贴标签留空；板上只装 CH1 的 3P 端子，CH2~CH6 `flt=1` 正常。扩路时直接补接，不用重压线。

#### 边界（这几条不能破）

- **这个口只过探头供电与 6 路高阻 AOUT**：`VCC_S` 最大约 120mA / 3.3V（6 只 ×20mA），余量充足；**泵 5V / 数 A 绝不能走 RJ45**，电源与两块 YYNMOS-4 全留主控箱。
- **RJ45 不防水**：仍按 5.1 装倒扣盒、插口朝下、开孔只在底面；插好后接头外套带胶热缩管或自粘胶带缠住（别烘到塑料座变形）。潮湿处选镀金触点；户外段用 PE 护套室外型网线，室内线露天一两年外皮粉化。
- **距离上限不变**：换接头不改线径和 4 对双绞，仍按 **≤10m** 默认；10~30m 照第 7 步换两根屏蔽网线并装板上 `100nF`；>30m 按第十三节搬主控。**水晶头不会把 10m 变成 100m**（那是数字以太网的口径，这里是模拟 AOUT）。
- 用 STP 屏蔽线 + 金属壳座时，屏蔽层**只在主控端接 ESP32 GND**，分线盒端剪断包绝缘；UTP 非屏蔽最省事。插拔寿命有限，装好后别反复拔，改线在主控端端子板做。

#### 上电前验收（30 秒）

断电，插一根两端压好的短网线，从水晶头触点量到板上 3P 端子：`pin7→6 个 VCC` 全通、`pin8→6 个 GND` 全通、`pin1→J1.3`、`pin2→J2.3`、`pin3→J3.3`、**`pin6(绿)→J4.3`、`pin5(蓝白)→J5.3`、`pin4(蓝)→J6.3`**、任意两路 AOUT 不导通。这一量同时验出「母座焊盘编号是否等于触点编号」—— 不同厂家会反序，**画板前先实测、别照抄型号图纸**。具体网表与二选一焊位见 `docs/PCB.md` 第十一节。

> **不想打板也能用**：买两块 `RJ45→8P 端子板`（主控端 + 分线盒端各一，约 ¥6~16），分线盒端再配 SPL/PCT 杠杆分线器 ×2 + 3P 端子 ×6，一样是水晶头对接，只是盒内仍有跳线。打板买的是「0 跳线 + 丝印防接错」。

### 5.9 出线改 3P 直插座：探头免接线直插

**对，这才是打板的最终形态**：进线 RJ45 水晶头（5.8）+ 出线 6 个 3P 直插座，分线盒里 **0 根跳线、0 根短线、0 个螺丝孔**，探头线插上就完事，连「压 18 根三芯线」都省了。板框、网表、20 条网络、`100k/100nF` 焊位全不变，只是把 `KF301-3P` 的封装换成 3P 座。

#### 第一个坑：方向别买反

HW-390 是**板上一个 PH2.0-3P 白色座 + 一根转接线**，转接线末端是**三个独立的 2.54mm 杜邦母头**（第十二节「端子形状不匹配」已记）。**母头要插的是公针**，所以板上焊的严格说是 **3P 公座 / 直排针**；口语说「3P 母座」如果指"座子"没问题，**真买成带孔的 3P 母座就会母对母插不上**。

| 探头线末端实物 | 板上该焊 | 搜词 |
|---|---|---|
| 三个散的 2.54 杜邦母头（**当前这套**） | `3×1 2.54 直排针`（最省）或 `XH2.54-3P 直针座 带扣`（防呆，推荐） | `XH2.54-3P 直针座 带扣` |
| 一体 PH2.0 白色 3P 公插头 | `PH2.0-3P 直针座` | `PH2.0-3P 直针座 立贴/卧贴` |

> **下单前拿卡尺量插头相邻两针中心距**：`2.0mm → PH2.0`，`2.54mm → 杜邦 / XH2.54`，买错完全插不进。**XH2.54 与杜邦胶壳的卡扣互不通用**，要买就买配套的座 + 胶壳。想彻底防呆：把三个散杜邦母头压进一只 `3P 2.54 杜邦母胶壳`（¥0.1），板上焊带扣 3P 直针座，插反插不进去。

#### 第二个坑：探头线只有 20~30cm

原设计「分线盒放 6 只探头几何中心、每根 ≤2m 短线」的前提是能自己剪线；**直插就等于要求 6 只探头都挤在板子 30cm 内**。两条出路，别为了迁就短线把板子挪离几何中心（那样 6 根模拟线又变长了）：

1. 花盆往板子边靠，让 6 只都在原装线长度内；
2. 买成品 **3P 2.54 公对母延长线 1~2m**（¥1~2/根，6 根 ¥6~12；PH2.0 版买 `PH2.0-3P 延长线`），**仍是直插、免压线**，分线盒照样放几何中心。

#### 第三个坑：100kΩ 位置要跟着改

5.6 默认的「在插头根部并电阻 + 双壁含胶热缩管」会让插头鼓包，**插不进 3P 座、相邻座还互相顶**。直插版按 5.6「直插版的例外」二选一：**打板版推荐把 6 只 `100k 0805` 贴到板上现成的 NC 焊位**（盒内侧备选），或焊到探头 PCB 的 `AOUT/GND` 焊盘（做法 B）。**两处只选一处**，同路两只并联成 50k 会让干湿点标定值要重做。板上贴的代价按 5.6 实测：拔掉探头后仍稳定判 `FLT_OPEN`（`raw=0/65/60 < 400`），不会误开泵。

#### 可下单清单（有券打板总额仍约 ¥10~20）

| 件 | 数量 | 参考价 |
|---|---|---|
| `XH2.54-3P 直针座 带扣`（或 `3×1 2.54 排针`） | 6（多买 2 备） | ¥0.2~0.5/个 |
| `3P 2.54 杜邦母胶壳 + 端子`（把散头做成一体插头） | 6 套 | ¥0.1~0.3/套 |
| `3P 2.54 公对母延长线 1~2m`（按实际距离，可选） | 6 | ¥1~2/根 |
| `100kΩ 0805` 贴片（板上贴的话） | 6 | ¥0.01/只 |
| 省掉 | `KF301-3P`×6、18 根三芯短线、`E0508` 管形端子、压线工时 | ≈ ¥6 + 工时 |

#### 施工卡

1. **画板**：6 个 3P 座与 `KF301-3P` 画成同一组网络的**二选一并联焊位**；每个座旁印 `CH1…CH6`、`VCC / GND / AOUT` 和**缺口方向三角标记**，6 个方向必须一致。`XH2.54-3P` 带扣座宽约 9~10mm，并排 6 个按 ≥11mm 中心距要 66mm —— **板框建议从 70×50 放宽到 80×50mm**（仍在 10×10cm 免费打样内），或排成 2 排各 3 个；`PH2.0` 座窄约 6.5mm，70mm 够。
2. **装盒**：座子选直针（垂直插）还是卧式（贴板边水平插）看盒子；板平放、座朝上最好插但最容易积水，**建议板竖装 / 斜装、插口朝侧面或略朝下**，与 5.1「孔朝下 + 倒扣盒」一致。
3. **固定线**：探头线被拉扯时力**直接传到 PCB 焊盘**，比螺丝端子脆弱。每个座旁留一个 Ø3 扎带孔 / 线卡位，插好后把探头线束扎在板上，或点一点热熔胶在胶壳上（别糊住触点、别用酸性硅胶）。座子选带扣款。
4. **100kΩ**：按上面第三坑贴板或焊探头 PCB，插头上保持干净；板面刷三防漆时**避开座内触点与插合面**。PH2.0 / 杜邦 / XH 座都不防水，且不能像螺丝端子那样整束灌胶 —— 真正管用的还是 5.1 的「换位置不淋雨」，盒内放干燥剂防凝露漏电。
5. **第一批只接 CH1**：只焊 1 个座、只插 1 只探头，其余 5 个座空着（或全焊好但不插），空通道 `flt=1` 正常。验通再逐路补，别一次插满。

#### 通电前 30 秒验收

断电通断档：RJ45 `pin7` ↔ 6 个座 `1(VCC)` 全通、`pin8` ↔ `2(GND)` 全通、**每个座 `1/2/3` 两两不短**、任意两路 `3(AOUT)` 不导通；板上贴了 100k 时每路 `3 ↔ 2` 约 100kΩ。然后只插 CH1，上电应 `flt=0 / raw 1000~3000`、其余 `flt=1`。**若 CH1 `raw` 顶满 4095 或 `flt=1`，立刻断电查插头插反** —— 3.3V 打到 AOUT 会读成满湿度，可能乱开泵。散杜邦头没有防呆，第一次插之前按座上丝印用万用表逐根对一遍。

> 完整网表与板上布局见 `docs/PCB.md` 第十一节「出线改 3P 直插座」。**固件全程不用改、不用重烧**：`CHANNEL_COUNT=6`、六路 ADC 引脚、采样时序、故障判定都是现成的，这只换连接器。

### 6. 上电验收（配合第十二节分批施工）

1. 断电，先只把 CH1 探头接到 3P-1，其余 5 个端子空着。
2. 上电读 `/api/state`：**CH1 `flt=0` / raw 1000~3000**，CH2~CH6 `flt=1`。CH1 若 `flt=1`：断电先量探头端 `AOUT ↔ GND` 是否约 100kΩ（见 5.6），再查橙白线两端线序（RJ45 版按 **5.8** 用通断档逐脚量）、继电器跳线是否 **H**、`NO` 有没有 3V3；**3P 直插版还要查插头有没有插反**（`raw` 顶满 4095 基本就是 3.3V 打到 AOUT，见 5.9）。
3. 逐路补 CH2~CH6，**每补一路读一次** `/api/state`，新路 `flt=0`、其余保持原状；某路 `raw=0` 基本就是 AOUT 线序错位或该路 3P 端子 VCC 没取到电。
4. 6 路齐了，**在实际安装位置重做干 / 湿点标定**：分别记录每路干燥与浸水后的 raw（长线会整体漂几十到几百，出厂 2800 / 1150 不能照抄），写进对应通道设置并**点保存**。
5. 点「浇 15s」，看其他 5 路 raw 不跳；跳就是干线与泵线贴太近，或 GND 汇流排接触不良。
6. 观察一个采样周期（默认 30 分钟）确认读数稳定、不再反复报 `flt=1`。

### 7. 10~30m 怎么升级

一根 8 芯不够 —— 4 对双绞容不下 6 路 AOUT 各配回流线。改**两根屏蔽网线（16 芯 / 8 对）**。换成 RJ45 水晶头（5.8）只是接头形式变了、线径与 4 对双绞没变，**以下升级照旧适用，水晶头不会延长距离上限**：

| 双绞对 | 用途 |
|---|---|
| 1~6 | 每对走 `AOUTn + GNDn`（专属回流线，同对双绞） |
| 7 | `VCC_S` 两芯并联，降线阻 |
| 8 | GND 汇总 / 备用 |

屏蔽层**只在主控端**接 GND；分线盒端每路 `AOUT↔GND` 再并 1 只 `100nF`（与 100kΩ 并联，τ=10ms，`SENSOR_SETTLE_MS=500ms` 有 50 倍余量）。装完必须重标定。**>30m 别拉模拟线**，按第十三节把主控搬到探头中心。

**固件全程不用改、不用重烧**：`CHANNEL_COUNT = 6`、六路 ADC 引脚、采样时序、故障判定都是现成的，这只是布线。
