huangzhu0423/esp32-waterer/esp32_waterer/web_ui.h

#pragma once
/* 本文件由 tools/build_web.py 自动生成，不要手工修改。
   源文件: web/index.html
   原始长度: 43643 字节
   gzip 长度: 13717 字节
   源文件 sha256: 76cdc3ff5166160c6712b9c8e8a5bb384a5d240f72952338bed4113c5235173b
*/
#include <stdint.h>
#include <pgmspace.h>

#define WEB_UI_GZ_LEN 13717

const uint8_t WEB_UI_GZ[WEB_UI_GZ_LEN] PROGMEM = {
  0x1f,0x8b,0x08,0x00,0x00,0x00,0x00,0x00,0x02,0xff,0xcd,0x7d,0x69,0x77,0x1b,0xc7,
  0xb1,0xe8,0x77,0xfd,0x8a,0x11,0x1d,0x67,0x00,0x13,0x00,0x01,0x70,0x11,0x05,0x12,
  0xd4,0x71,0x24,0x27,0xf6,0x8b,0x17,0xbd,0x48,0x49,0xee,0x3d,0xbe,0x7a,0x3e,0x03,
  0x60,0x40,0x4c,0x88,0x4d,0x33,0x03,0x92,0x0a,0xc5,0x77,0xe8,0x45,0x9b,0x25,0x8a,
  0xb2,0x2c,0x59,0xb2,0x45,0x59,0x4b,0x2c,0x4b,0xb1,0xa3,0xc5,0xab,0x76,0xf3,0x9c,
  0xfb,0x53,0x12,0x0e,0x48,0x7e,0xca,0x5f,0xb8,0x55,0xd5,0xdd,0x33,0xdd,0x83,0x01,
  0x48,0xc9,0xc9,0x3b,0x8f,0xb6,0x48,0xa0,0xa7,0xbb,0xba,0xba,0xba,0xb6,0xae,0xae,
  0xee,0x19,0xdf,0xbe,0xe7,0xad,0xdd,0xfb,0xff,0x73,0xef,0x2b,0x5a,0xc5,0xad,0x55,
  0x27,0xc6,0xf1,0xb7,0x56,0x35,0xea,0x93,0xf9,0xbe,0x3f,0x57,0x92,0xbb,0xdf,0xec,
  0x83,0x22,0xd3,0x28,0x4d,0x8c,0xd7,0x4c,0xd7,0xd0,0x8a,0x15,0xc3,0x76,0x4c,0x37,
  0xdf,0xd7,0x72,0xcb,0xc9,0xd1,0x3e,0x5e,0x5a,0x37,0x6a,0x66,0xbe,0x6f,0xda,0x32,
  0x67,0x9a,0x0d,0xdb,0xed,0xd3,0x8a,0x8d,0xba,0x6b,0xd6,0xa1,0xd6,0x8c,0x55,0x72,
  0x2b,0xf9,0x92,0x39,0x6d,0x15,0xcd,0x24,0x7d,0x49,0x58,0x75,0xcb,0xb5,0x8c,0x6a,
  0xd2,0x29,0x1a,0x55,0x33,0x9f,0x49,0x88,0x56,0xc9,0xb2,0xe5,0xe6,0x8b,0x8d,0x69,
  0xd3,0x56,0xa1,0xba,0x15,0xb3,0x66,0x26,0x8b,0x8d,0x6a,0xc3,0x96,0x00,0xbf,0x50,
  0x1e,0x2a,0x8f,0x94,0x0d,0xa8,0xea,0x5a,0x6e,0xd5,0x9c,0x58,0x3f,0xf6,0x95,0xf7,
  0xe1,0xad,0xf6,0x0f,0xc7,0xda,0xf7,0xbe,0x1f,0x1f,0x60,0x65,0xe3,0x8e,0x7b,0x08,
  0xfe,0x6c,0x7b,0x69,0xae,0xd0,0x98,0x4d,0x3a,0xd6,0x9f,0xad,0xfa,0x64,0xae,0xd0,
  0xb0,0x4b,0xa6,0x9d,0x84,0x92,0xb1,0xe4,0x8c,0x59,0x98,0xb2,0xdc,0xa4,0x6b,0x34,
  0x93,0x15,0x6b,0xb2,0x52,0x85,0x7f,0x2e,0xeb,0x29,0xe7,0xda,0x46,0xdd,0x69,0x1a,
  0x36,0x74,0x36,0xbf,0x0d,0x49,0x92,0x28,0x34,0x4a,0x87,0xe6,0x6a,0x86,0x3d,0x69,
  0xd5,0x73,0xe9,0xb1,0xa6,0x51,0x2a,0x21,0xb8,0xf4,0xfc,0x36,0x7a,0x50,0x30,0x8a,
  0x53,0x93,0x76,0xa3,0x55,0x2f,0xe5,0x38,0x6a,0x63,0x0c,0xd0,0x0b,0x99,0x91,0x6c,
  0x3a,0x6b,0x8e,0x95,0x01,0xf3,0x5c,0x66,0xb8,0x39,0x3b,0x90,0x49,0x0d,0x0d,0x6b,
  0xce,0x21,0xc7,0x35,0x6b,0xc9,0x96,0x95,0x48,0x1a,0xcd,0x66,0xd5,0x4c,0xb2,0x82,
  0x44,0xdf,0x3e,0x73,0xb2,0x61,0x6a,0xbf,0x7f,0xad,0x2f,0xd1,0xf7,0x86,0x55,0xb4,
  0x1b,0x4e,0xa3,0xec,0x6a,0xff,0x69,0xbc,0x6a,0x5a,0x7d,0x09,0x07,0x70,0x4a,0x3a,
  0xa6,0x6d,0x95,0x45,0xff,0x30,0x0e,0xd7,0x6d,0xd4,0x72,0xd9,0xd1,0xe6,0xec,0xfc,
  0xb6,0xd4,0x8c,0x6d,0x34,0x01,0xc7,0x59,0x46,0xea,0xdc,0x70,0x36,0xdd,0x9c,0x1d,
  0x13,0x38,0x6b,0x46,0xcb,0x6d,0xf8,0x88,0x67,0x46,0x9a,0xb3,0x5a,0x66,0x08,0x7e,
  0xc1,0x10,0xb6,0x0d,0xbc,0xa4,0x6d,0x5c,0xfb,0x71,0xe3,0xfd,0x5b,0xda,0x4b,0x03,
  0xdb,0x52,0x95,0xd2,0x5c,0xc9,0x72,0x9a,0x55,0xe3,0x50,0xae,0x5c,0x35,0x67,0xc7,
  0x0c,0xa0,0x4c,0x3d,0x69,0x01,0x7e,0x4e,0xae,0x08,0x14,0x31,0xed,0xb1,0x3f,0xb5,
  0x1c,0xd7,0x2a,0x1f,0x4a,0xf2,0x09,0xc9,0x01,0xad,0x60,0x86,0x0b,0xa6,0x3b,0x63,
  0x9a,0xf5,0xb1,0x49,0xa3,0x99,0xcb,0xa4,0x09,0xa5,0x4a,0x49,0xab,0x64,0xe6,0x70,
  0xf4,0x38,0x03,0x66,0x2e,0xb3,0x13,0x50,0xa2,0xaf,0x33,0x26,0xd2,0x3b,0x37,0x32,
  0x9c,0x1e,0xab,0x9a,0x2e,0x00,0x4d,0x22,0x10,0xc4,0x2d,0x35,0x28,0xa1,0x0d,0x30,
  0x9a,0x56,0xb5,0xea,0x63,0x64,0xd5,0xab,0x56,0xdd,0x4c,0x76,0x43,0x0c,0xbb,0x1e,
  0x11,0x5d,0xb0,0x1e,0x33,0xf0,0x55,0x0c,0x7b,0x18,0x47,0x8d,0x54,0xe1,0x7c,0x60,
  0x1b,0x25,0xab,0xe5,0xe4,0x76,0x22,0x56,0xf2,0x1c,0x9a,0xa3,0xe5,0x74,0xb9,0x2c,
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
};
