huangzhu0423/esp32-waterer/(commit log)

2026-11-07 基线：v1.0.1 六路自动浇水固件
    - 六路电容式土壤湿度采集（ADC1）+ 互斥水泵调度
    - 断线/短路硬锁：OPEN/SHORT 含手动一律拒绝开泵
    - pumpStart 最终闸门 + 队列退回防死循环
    - AP 密码 62517729，独立 NVS key，可在设置页修改
    - gzip 压缩内嵌前端 + 静态检查门禁
    [build_web.py, check_firmware.py, config.h, config_store.cpp, config_store.h, esp32_waterer.ino, health.cpp]
2026-11-07 采样式供电：探头每 30 分钟上电一次，采完立刻断电
    - 新增 PIN_SENSOR_PWR(27) 驱动 P-MOS 高边开关
    - sensors 改为 IDLE/SETTLE/READING 状态机，一轮带电约 860ms
    - 断线/短路判定提到跳变过滤之前，避免间歇供电下故障延迟数小时
    - FAULT_CONFIRM_COUNT 5->3，使故障能在同一轮内确认
    - 停泵后自动补采一轮（60 秒节流），避免拿旧读数连浇
    - 标定自行上电并共享稳定时间，避免读到断电后的 0
    - sensorsForceSample 改为请求补采，不再立即读
    - /api/state 增加 samp/next 字段，页面显示下次采集倒计时
2026-11-07 探头供电开关改为可配极性，适配继电器模块
    - 新增 SENSOR_PWR_ACTIVE_LOW，与 PUMP_ACTIVE_LOW 同一思路
    - 默认 0（高电平吸合），对应继电器模块 High 跳线
    - config.h 注释以继电器方案为主，P-MOS 作为备选
    - docs/WIRING.md 新增第八节：探头供电继电器接线与验证
2026-11-07 修正继电器线圈电压：JQC-3FF-S-Z 为 3.3VDC 版，VCC 接 3V3 而非 5V
    - config.h 与 WIRING.md 均改为 3V3
    - 补充 73mA 吸合电流与浪涌缓冲电容建议
    [config.h]
2026-11-07 新增探头供电检测：六路同时无读数判供电故障，而非六个探头损坏
    - types.h 新增 FLT_PWR 与 LOG_PWR_FAIL/LOG_PWR_OK
    - SETTLE 结束后先做通电确认，六路全贴地则直接收工、置全局故障
    - 避免继电器未吸合时误报六个独立断线，把真正原因埋掉
    - 页面按 flt==5 显示「供电」/「探头无供电」
2026-11-07 按实际配置重写供电章节：6 个 3.3VDC 继电器需独立降压
    - 第三节改为供电总图，列出五类负载的电压/电流/供给方
    - 说明为何 6 路线圈不能直接挂 ESP32 3V3：稳态够但上电窗口有 438mA 风险
    - 适配器由 5V/2A 提升到 5V/3A（水泵启动峰值 1.5A）
    - 补充三处电容的安装位置
    - 第六节故障对照新增「上电反复重启」「六路同时无供电」两条
2026-11-07 供电章节按 5V/5A 适配器更新
    - 接线图与说明改为 5V/5A
    - 新增「5A 怎么分配」：线径 AWG18 以上、禁用面包板分配主电、泵线与探头线分开走
    - 说明 5A 余量是留给单泵卡转的，不放开多路并发浇水
    - 第七节故障表「反复重启」补上 3.3V 浪涌这一主因
2026-11-07 供电方案改为主推直连 ESP32 3V3，降压模块降为备选
    - 第三节补充电流账：稳态 426mA vs USB 转出约 640mA，余量 200mA
    - 明确唯一风险点在上电 200~300ms 高阻窗口，靠下拉电阻 + 大电容排除
    - 接线树、电容表、DC+ 说明同步改为直连
    - 故障对照给出「先补电容→再补下拉→仍复发才上降压」的递进顺序
2026-11-07 为 32 路与 pH 扩展预留接口
    - pump 输出层抽成 pumpHwApply(mask)，用位掩码而非逐路开关，
    将来 MCP23017 的读改写整寄存器可直接映射；新增 USE_IO_EXPANDER 开关
    - ChannelCfg 新增 type 字段区分湿度/pH，CFG_VERSION 升到 2
    - /api/state 输出 type，JSON 缓冲 1200->2048
    - 修复 config.h 中 MUX 预留块被误覆盖、USE_MUX 定义丢失
    [config.h, config_store.cpp, pump.cpp, types.h, web_server.cpp]
2026-11-07 探头供电补充分组方案：32 路按 8 路一组分开供
    - 说明单个继电器带满载时的容性冲击与触点粘连风险
    - 给出 4 组的分组表与 GPIO 分配（27/16/17/21）
    - 标注固件扩展时的改动点（PIN_SENSOR_PWR 改数组）
    - 保留单组满带的 NTC 限流兜底方案
2026-11-07 通道支持备注名称，用于记录每路种的是什么
    - ChannelCfg 新增 name[24]（UTF-8 约 7 个汉字），CFG_VERSION 升到 3
    - /api/channel 支持写入 name，按字符边界截断，避免把汉字切成两半
    - /api/state 输出 name 字段
    - 首页卡片显示「序号 + 名称」，过长省略；设置面板新增名称输入框
    - 预览数据补上六种植物名，无硬件时也能看到名称效果
2026-11-07 采样周期改为网页可调
    - 周期存 NVS 独立键 cycle，不动 ConfigBlob，避免又一次配置重置
    - 边界 5~360 分钟，越界或读到非法值时回落 30 分钟默认
    - 新增 GET/POST /api/cycle
    - 设置页新增采样周期下拉（15 分钟~4 小时）
2026-11-07 新增 MQTT 远程控制链路
    - 新模块 mqtt_link.*：非阻塞连接状态机 + 命令订阅 + 状态遥测 + LWT 在线/离线
    - 配置走独立 NVS 命名空间 mqtt，不碰 ConfigBlob，改 MQTT 不重置主配置
    - 指令必须带正确令牌（token）才执行，否则忽略——这是暴露到公共 broker 前的必需防线
    - 命令支持 start/stop/auto；状态每 30s 或变更时上报 aw_XXXX/state
    - 抽取 jsonutil.h 供 web_server 与 mqtt_link 共用 JSON 取值
    - 新增 /api/mqtt 读写接口；设置页加「远程 MQTT」面板（含巴法云一键预设）
    - 固件版本升至 1.1.0
    验证：build_web + check_firmware 通过；arduino-cli 编译通过（77% flash /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
    [config.h, esp32_waterer.ino, jsonutil.h, logbuf.cpp, mqtt_link.cpp, mqtt_link.h, types.h, web_server.cpp]
2026-11-07 新增手机网页远程仪表盘 web/remote.html
    - 单文件、手机浏览器打开即用，mqtt.js 走 WebSocket 连 broker
    - 订阅 aw_XXXX/state 显示 6 路湿度环 + 故障/自动状态，下发 aw_XXXX/cmd 浇水/停止/开关自动
    - broker 地址/账号/令牌/设备ID/浇水时长存 localStorage，下次自动连
    - 与设备 MQTT 链路共用同一主题，设备端零改动
2026-11-07 新增 GitHub Pages 版远程仪表盘（docs/remote）
    - index.html 由 web/remote.html 注入 PWA 标签生成，MQTT 逻辑完全一致
    - manifest.webmanifest + 图标（icon-192/512、apple-touch-icon），支持「加到主屏幕」当 App
    - 纯静态、无密钥：broker/令牌由用户浏览器本地填写并存 localStorage
2026-11-07 远程仪表盘内联 mqtt.js 消灭国外 CDN，默认 broker 改国内巴法云
    - web/remote.html 与 docs/remote 部署版均内联 mqtt.min.js(~340KB)，不再依赖 unpkg
    - 默认 broker 改为 wss://bemfa.com:8444/mqtt（国内可达），EMQX 公共服仅作备选说明
    - 解决国内打开 GitHub Pages 时因国外 CDN 拉不到 mqtt.js 导致页面空白的问题
2026-11-07 新增远程仪表盘启动器 serve_remote.cmd（静态服务+cloudflared 隧道，桌面机双击运行）
2026-11-07 删除未使用的 cloudflared 启动器（已改用 GitHub Pages 托管）
2026-11-07 仪表盘名称改为「大黄智能浇水系统」（标题/页头/short_name/PWA title）
2026-11-07 修复巴法云路由：设备/仪表盘 MQTT clientId 改用 uid（user 字段）；仪表盘 devid 转大写
    [mqtt_link.cpp]
2026-11-07 fix(remote): 巴法云 WSS 用官方 9504/wss（8444/mqtt 不存在导致 connack timeout），自动纠正旧缓存地址，放宽连接超时，主题前缀只大写后四位以匹配固件 aw_%04X
2026-11-07 fix(mqtt): 巴法云兼容改造 - 9504/wss 端点、扁平主题(awAF48state/avail/ctrl)、自动纠正旧地址、clientId=uid
    [mqtt_link.cpp]
2026-11-07 feat(remote): 远程页对齐局域网四页功能，配置一次保存后自动连接
    - 远程页改为 通道/定时/日志/设置 四页，通道详情、标定、定时任务、日志、采样周期、重启均可远程操作
    - 配置预填并持久化、打开即连、高级设置折叠、一键配置链接导入；旧 8444 地址自动纠正，丢弃误填的令牌
    - 固件扩展 MQTT 命令集与按需应答，状态帧补齐名称/阈值/时长/校准点；定时任务与日志复用同一 state 主题
    - MQTT 缓冲 1024 -> 1536，968B 状态报文实测在巴法云 WSS 完整回环
2026-11-07 fix(remote): 显示设备在线状态，定时表单刷新不重置选择
2026-11-07 feat(remote): 预填 uid 与密码，首次只需填指令令牌
2026-11-07 ui(remote): 去掉令牌建议值与说明文字，令牌由用户自行填写
2026-11-07 fix(remote): 通道卡片整卡可点开详情，与局域网操作页行为一致
2026-11-07 fix(remote): 修正在线设备被误报为未上线，离线时采样周期不显示假默认值
2026-11-07 fix(remote): 在线状态以状态帧为准，不再被陈旧 retain online 误导；停报 60 秒自动标离线
2026-11-07 修复未接线通道被误判为 100% 湿度且可浇水
2026-11-07 接线文档同步断线阈值 400，补充单路最小验证接线
2026-11-07 更正接线：继电器用于探头供电 GPIO27，水泵走 MOS D13
2026-11-07 补充杜邦头与继电器螺丝端子的过渡线做法
2026-11-07 补充误区：杜邦公针不可直插螺丝端子，跳线排针不是输入端
2026-11-07 补充 3V3 单针分两路给 COM 与 DC+ 的做法
2026-11-07 补充 DC- 到 GND 的接法与双 GND 针分开走线
2026-11-07 远程页 5 项修复：实时北京时间、通道设置保存/关闭、日志北京时间与浇水间隔、浇水时长取通道设置、移除全局浇水秒数
2026-11-07 固件 1.1.1：状态/日志帧带设备绝对时间与浇水时长，前端改用设备时间
2026-11-07 固件 1.1.2：指令失败回明确原因，远程页故障通道置灰并提示令牌错误
2026-11-07 清理临时探测脚本
2026-11-08 远程页：连上 broker 未收到状态帧时显示等待设备上报中，通道卡片全灰且锁定所有控制
2026-11-08 接线文档：按当前 MOS 方案修正供电总图与电流账，新增 6 路全量落地的母线分配与理线方案
2026-11-08 README：电源规格与接线文档统一为 5V/5A
2026-11-08 新增 PCB 载板规格书与 66 条网表：板型/BOM/布局/下单检查，WIRING 互链
    [netlist.csv]
2026-11-08 PCB.md 新增成本估算：免费打样覆盖条件、元件估价、三档方案对比
2026-11-08 WIRING 新增「只要一套」速查卡：CH1 单路全部接线 + 补料清单 + 上电三步
2026-11-08 WIRING 第十一节改按成品 YYNMOS-4 隔离 MOS 模块接线：省掉分立阻容，补空载极性与 3.3V 触发验证
2026-11-08 WIRING：探头电流改为保守区间 5~20mA/路并重算 3V3 余量，补充 CR2032 纽扣电池不可行的量化结论
2026-11-08 WIRING 补充探头线长度分档、抗干扰三条规矩与超距改放主控的做法
2026-11-08 WIRING 第十一节按 1 主控+6 探头+6 泵重写：4 路 MOS 模块需 2 块、100kΩ 需 6 只、8 芯干线分配
2026-11-08 固件 1.1.3 修复 MQTT 假在线自动重连；远程页连上后主动拉首帧状态
    [config.h, mqtt_link.cpp]
2026-11-08 远程页 App 化：固定顶栏+底部图标标签栏、安装引导、PWA 离线壳与主题色统一
2026-11-08 图标与桌面名称改为大黄智能：蓝底白字图标、short_name/apple title 同步、SW 缓存升版
2026-11-08 图标美化：玻璃感水滴+品牌小字，SW 缓存升 v3
2026-11-08 图标改为纯文字标：去掉水滴，放大「大黄智能」并优化字体与渐变背景，SW 缓存升 v4
2026-11-08 补齐 favicon 与独立 maskable 图标：主动添加到主屏幕也有图标，manifest 走 network-first，SW 升 v5
2026-11-09 接线文档：配件到齐，新增 6 路全量逐针接线总表与通电前三量
2026-11-09 接线文档：新增第十二节 CH1 单路第一批施工卡（含 100k/470µF、模块空载验极性、验收标准）
2026-11-09 接线文档：补泵红黑线极性、低边开关端子验证法与接反后果
2026-11-09 接线文档：补 DC 圆头适配器转接与极性量法，澄清泵线剥线适用范围
2026-11-09 接线文档：补 DC 圆头转接件选型（母座转端子、2.1/2.5 内径、5A 额定）
2026-11-09 接线文档：补 5.5x2.5 母头匹配自测与便宜转接件额定电流/温升提醒
2026-11-09 接线文档：推荐 DC099 带线母座，补规格可选、1mm² 载流与面板件绝缘要点
2026-11-09 接线文档：新增第十三节探头远离主控的距离分档与布局选择
2026-11-09 接线文档：新增第十四节「只有探头远」8 芯干线施工卡，修正双绞矛盾与章节顺序
2026-11-09 接线文档：防水降级为三档做法，去掉 IP65 格兰头硬要求，补防溅散件与探头插土深度
2026-11-09 接线文档：新增 5.2 可下单清单，明确盒子/分线器/3P 型号与网线细线压接坑
2026-11-09 接线文档：新增 5.3 极限省钱版，第一批零采购、六路全量压到 10~25 元
2026-11-09 接线文档：新增 5.4 探头户外使用，明确感应区耐腐蚀/元件面怕水与间歇供电寿命优势
2026-11-09 接线文档：新增 5.5 100kΩ 数量规则（按已接路数配），修正 100k 降低源阻抗的笔误
2026-11-09 接线文档：新增 5.6 电阻直接并在探头插头根部为默认做法，同步下调端子选型要求
2026-11-09 文档：新增远端无源分线板方案（WIRING 5.7 + PCB 第十一节含 21 条网表与成本对比）
2026-11-09 文档：网表实际 20 条，修正两处计数
2026-11-09 文档：远端无源分线板进线改 RJ45 水晶头，补 T568B 引脚映射与选品致命坑
2026-11-09 文档：分线板出线改 3P 直插座，探头免接线直插，补方向/线长/100k 位置三坑
2026-11-12 文档：对齐到货实物丝印（DC+/DC-、PWM/GND 焊盘），补 DC 母座破皮与散件防错
2026-11-12 文档：明确 DC 母座尾线默认极性（红→DC+、黑→DC-）与 30 秒验证法
2026-11-12 文档：补泵线接反后果（有刷泵只反转、无刷泵烧驱动、续流二极管跟着反会短路、假浇水）
2026-11-12 文档：补泵空转耐受说明（分泵型、模块空载与干转区别、假浇水与防干转）
2026-11-12 文档：对齐到货 USB 循环泵参数（非自吸/扬程0.3~0.8m/碳刷寿命/100~200mA），收敛空转与接反结论
2026-11-12 文档：补单电源部署接法（5V 星形分两路、VIN 供电、共地判据改写、USB 倒灌与去耦）
2026-11-12 文档：实物核对板上无清晰 VIN 丝印，5V 改走 USB-C 口，补 VN/VP 误接 5V 致命警示与万用表验证法
2026-11-12 文档：明确打的是探头侧分线板不改供电，USB-C 取电为长期方案，排针仅主控载板情形
2026-11-12 文档：用户以后想打主控载板，新增第十二节规划（模块安装底板、5V排针NC焊位+防倒灌、RJ45配对、实泵校准）
2026-11-12 文档：补「单独沉水试泵」施工卡（只试泵可通电、整机通电需先验极性、水电隔离与滴水弯）
